ShaiMiz/RideOnESP32/docs/hardware/photos/2026-11-02-stock-controller-gap.jpg

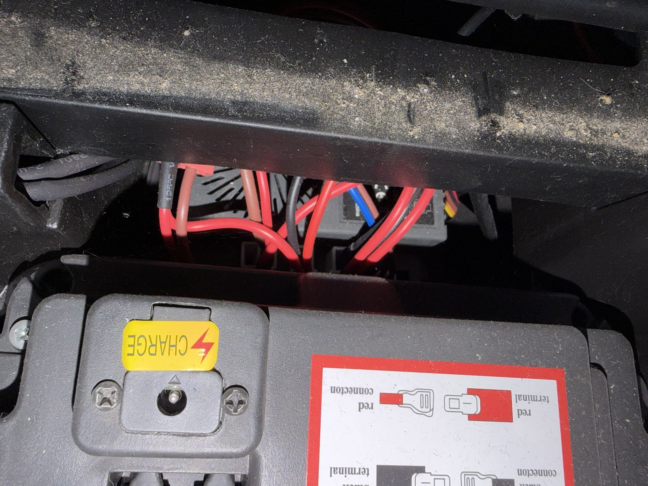
docs/hardware/photos/2026-11-02-stock-controller-gap.jpg
