ShaiMiz/RideOnESP32/docs/hardware/photos/2026-11-02-stock-under-seat.jpg

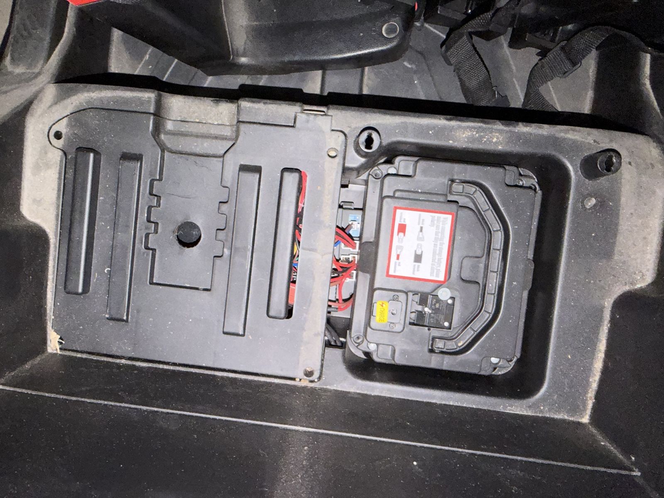
docs/hardware/photos/2026-11-02-stock-under-seat.jpg
