ShaiMiz/RideOnESP32/docs/hardware/photos/README.md

# As-built photos

Photos of the real wiring, named `YYYY-MM-DD-what.jpg` (for example `2026-11-02-power-chain.jpg`). They record what was actually built, which the old project never had.
