ShaiMiz/RideOnESP32/docs/hardware/kicad/NETS.md

<!-- Generated by gen/generate.py from gen/design.py and gen/wiring.py. Edit those, not this file. -->

# Nets (v0.3)

Every net in the schematic with its default wire gauge, colour and protecting fuse, the sheets it appears on and every pin on it. ESP32 signal names are the constants in include/pins.h.

| Net | AWG | Colour | Protected by | Sheets | Pins |
|---|---|---|---|---|---|
| `12V_ACC` | 14 | OG | F6 10 A (24 V side) | accessories rails | F10.1, F9.1, U4.OUT+ |
| `3V3_SENSE` | 22 | VT | U2 current limit | controller drive harness i2c_io rails | D101.1, D102.1, D103.1, D104.1, D105.1, D20.1, J10.5, J11.1, R22.1, R23.1, R24.1, R25.1, R26.1, R27.1, U10.7, U11.7, U12.7, U13.7, U14.7, U2.VOUT, U22.VDD, U23.ADDR, U23.VDD, U24.VCC, U25.VCC, U26.VCC, U27.VCC, U28.VCC, U31.VDD |
| `5V_ACC` | 20 | RD | U3 current limit, F5 | accessories rails | U3.OUT+, U30.1 |
| `5V_LOGIC` | 22 | RD | F4 2 A (24 V side) | controller harness rails | H1.1, H2.1, J10.1, U1.OUT+, U2.VIN, U20.L15, U21.5V, U33.VCC |
| `AMP_12V` | 16 | OG | F10 10 A | accessories | F10.2, U32.VIN+ |
| `BATTERY_SENSE` | 22 | BN | - | controller power | C1.1, R3.2, R4.1, U20.L3 |
| `BATT_DIV` | 22 | OG | F8 1 A | power | F8.2, R3.1 |
| `BATT_FUSED` | 10 | RD | F1 40 A | harness power | F1.2, F2.1, J1.1, K1.A |
| `BATT_RAW` | 10 | RD | none: keep ≤ 15 cm, battery + to F1 | harness | BT1.1, F1.1 |
| `BT_RXD` | 22 | WH | - | controller | R29.2, U33.RXD |
| `BUS_SENSE` | 22 | BN | - | i2c_io power | C2.1, R5.2, R6.1, U23.A2 |
| `COIL_24V` | 20 | OG | F3 1 A | harness power | D1.1, J9.2, K1.C+, S2.22 |
| `COIL_FEED` | 20 | OG | F3 1 A | harness power | F3.2, J9.1, S2.11 |
| `COIL_LOW` | 20 | OG | F3 1 A | power | D1.2, K1.C-, Q1.D |
| `CONTACTOR_HOLD` | 22 | YE | - | controller power | R1.1, R2.1, U20.L12 |
| `CRSF_RX` | 22 | WH | - | controller | U20.R10, U21.TX |
| `CRSF_TX` | 22 | WH | - | controller | U20.R9, U21.RX |
| `DF_RX` | 22 | WH | - | accessories controller | R28.2, U30.2 |
| `DRIVE_EN` | 22 | YE | - | controller drive | R111.1, R112.1, R113.1, R114.1, U10.3, U10.4, U11.3, U11.4, U12.3, U12.4, U13.3, U13.4, U20.R5 |
| `ESTOP_MID` | 20 | OG | F3 1 A | harness | S2.12, S2.21 |
| `ESTOP_SENSE` | 22 | WH | - | harness i2c_io | J9.3, S2.33, U24.P3 |
| `FAN_24V` | 20 | OG | F7 1 A | accessories power | F7.2, FAN1.1, FAN2.1 |
| `FAN_LOW` | 20 | BK/WH | F7 1 A | accessories | FAN1.2, FAN2.2, U29.OUT2 |
| `FAN_PWM` | 22 | BU | - | accessories i2c_io | U28.PWM1, U29.IN2 |
| `FL_DRV_POS` | 12 | RD | F1 40 A + driver current limit | drive | F11.1, U10.M+ |
| `FL_LPWM` | 22 | BU | - | controller drive | U10.2, U20.L9 |
| `FL_M_NEG` | 12 | BK | F1 40 A + driver current limit | drive harness | C201.2, J6.2, M1.2, U10.M- |
| `FL_M_POS` | 12 | RD | F11-F14 15 A (one per motor) | drive harness | C201.1, F11.2, J6.1, M1.1 |
| `FL_RPWM` | 22 | BU | - | controller drive | U10.1, U20.L8 |
| `FR_DRV_POS` | 12 | RD | F1 40 A + driver current limit | drive | F12.1, U11.M+ |
| `FR_LPWM` | 22 | BU | - | controller drive | U11.2, U20.L11 |
| `FR_M_NEG` | 12 | BK | F1 40 A + driver current limit | drive harness | C202.2, J6.4, M2.2, U11.M- |
| `FR_M_POS` | 12 | RD | F11-F14 15 A (one per motor) | drive harness | C202.1, F12.2, J6.3, M2.1 |
| `FR_RPWM` | 22 | BU | - | controller drive | U11.1, U20.L10 |
| `GND` | 22 | BK | - | accessories controller drive harness i2c_io power rails | BT1.2, C1.2, C101.2, C102.2, C103.2, C104.2, C105.2, C111.2, C112.2, C113.2, C114.2, C115.2, C2.2, C20.2, C21.2, C22.2, D2.2, H1.2, H2.2, J1.2, J10.2, J11.2, J3.3, J4.3, J8.4, J9.4, PED1.GND, Q1.S, R111.2, R112.2, R113.2, R114.2, R115.2, R2.2, R21.2, R4.2, R6.2, R7.2, S2.34, SW2.2, SW3.2, SW4.2, SW5.2, TB1.1, TB1.10, TB1.11, TB1.12, TB1.2, TB1.3, TB1.4, TB1.5, TB1.6, TB1.7, TB1.8, TB1.9, U1.IN-, U1.OUT-, U10.8, U10.B-, U11.8, U11.B-, U12.8, U12.B-, U13.8, U13.B-, U14.8, U14.B-, U2.GND, U20.L14, U20.R14, U21.GND, U22.ADDR, U22.GND, U23.GND, U24.GND, U25.DIR, U25.GND, U26.AD0, U26.GND, U27.GND, U28.GND, U28.OE, U29.GND, U29.PGND, U3.IN-, U3.OUT-, U30.7, U31.GND, U32.VIN-, U33.GND, U4.IN-, U4.OUT- |
| `HORN` | 22 | WH | - | harness i2c_io | J8.3, SW4.1, U24.P2 |
| `I2C_SCL` | 22 | GY | - | controller harness i2c_io | J10.6, J11.3, R25.2, U20.R2, U22.SCL, U23.SCL, U24.SCL, U25.SCL, U26.SCL, U27.SCL, U28.SCL |
| `I2C_SDA` | 22 | GN | - | controller harness i2c_io | J10.7, J11.4, R26.2, U20.R1, U22.SDA, U23.SDA, U24.SDA, U25.SDA, U26.SDA, U27.SDA, U28.SDA |
| `IS_FL` | 22 | BN | - | drive i2c_io | C101.1, D101.2, R101.2, U22.A0 |
| `IS_FL_RAW` | 22 | BN | - | drive | R101.1, U10.5, U10.6 |
| `IS_FR` | 22 | BN | - | drive i2c_io | C102.1, D102.2, R102.2, U22.A1 |
| `IS_FR_RAW` | 22 | BN | - | drive | R102.1, U11.5, U11.6 |
| `IS_RL` | 22 | BN | - | drive i2c_io | C103.1, D103.2, R103.2, U22.A2 |
| `IS_RL_RAW` | 22 | BN | - | drive | R103.1, U12.5, U12.6 |
| `IS_RR` | 22 | BN | - | drive i2c_io | C104.1, D104.2, R104.2, U22.A3 |
| `IS_RR_RAW` | 22 | BN | - | drive | R104.1, U13.5, U13.6 |
| `IS_ST` | 22 | BN | - | drive i2c_io | C105.1, D105.2, R105.2, U23.A0 |
| `IS_ST_RAW` | 22 | BN | - | drive | R105.1, U14.5, U14.6 |
| `KEY_24V` | 14 | OG | F2 15 A | harness power | F3.1, F4.1, F5.1, F6.1, F7.1, F8.1, J2.2, SW1.2 |
| `KEY_FEED` | 14 | OG | F2 15 A | harness power | F2.2, J2.1, SW1.1 |
| `LIGHTS_12V` | 20 | OG | F9 3 A | accessories harness | F9.2, J8.1, LP1.1 |
| `LIGHTS_PWM` | 22 | BU | - | accessories i2c_io | U28.PWM0, U29.IN1 |
| `LIGHTS_SW` | 20 | BK/WH | F9 3 A | accessories harness | J8.2, LP1.2, U29.OUT1 |
| `LOG_TX` | 22 | WH | - | controller | R29.1, U20.R3 |
| `MOTOR_24V` | 10 | RD/YE | F1 40 A (after K1) | drive power | C111.1, C112.1, C113.1, C114.1, C115.1, D2.1, K1.B, R5.1, R7.1, TB2.1, TB2.2, TB2.3, TB2.4, TB2.5, TB2.6, TB2.7, TB2.8, U10.B+, U11.B+, U12.B+, U13.B+, U14.B+ |
| `ONEWIRE_TEMP` | 22 | WH | - | controller | R27.2, U20.R13, U31.DQ |
| `PEDAL` | 22 | BN | - | controller | C20.1, D20.2, R20.2, U20.L2 |
| `PEDAL_IN` | 22 | BN | - | controller harness | J3.2, PED1.SIG, R20.1, R21.1 |
| `PEDAL_VCC` | 22 | BN | - | controller harness | J3.1, PED1.V+, R22.2 |
| `Q1_GATE` | 22 | WH | - | power | Q1.G, R1.2 |
| `RL_DRV_POS` | 12 | RD | F1 40 A + driver current limit | drive | F13.1, U12.M+ |
| `RL_LPWM` | 22 | BU | - | controller drive | U12.2, U20.L7 |
| `RL_M_NEG` | 12 | BK | F1 40 A + driver current limit | drive harness | C203.2, J7.2, M3.2, U12.M- |
| `RL_M_POS` | 12 | RD | F11-F14 15 A (one per motor) | drive harness | C203.1, F13.2, J7.1, M3.1 |
| `RL_RPWM` | 22 | BU | - | controller drive | U12.1, U20.L6 |
| `RR_DRV_POS` | 12 | RD | F1 40 A + driver current limit | drive | F14.1, U13.M+ |
| `RR_LPWM` | 22 | BU | - | controller drive | U13.2, U20.R11 |
| `RR_M_NEG` | 12 | BK | F1 40 A + driver current limit | drive harness | C204.2, J7.4, M4.2, U13.M- |
| `RR_M_POS` | 12 | RD | F11-F14 15 A (one per motor) | drive harness | C204.1, F14.2, J7.3, M4.1 |
| `RR_RPWM` | 22 | BU | - | controller drive | U13.1, U20.L13 |
| `SEAT` | 22 | WH | - | harness i2c_io | J10.8, SW5.1, U24.P4 |
| `SHIFT_FORWARD` | 22 | WH | - | harness i2c_io | J4.1, SW2.1, U24.P0 |
| `SHIFT_REVERSE` | 22 | WH | - | harness i2c_io | J4.2, SW3.1, U24.P1 |
| `SOUND_TX` | 22 | WH | - | controller | R28.1, U20.R8 |
| `SPK_ALERT_N` | 18 | BK | amp output | accessories harness | J11.6, LS1.2, U30.8 |
| `SPK_ALERT_P` | 18 | RD | amp output | accessories harness | J11.5, LS1.1, U30.6 |
| `SPK_L_N` | 18 | BK | amp output | accessories harness | J12.2, LS2.2, U32.L- |
| `SPK_L_P` | 18 | RD | amp output | accessories harness | J12.1, LS2.1, U32.L+ |
| `SPK_R_N` | 18 | BK | amp output | accessories harness | J12.4, LS3.2, U32.R- |
| `SPK_R_P` | 18 | RD | amp output | accessories harness | J12.3, LS3.1, U32.R+ |
| `STEER_EN` | 22 | YE | - | controller drive | R115.1, U14.3, U14.4, U20.R12 |
| `STEER_LPWM` | 22 | BU | - | controller drive | U14.2, U20.R6 |
| `STEER_M_NEG` | 12 | BK | F1 40 A + driver current limit | drive harness | C205.2, J5.2, M5.2, U14.M- |
| `STEER_M_POS` | 12 | RD | F1 40 A | drive harness | C205.1, J5.1, M5.1, U14.M+ |
| `STEER_RPWM` | 22 | BU | - | controller drive | U14.1, U20.R7 |
| `U1_IN` | 20 | OG | F4 2 A | power rails | F4.2, U1.IN+ |
| `U3_IN` | 20 | OG | F5 3 A | power rails | F5.2, U3.IN+ |
| `U4_IN` | 16 | OG | F6 10 A | power rails | F6.2, U4.IN+ |
| `WHEEL_SPEED_L` | 22 | WH | - | controller harness | C21.1, H1.3, J10.3, R23.2, U20.L4 |
| `WHEEL_SPEED_R` | 22 | WH | - | controller harness | C22.1, H2.3, J10.4, R24.2, U20.L5 |
