ShaiMiz/RideOnESP32/docs/hardware/kicad/WIRE_LIST.md

<!-- Generated by gen/generate.py from gen/design.py and gen/wiring.py. Edit those, not this file. -->

# Wire list (v0.3)

Every physical wire, generated from the schematic and checked against it: both ends of each run are on the same net, and every pin is reached by a wire, sits on the interface board A1, or is listed at the bottom with the reason. Label each wire at both ends with its W number (heat-shrink labels).

Lengths are not given yet: they wait on the box and under-seat measurements (#18). Gauges are minimums; a heavier wire is always fine. A1:GND, A1:3V3 and A1:5V are the bus strips on the interface board.

## Rules

- **Every fuse protects the wire after it:** the wire is rated above the fuse. 10 AWG after F1 (40 A), 14 AWG after F2 (15 A), 16 AWG after F6/F10 (10 A), 20-22 AWG after the 1-3 A fuses.
- **The only unfused copper** is battery + to F1: keep it under 15 cm and away from metal edges.
- **One ground star (TB1).** Battery −, every driver B−, the buck inputs and the A1 ground bus land there and nowhere else.
- **Run each B+ beside its B−,** and each PWM/EN pair beside a GND wire, to keep loops small.
- **Kill lines (yellow)** never share a connector pin with anything else and never get a pull-up.
- **Motor leads** are protected by F1 and by the BTS7960's own current limit; 12 AWG is rated well above one motor's current.

## Colour code

| Code | Colour | Use |
|---|---|---|
| RD | red | battery + and motor + side (10/12 AWG); 5 V rails (22 AWG) |
| RD/YE | red, yellow band | MOTOR_24V: switched by K1 |
| BK | black | ground, motor − side |
| OG | orange (or red + orange band) | key-switched 24 V branches after F2-F8, 12 V branches |
| VT | violet | 3V3_SENSE |
| YE | yellow | kill lines: DRIVE_EN, STEER_EN, CONTACTOR_HOLD |
| BU | blue | motor PWM (RPWM and LPWM) |
| GY | grey | I2C SCL |
| GN | green | I2C SDA |
| BN | brown | analog: IS sense, pedal, battery sense |
| WH | white | digital inputs, UART, 1-Wire, switch lines |
| BK/WH | black, white band | low-side switched returns (lights, fans) |

## New lead at the battery (2 wires)

| Wire | From | To | Net | AWG | Colour | Protected by | Note |
|---|---|---|---|---|---|---|---|
| W001 | BT1.1 | F1.1 | `BATT_RAW` | 10 | RD | none: keep ≤ 15 cm, battery + to F1 | Ring lug on battery +; ≤ 15 cm, unfused |
| W002 | F1.2 | J1.1 | `BATT_FUSED` | 10 | RD | F1 40 A | Or the stock battery lead if it already has a 40 A fuse this close |

## Inside the box (176 wires)

| Wire | From | To | Net | AWG | Colour | Protected by | Note |
|---|---|---|---|---|---|---|---|
| W004 | J1.1 | K1.A | `BATT_FUSED` | 10 | RD | F1 40 A | M6/M8 ring lugs |
| W005 | J1.2 | TB1.1 | `GND` | 10 | BK | - | Battery − to the ground star |
| W006 | K1.B | TB2.1 | `MOTOR_24V` | 10 | RD/YE | F1 40 A (after K1) |  |
| W007 | TB2.2 | U10.B+ | `MOTOR_24V` | 10 | RD/YE | F1 40 A (after K1) | 470 µF cap on the same terminal |
| W008 | U10.B- | TB1.2 | `GND` | 10 | BK | - | Run beside the B+ wire |
| W009 | TB2.3 | U11.B+ | `MOTOR_24V` | 10 | RD/YE | F1 40 A (after K1) | 470 µF cap on the same terminal |
| W010 | U11.B- | TB1.3 | `GND` | 10 | BK | - | Run beside the B+ wire |
| W011 | TB2.4 | U12.B+ | `MOTOR_24V` | 10 | RD/YE | F1 40 A (after K1) | 470 µF cap on the same terminal |
| W012 | U12.B- | TB1.4 | `GND` | 10 | BK | - | Run beside the B+ wire |
| W013 | TB2.5 | U13.B+ | `MOTOR_24V` | 10 | RD/YE | F1 40 A (after K1) | 470 µF cap on the same terminal |
| W014 | U13.B- | TB1.5 | `GND` | 10 | BK | - | Run beside the B+ wire |
| W015 | TB2.6 | U14.B+ | `MOTOR_24V` | 10 | RD/YE | F1 40 A (after K1) | 470 µF cap on the same terminal |
| W016 | U14.B- | TB1.6 | `GND` | 10 | BK | - | Run beside the B+ wire |
| W017 | K1.A | F2.1 | `BATT_FUSED` | 12 | RD | F1 40 A | The holder's own short 12 AWG lead, ring lug on K1 stud A |
| W018 | F2.2 | J2.1 | `KEY_FEED` | 14 | OG | F2 15 A |  |
| W021 | J2.2 | F3.1 | `KEY_24V` | 14 | OG | F2 15 A | Fuse block bus input; the bus feeds F3-F8 |
| W022 | F3.2 | J9.1 | `COIL_FEED` | 20 | OG | F3 1 A |  |
| W026 | J9.2 | K1.C+ | `COIL_24V` | 20 | OG | F3 1 A | D1 soldered across the coil tabs |
| W027 | K1.C- | Q1.D | `COIL_LOW` | 20 | OG | F3 1 A | To A1 |
| W030 | J9.3 | U24.P3 | `ESTOP_SENSE` | 20 | WH | - |  |
| W031 | J9.4 | A1:GND (interface board bus) | `GND` | 20 | BK | - |  |
| W032 | U20.L12 | R1.1 | `CONTACTOR_HOLD` | 22 | YE | - | Twist with a GND wire |
| W033 | F4.2 | U1.IN+ | `U1_IN` | 20 | OG | F4 2 A |  |
| W034 | F5.2 | U3.IN+ | `U3_IN` | 20 | OG | F5 3 A |  |
| W035 | F6.2 | U4.IN+ | `U4_IN` | 16 | OG | F6 10 A |  |
| W036 | F7.2 | FAN1.1 | `FAN_24V` | 20 | OG | F7 1 A |  |
| W037 | FAN1.1 | FAN2.1 | `FAN_24V` | 20 | OG | F7 1 A |  |
| W038 | FAN1.2 | U29.OUT2 | `FAN_LOW` | 20 | BK/WH | F7 1 A |  |
| W039 | FAN2.2 | U29.OUT2 | `FAN_LOW` | 20 | BK/WH | F7 1 A |  |
| W040 | F8.2 | R3.1 | `BATT_DIV` | 22 | OG | F8 1 A | To A1 |
| W041 | U1.IN- | TB1.7 | `GND` | 20 | BK | - | IN− and OUT− are joined inside the module |
| W042 | U3.IN- | TB1.8 | `GND` | 20 | BK | - |  |
| W043 | U4.IN- | TB1.9 | `GND` | 16 | BK | - |  |
| W044 | A1:GND (interface board bus) | TB1.10 | `GND` | 18 | BK | - | A1 ground bus: the only logic-ground wire to the star |
| W045 | U29.PGND | TB1.11 | `GND` | 20 | BK | - |  |
| W046 | U32.VIN- | TB1.12 | `GND` | 16 | BK | - |  |
| W047 | U1.OUT+ | A1:5V (interface board bus) | `5V_LOGIC` | 20 | RD | F4 2 A (24 V side) |  |
| W048 | A1:5V (interface board bus) | U20.L15 | `5V_LOGIC` | 22 | RD | F4 2 A (24 V side) | ESP32 VIN: 5 V, never 3.3 V |
| W049 | A1:5V (interface board bus) | U21.5V | `5V_LOGIC` | 22 | RD | F4 2 A (24 V side) |  |
| W050 | A1:5V (interface board bus) | U2.VIN | `5V_LOGIC` | 22 | RD | F4 2 A (24 V side) |  |
| W051 | A1:5V (interface board bus) | J10.1 | `5V_LOGIC` | 20 | RD | F4 2 A (24 V side) | Hall sensor supply |
| W052 | U2.VOUT | A1:3V3 (interface board bus) | `3V3_SENSE` | 22 | VT | U2 current limit |  |
| W053 | U2.GND | A1:GND (interface board bus) | `GND` | 22 | BK | - |  |
| W054 | U20.L14 | A1:GND (interface board bus) | `GND` | 22 | BK | - | R14 GND is joined on the board |
| W055 | U21.GND | A1:GND (interface board bus) | `GND` | 22 | BK | - |  |
| W056 | U3.OUT+ | U30.1 | `5V_ACC` | 20 | RD | U3 current limit, F5 | DFPlayer VCC |
| W057 | U30.7 | A1:GND (interface board bus) | `GND` | 22 | BK | - |  |
| W058 | U4.OUT+ | F9.1 | `12V_ACC` | 14 | OG | F6 10 A (24 V side) |  |
| W059 | F9.1 | F10.1 | `12V_ACC` | 14 | OG | F6 10 A (24 V side) | Second inline holder on the same 12 V lead |
| W060 | F10.2 | U32.VIN+ | `AMP_12V` | 16 | OG | F10 10 A |  |
| W061 | F9.2 | J8.1 | `LIGHTS_12V` | 20 | OG | F9 3 A | Lights supply |
| W062 | U29.OUT1 | J8.2 | `LIGHTS_SW` | 20 | BK/WH | F9 3 A | Lights low side |
| W063 | U20.L8 | U10.1 | `FL_RPWM` | 22 | BU | - | Control cable: twist PWM and EN with GND |
| W064 | U20.L9 | U10.2 | `FL_LPWM` | 22 | BU | - |  |
| W065 | U20.R5 | U10.3 | `DRIVE_EN` | 22 | YE | - | DRIVE_EN daisy chain, ESP32 → FL → FR → RL → RR |
| W066 | U20.L10 | U11.1 | `FR_RPWM` | 22 | BU | - | Control cable: twist PWM and EN with GND |
| W067 | U20.L11 | U11.2 | `FR_LPWM` | 22 | BU | - |  |
| W068 | U10.3 | U11.3 | `DRIVE_EN` | 22 | YE | - | DRIVE_EN daisy chain, ESP32 → FL → FR → RL → RR |
| W069 | U20.L6 | U12.1 | `RL_RPWM` | 22 | BU | - | Control cable: twist PWM and EN with GND |
| W070 | U20.L7 | U12.2 | `RL_LPWM` | 22 | BU | - |  |
| W071 | U11.3 | U12.3 | `DRIVE_EN` | 22 | YE | - | DRIVE_EN daisy chain, ESP32 → FL → FR → RL → RR |
| W072 | U20.L13 | U13.1 | `RR_RPWM` | 22 | BU | - | Control cable: twist PWM and EN with GND |
| W073 | U20.R11 | U13.2 | `RR_LPWM` | 22 | BU | - |  |
| W074 | U12.3 | U13.3 | `DRIVE_EN` | 22 | YE | - | DRIVE_EN daisy chain, ESP32 → FL → FR → RL → RR |
| W075 | U10.3 | U10.4 | `DRIVE_EN` | 22 | YE | - | Jumper in the plug: R_EN = L_EN; the 10k pull-down sits in the plug too |
| W076 | U10.5 | U10.6 | `IS_FL_RAW` | 22 | BN | - | Jumper in the plug: R_IS = L_IS |
| W077 | U10.5 | R101.1 | `IS_FL_RAW` | 22 | BN | - | IS to A1 |
| W078 | A1:3V3 (interface board bus) | U10.7 | `3V3_SENSE` | 22 | VT | U2 current limit | Logic VCC |
| W079 | A1:GND (interface board bus) | U10.8 | `GND` | 22 | BK | - | Signal reference; B− is the power ground |
| W080 | U10.M+ | J6.1 | `FL_M_POS` | 12 | RD | F1 40 A + driver current limit |  |
| W081 | U10.M- | J6.2 | `FL_M_NEG` | 12 | BK | F1 40 A + driver current limit |  |
| W082 | U11.3 | U11.4 | `DRIVE_EN` | 22 | YE | - | Jumper in the plug: R_EN = L_EN; the 10k pull-down sits in the plug too |
| W083 | U11.5 | U11.6 | `IS_FR_RAW` | 22 | BN | - | Jumper in the plug: R_IS = L_IS |
| W084 | U11.5 | R102.1 | `IS_FR_RAW` | 22 | BN | - | IS to A1 |
| W085 | A1:3V3 (interface board bus) | U11.7 | `3V3_SENSE` | 22 | VT | U2 current limit | Logic VCC |
| W086 | A1:GND (interface board bus) | U11.8 | `GND` | 22 | BK | - | Signal reference; B− is the power ground |
| W087 | U11.M+ | J6.3 | `FR_M_POS` | 12 | RD | F1 40 A + driver current limit |  |
| W088 | U11.M- | J6.4 | `FR_M_NEG` | 12 | BK | F1 40 A + driver current limit |  |
| W089 | U12.3 | U12.4 | `DRIVE_EN` | 22 | YE | - | Jumper in the plug: R_EN = L_EN; the 10k pull-down sits in the plug too |
| W090 | U12.5 | U12.6 | `IS_RL_RAW` | 22 | BN | - | Jumper in the plug: R_IS = L_IS |
| W091 | U12.5 | R103.1 | `IS_RL_RAW` | 22 | BN | - | IS to A1 |
| W092 | A1:3V3 (interface board bus) | U12.7 | `3V3_SENSE` | 22 | VT | U2 current limit | Logic VCC |
| W093 | A1:GND (interface board bus) | U12.8 | `GND` | 22 | BK | - | Signal reference; B− is the power ground |
| W094 | U12.M+ | J7.1 | `RL_M_POS` | 12 | RD | F1 40 A + driver current limit |  |
| W095 | U12.M- | J7.2 | `RL_M_NEG` | 12 | BK | F1 40 A + driver current limit |  |
| W096 | U13.3 | U13.4 | `DRIVE_EN` | 22 | YE | - | Jumper in the plug: R_EN = L_EN; the 10k pull-down sits in the plug too |
| W097 | U13.5 | U13.6 | `IS_RR_RAW` | 22 | BN | - | Jumper in the plug: R_IS = L_IS |
| W098 | U13.5 | R104.1 | `IS_RR_RAW` | 22 | BN | - | IS to A1 |
| W099 | A1:3V3 (interface board bus) | U13.7 | `3V3_SENSE` | 22 | VT | U2 current limit | Logic VCC |
| W100 | A1:GND (interface board bus) | U13.8 | `GND` | 22 | BK | - | Signal reference; B− is the power ground |
| W101 | U13.M+ | J7.3 | `RR_M_POS` | 12 | RD | F1 40 A + driver current limit |  |
| W102 | U13.M- | J7.4 | `RR_M_NEG` | 12 | BK | F1 40 A + driver current limit |  |
| W103 | U20.R7 | U14.1 | `STEER_RPWM` | 22 | BU | - | Control cable: twist PWM and EN with GND |
| W104 | U20.R6 | U14.2 | `STEER_LPWM` | 22 | BU | - |  |
| W105 | U20.R12 | U14.3 | `STEER_EN` | 22 | YE | - | STEER_EN |
| W106 | U14.3 | U14.4 | `STEER_EN` | 22 | YE | - | Jumper in the plug: R_EN = L_EN; the 10k pull-down sits in the plug too |
| W107 | U14.5 | U14.6 | `IS_ST_RAW` | 22 | BN | - | Jumper in the plug: R_IS = L_IS |
| W108 | U14.5 | R105.1 | `IS_ST_RAW` | 22 | BN | - | IS to A1 |
| W109 | A1:3V3 (interface board bus) | U14.7 | `3V3_SENSE` | 22 | VT | U2 current limit | Logic VCC |
| W110 | A1:GND (interface board bus) | U14.8 | `GND` | 22 | BK | - | Signal reference; B− is the power ground |
| W111 | U14.M+ | J5.1 | `STEER_M_POS` | 12 | RD | F1 40 A + driver current limit |  |
| W112 | U14.M- | J5.2 | `STEER_M_NEG` | 12 | BK | F1 40 A + driver current limit |  |
| W123 | U20.L2 | R20.2 | `PEDAL` | 22 | BN | - | PEDAL to A1 |
| W124 | U20.L3 | R3.2 | `BATTERY_SENSE` | 22 | BN | - | BATTERY_SENSE to A1 |
| W125 | U20.L4 | R23.2 | `WHEEL_SPEED_L` | 22 | WH | - | WHEEL_SPEED_L to A1 |
| W126 | U20.L5 | R24.2 | `WHEEL_SPEED_R` | 22 | WH | - | WHEEL_SPEED_R to A1 |
| W127 | U20.R13 | R27.2 | `ONEWIRE_TEMP` | 22 | WH | - | ONEWIRE_TEMP to A1 |
| W128 | U20.R8 | R28.1 | `SOUND_TX` | 22 | WH | - | SOUND_TX to A1 |
| W129 | R28.2 | U30.2 | `DF_RX` | 22 | WH | - | DF_RX |
| W130 | U20.R10 | U21.TX | `CRSF_RX` | 22 | WH | - | CRSF: receiver TX → ESP32 RX |
| W131 | U20.R9 | U21.RX | `CRSF_TX` | 22 | WH | - | CRSF: ESP32 TX → receiver RX |
| W132 | R1.2 | Q1.G | `Q1_GATE` | 22 | WH | - | On A1 (listed because Q1 is a TO-220 on flying leads if not on the board) |
| W133 | R101.2 | U22.A0 | `IS_FL` | 22 | BN | - |  |
| W134 | R102.2 | U22.A1 | `IS_FR` | 22 | BN | - |  |
| W135 | R103.2 | U22.A2 | `IS_RL` | 22 | BN | - |  |
| W136 | R104.2 | U22.A3 | `IS_RR` | 22 | BN | - |  |
| W137 | R105.2 | U23.A0 | `IS_ST` | 22 | BN | - |  |
| W138 | R5.2 | R6.1 | `BUS_SENSE` | 22 | BN | - | BUS_SENSE from the R5 lead at TB2 to A1 |
| W139 | R6.1 | U23.A2 | `BUS_SENSE` | 22 | BN | - |  |
| W140 | R7.2 | A1:GND (interface board bus) | `GND` | 20 | BK | - | Bleed return |
| W141 | A1:3V3 (interface board bus) | R22.1 | `3V3_SENSE` | 22 | VT | U2 current limit | On A1 |
| W142 | R22.2 | J3.1 | `PEDAL_VCC` | 22 | BN | - | Pedal supply |
| W143 | J3.2 | R20.1 | `PEDAL_IN` | 22 | BN | - | Pedal signal |
| W144 | J3.3 | A1:GND (interface board bus) | `GND` | 22 | BK | - |  |
| W148 | U31.DQ | R27.2 | `ONEWIRE_TEMP` | 22 | WH | - | DS18B20 yellow |
| W149 | U31.VDD | A1:3V3 (interface board bus) | `3V3_SENSE` | 22 | VT | U2 current limit | DS18B20 red |
| W150 | U31.GND | A1:GND (interface board bus) | `GND` | 22 | BK | - | DS18B20 black |
| W151 | U20.R2 | U22.SCL | `I2C_SCL` | 22 | GY | - | I2C bus start; keep SCL and SDA beside GND |
| W152 | U20.R1 | U22.SDA | `I2C_SDA` | 22 | GN | - |  |
| W153 | A1:3V3 (interface board bus) | U22.VDD | `3V3_SENSE` | 22 | VT | U2 current limit |  |
| W154 | A1:GND (interface board bus) | U22.GND | `GND` | 22 | BK | - |  |
| W155 | U22.SCL | U23.SCL | `I2C_SCL` | 22 | GY | - | I2C chain |
| W156 | U22.SDA | U23.SDA | `I2C_SDA` | 22 | GN | - | I2C chain |
| W157 | U22.VDD | U23.VDD | `3V3_SENSE` | 22 | VT | U2 current limit | I2C chain |
| W158 | U22.GND | U23.GND | `GND` | 22 | BK | - | I2C chain |
| W159 | U23.SCL | U24.SCL | `I2C_SCL` | 22 | GY | - | I2C chain |
| W160 | U23.SDA | U24.SDA | `I2C_SDA` | 22 | GN | - | I2C chain |
| W161 | U23.VDD | U24.VCC | `3V3_SENSE` | 22 | VT | U2 current limit | I2C chain |
| W162 | U23.GND | U24.GND | `GND` | 22 | BK | - | I2C chain |
| W163 | U24.SCL | U26.SCL | `I2C_SCL` | 22 | GY | - | I2C chain |
| W164 | U24.SDA | U26.SDA | `I2C_SDA` | 22 | GN | - | I2C chain |
| W165 | U24.VCC | U26.VCC | `3V3_SENSE` | 22 | VT | U2 current limit | I2C chain |
| W166 | U24.GND | U26.GND | `GND` | 22 | BK | - | I2C chain |
| W167 | U26.SCL | U28.SCL | `I2C_SCL` | 22 | GY | - | I2C chain |
| W168 | U26.SDA | U28.SDA | `I2C_SDA` | 22 | GN | - | I2C chain |
| W169 | U26.VCC | U28.VCC | `3V3_SENSE` | 22 | VT | U2 current limit | I2C chain |
| W170 | U26.GND | U28.GND | `GND` | 22 | BK | - | I2C chain |
| W171 | U22.ADDR | U22.GND | `GND` | 22 | BK | - | Address 0x48 |
| W172 | U23.ADDR | U23.VDD | `3V3_SENSE` | 22 | VT | U2 current limit | Address 0x49 |
| W173 | U26.AD0 | U26.GND | `GND` | 22 | BK | - | Address 0x68 |
| W174 | U28.OE | U28.GND | `GND` | 22 | BK | - | Outputs always enabled |
| W175 | U28.SCL | J10.6 | `I2C_SCL` | 20 | GY | - | Off-box I2C branch: steering column |
| W176 | U28.SDA | J10.7 | `I2C_SDA` | 20 | GN | - |  |
| W177 | A1:3V3 (interface board bus) | J10.5 | `3V3_SENSE` | 20 | VT | U2 current limit |  |
| W178 | A1:GND (interface board bus) | J10.2 | `GND` | 20 | BK | - |  |
| W179 | U28.SCL | J11.3 | `I2C_SCL` | 20 | GY | - | Off-box I2C branch: dash |
| W180 | U28.SDA | J11.4 | `I2C_SDA` | 20 | GN | - |  |
| W181 | A1:3V3 (interface board bus) | J11.1 | `3V3_SENSE` | 20 | VT | U2 current limit |  |
| W182 | A1:GND (interface board bus) | J11.2 | `GND` | 20 | BK | - |  |
| W183 | U28.PWM0 | U29.IN1 | `LIGHTS_PWM` | 22 | BU | - | Lights PWM |
| W184 | U28.PWM1 | U29.IN2 | `FAN_PWM` | 22 | BU | - | Fan PWM |
| W185 | U29.GND | A1:GND (interface board bus) | `GND` | 22 | BK | - |  |
| W186 | J4.1 | U24.P0 | `SHIFT_FORWARD` | 22 | WH | - |  |
| W187 | J4.2 | U24.P1 | `SHIFT_REVERSE` | 22 | WH | - |  |
| W188 | J4.3 | A1:GND (interface board bus) | `GND` | 22 | BK | - |  |
| W193 | J8.3 | U24.P2 | `HORN` | 22 | WH | - | Horn button |
| W194 | J8.4 | A1:GND (interface board bus) | `GND` | 22 | BK | - |  |
| W199 | J10.8 | U24.P4 | `SEAT` | 20 | WH | - | Seat switch |
| W200 | J10.3 | R23.2 | `WHEEL_SPEED_L` | 20 | WH | - | WHEEL_SPEED_L to A1 |
| W201 | J10.4 | R24.2 | `WHEEL_SPEED_R` | 20 | WH | - | WHEEL_SPEED_R to A1 |
| W219 | U30.6 | J11.5 | `SPK_ALERT_P` | 18 | RD | amp output |  |
| W220 | U30.8 | J11.6 | `SPK_ALERT_N` | 18 | BK | amp output |  |
| W223 | U32.L+ | J12.1 | `SPK_L_P` | 18 | RD | amp output |  |
| W224 | U32.L- | J12.2 | `SPK_L_N` | 18 | BK | amp output |  |
| W225 | U32.R+ | J12.3 | `SPK_R_P` | 18 | RD | amp output |  |
| W226 | U32.R- | J12.4 | `SPK_R_N` | 18 | BK | amp output |  |

## Our new off-box harnesses (J9-J12) (28 wires)

| Wire | From | To | Net | AWG | Colour | Protected by | Note |
|---|---|---|---|---|---|---|---|
| W023 | J9.1 | S2.11 | `COIL_FEED` | 20 | OG | F3 1 A | E-stop cable, 4-core |
| W024 | S2.12 | S2.21 | `ESTOP_MID` | 20 | OG | F3 1 A | Jumper inside the E-stop: NC1 and NC2 in series |
| W025 | S2.22 | J9.2 | `COIL_24V` | 20 | OG | F3 1 A |  |
| W028 | S2.33 | J9.3 | `ESTOP_SENSE` | 20 | WH | - |  |
| W029 | S2.34 | J9.4 | `GND` | 20 | BK | - |  |
| W202 | J10.1 | H1.1 | `5V_LOGIC` | 20 | RD | F4 2 A (24 V side) | Split to both wheels |
| W203 | J10.1 | H2.1 | `5V_LOGIC` | 20 | RD | F4 2 A (24 V side) |  |
| W204 | J10.2 | H1.2 | `GND` | 20 | BK | - |  |
| W205 | J10.2 | H2.2 | `GND` | 20 | BK | - |  |
| W206 | J10.3 | H1.3 | `WHEEL_SPEED_L` | 20 | WH | - |  |
| W207 | J10.4 | H2.3 | `WHEEL_SPEED_R` | 20 | WH | - |  |
| W208 | J10.5 | U25.VCC | `3V3_SENSE` | 20 | VT | U2 current limit | AS5600: ≤ 30 cm of I2C, twisted with GND |
| W209 | J10.2 | U25.GND | `GND` | 20 | BK | - |  |
| W210 | J10.6 | U25.SCL | `I2C_SCL` | 20 | GY | - |  |
| W211 | J10.7 | U25.SDA | `I2C_SDA` | 20 | GN | - |  |
| W212 | U25.DIR | U25.GND | `GND` | 20 | BK | - | Jumper on the sensor board |
| W213 | J10.8 | SW5.1 | `SEAT` | 20 | WH | - |  |
| W214 | SW5.2 | J10.2 | `GND` | 20 | BK | - |  |
| W215 | J11.1 | U27.VCC | `3V3_SENSE` | 20 | VT | U2 current limit |  |
| W216 | J11.2 | U27.GND | `GND` | 20 | BK | - |  |
| W217 | J11.3 | U27.SCL | `I2C_SCL` | 20 | GY | - |  |
| W218 | J11.4 | U27.SDA | `I2C_SDA` | 20 | GN | - |  |
| W221 | J11.5 | LS1.1 | `SPK_ALERT_P` | 18 | RD | amp output |  |
| W222 | J11.6 | LS1.2 | `SPK_ALERT_N` | 18 | BK | amp output |  |
| W227 | J12.1 | LS2.1 | `SPK_L_P` | 18 | RD | amp output |  |
| W228 | J12.2 | LS2.2 | `SPK_L_N` | 18 | BK | amp output |  |
| W229 | J12.3 | LS3.1 | `SPK_R_P` | 18 | RD | amp output |  |
| W230 | J12.4 | LS3.2 | `SPK_R_N` | 18 | BK | amp output |  |

## The car's own harness: listed so the circuit is complete, not touched (24 wires)

| Wire | From | To | Net | AWG | Colour | Protected by | Note |
|---|---|---|---|---|---|---|---|
| W003 | BT1.2 | J1.2 | `GND` | stock | stock | - | Battery − |
| W019 | J2.1 | SW1.1 | `KEY_FEED` | stock | stock | F2 15 A | Key switch |
| W020 | SW1.2 | J2.2 | `KEY_24V` | stock | stock | F2 15 A |  |
| W113 | J6.1 | M1.1 | `FL_M_POS` | stock | stock | F1 40 A + driver current limit | Stock motor wiring (or the splitter, #33) |
| W114 | J6.2 | M1.2 | `FL_M_NEG` | stock | stock | F1 40 A + driver current limit | Stock motor wiring (or the splitter, #33) |
| W115 | J6.3 | M2.1 | `FR_M_POS` | stock | stock | F1 40 A + driver current limit | Stock motor wiring (or the splitter, #33) |
| W116 | J6.4 | M2.2 | `FR_M_NEG` | stock | stock | F1 40 A + driver current limit | Stock motor wiring (or the splitter, #33) |
| W117 | J7.1 | M3.1 | `RL_M_POS` | stock | stock | F1 40 A + driver current limit | Stock motor wiring (or the splitter, #33) |
| W118 | J7.2 | M3.2 | `RL_M_NEG` | stock | stock | F1 40 A + driver current limit | Stock motor wiring (or the splitter, #33) |
| W119 | J7.3 | M4.1 | `RR_M_POS` | stock | stock | F1 40 A + driver current limit | Stock motor wiring (or the splitter, #33) |
| W120 | J7.4 | M4.2 | `RR_M_NEG` | stock | stock | F1 40 A + driver current limit | Stock motor wiring (or the splitter, #33) |
| W121 | J5.1 | M5.1 | `STEER_M_POS` | stock | stock | F1 40 A + driver current limit | Stock motor wiring (or the splitter, #33) |
| W122 | J5.2 | M5.2 | `STEER_M_NEG` | stock | stock | F1 40 A + driver current limit | Stock motor wiring (or the splitter, #33) |
| W145 | J3.1 | PED1.V+ | `PEDAL_VCC` | stock | stock | - |  |
| W146 | J3.2 | PED1.SIG | `PEDAL_IN` | stock | stock | - |  |
| W147 | J3.3 | PED1.GND | `GND` | stock | stock | - |  |
| W189 | J4.1 | SW2.1 | `SHIFT_FORWARD` | stock | stock | - |  |
| W190 | SW2.2 | J4.3 | `GND` | stock | stock | - |  |
| W191 | J4.2 | SW3.1 | `SHIFT_REVERSE` | stock | stock | - |  |
| W192 | SW3.2 | J4.3 | `GND` | stock | stock | - |  |
| W195 | J8.3 | SW4.1 | `HORN` | stock | stock | - |  |
| W196 | SW4.2 | J8.4 | `GND` | stock | stock | - |  |
| W197 | J8.1 | LP1.1 | `LIGHTS_12V` | stock | stock | F9 3 A | Lights (voltage TBD) |
| W198 | LP1.2 | J8.2 | `LIGHTS_SW` | stock | stock | F9 3 A |  |

## Pins with no wire of their own

| Pin | Why |
|---|---|
| C111.1 | 470 µF leads under the driver's B+/B− screw terminals |
| C111.2 | 470 µF leads under the driver's B+/B− screw terminals |
| C112.1 | 470 µF leads under the driver's B+/B− screw terminals |
| C112.2 | 470 µF leads under the driver's B+/B− screw terminals |
| C113.1 | 470 µF leads under the driver's B+/B− screw terminals |
| C113.2 | 470 µF leads under the driver's B+/B− screw terminals |
| C114.1 | 470 µF leads under the driver's B+/B− screw terminals |
| C114.2 | 470 µF leads under the driver's B+/B− screw terminals |
| C115.1 | 470 µF leads under the driver's B+/B− screw terminals |
| C115.2 | 470 µF leads under the driver's B+/B− screw terminals |
| C201.1 | Soldered across the motor tabs |
| C201.2 | Soldered across the motor tabs |
| C202.1 | Soldered across the motor tabs |
| C202.2 | Soldered across the motor tabs |
| C203.1 | Soldered across the motor tabs |
| C203.2 | Soldered across the motor tabs |
| C204.1 | Soldered across the motor tabs |
| C204.2 | Soldered across the motor tabs |
| C205.1 | Soldered across the motor tabs |
| C205.2 | Soldered across the motor tabs |
| D1.1 | Soldered across the K1 coil tabs |
| D1.2 | Soldered across the K1 coil tabs |
| D2.1 | TVS on TB2 / TB1 (not fitted yet) |
| D2.2 | TVS on TB2 / TB1 (not fitted yet) |
| F4.1 | Fuse block common bus (fed by F3.1) |
| F5.1 | Fuse block common bus (fed by F3.1) |
| F6.1 | Fuse block common bus (fed by F3.1) |
| F7.1 | Fuse block common bus (fed by F3.1) |
| F8.1 | Fuse block common bus (fed by F3.1) |
| R111.1 | 10k soldered inside the driver's control plug, EN to GND |
| R111.2 | 10k soldered inside the driver's control plug, EN to GND |
| R112.1 | 10k soldered inside the driver's control plug, EN to GND |
| R112.2 | 10k soldered inside the driver's control plug, EN to GND |
| R113.1 | 10k soldered inside the driver's control plug, EN to GND |
| R113.2 | 10k soldered inside the driver's control plug, EN to GND |
| R114.1 | 10k soldered inside the driver's control plug, EN to GND |
| R114.2 | 10k soldered inside the driver's control plug, EN to GND |
| R115.1 | 10k soldered inside the driver's control plug, EN to GND |
| R115.2 | 10k soldered inside the driver's control plug, EN to GND |
| R5.1 | Lead in a ring lug on TB2.8 |
| R7.1 | Lead in a ring lug on TB2.8 |
| TB2.7 | Spare stud position (D2) |
| TB2.8 | Ring lug holding the R5 and R7 leads |
| U1.OUT- | Joined to IN− inside the module |
| U20.R14 | Joined to L14 on the board |
| U3.OUT- | Joined to IN− inside the module |
| U4.OUT- | Joined to IN− inside the module |
