ShaiMiz/RideOnESP32/docs/hardware/kicad/CONNECTORS.md

<!-- Generated by gen/generate.py from gen/design.py and gen/wiring.py. Edit those, not this file. -->

# Connectors and pinouts (v0.3)

Every plug on the box edge. **J1-J8 face the stock harness:** each must be the mate of the stock plug so the box swaps with the stock HY2005RX controller (plug and play). Their families, pin counts and pin order are **TBD** until the photos of the stock plugs (#17); the pin numbers below are our own until then. **J9-J12 are our own** sealed plugs for parts the stock car doesn't have.

J8 and J9 each carry a supply line (12 V lights, 24 V coil chain) next to a 3.3 V input of U24. A pin-to-pin short there could reach the PCF8574, so keep those pins apart: in J9 the coil pair (1, 2) sits away from the sense pair (3, 4); J8's order waits on the stock plug.

| Ref | Name | Pins | Faces | Part | Status |
|---|---|---|---|---|---|
| J1 | BATTERY | 2 | stock harness (TBD #17) | Mate of the stock battery plug (fallback: Anderson SB50) | TBD |
| J2 | KEY | 2 | stock harness (TBD #17) | Mate of the stock key-switch plug | TBD |
| J3 | PEDAL | 3 | stock harness (TBD #17) | Mate of the stock pedal plug | TBD |
| J4 | SHIFTER | 3 | stock harness (TBD #17) | Mate of the stock shifter plug | TBD |
| J5 | STEER MOTOR | 2 | stock harness (TBD #17) | Mate of the stock steering-motor plug (fallback: XT60, owned) | TBD |
| J6 | FRONT MOTORS | 4 | stock harness (TBD #17) | Mate of the stock front-motor plug(s); if the harness pairs the motors, a reversible splitter at the motor plugs (fallback: 2 x XT60) | TBD |
| J7 | REAR MOTORS | 4 | stock harness (TBD #17) | Mate of the stock rear-motor plug(s); splitter as J6 (fallback: 2 x XT60) | TBD |
| J8 | ACCESSORIES | 4 | stock harness (TBD #17) | Mate of the stock lights/horn plug (pin use TBD from photos) | TBD |
| J9 | E-STOP | 4 | our harness | Sealed 4-way, Deutsch DT04-4P / DT06-4S (or DT-style clone) | To buy |
| J10 | SENSORS | 8 | our harness | Sealed 8-way, Deutsch DT04-08PA / DT06-08SA (or clone) | To buy |
| J11 | DASH | 6 | our harness | Sealed 6-way, Deutsch DT04-6P / DT06-6S (or clone) | To buy |
| J12 | MUSIC | 4 | our harness | 4-way, Deutsch DT04-4P / DT06-4S (or clone) | To buy |

## J1 BATTERY

Mate of the stock battery plug (fallback: Anderson SB50). Status: TBD (#17).

| Pin | Net | AWG | Colour | Protected by | Box side | Car side |
|---|---|---|---|---|---|---|
| 1 | `BATT_FUSED` | 10 | RD | F1 40 A | K1.A (W004) | F1.2 (W002) |
| 2 | `GND` | 10 | BK | - | TB1.1 (W005) | BT1.2 (W003) |

## J2 KEY

Mate of the stock key-switch plug. Status: TBD (#17).

| Pin | Net | AWG | Colour | Protected by | Box side | Car side |
|---|---|---|---|---|---|---|
| 1 | `KEY_FEED` | 14 | OG | F2 15 A | F2.2 (W018) | SW1.1 (W019) |
| 2 | `KEY_24V` | 14 | OG | F2 15 A | F3.1 (W021) | SW1.2 (W020) |

## J3 PEDAL

Mate of the stock pedal plug. Status: TBD (#17).

| Pin | Net | AWG | Colour | Protected by | Box side | Car side |
|---|---|---|---|---|---|---|
| 1 | `PEDAL_VCC` | 22 | BN | - | R22.2 (W139) | PED1.V+ (W142) |
| 2 | `PEDAL_IN` | 22 | BN | - | R20.1 (W140) | PED1.SIG (W143) |
| 3 | `GND` | 22 | BK | - | A1:GND (W141) | PED1.GND (W144) |

## J4 SHIFTER

Mate of the stock shifter plug. Status: TBD (#17).

| Pin | Net | AWG | Colour | Protected by | Box side | Car side |
|---|---|---|---|---|---|---|
| 1 | `SHIFT_FORWARD` | 22 | WH | - | U24.P0 (W183) | SW2.1 (W186) |
| 2 | `SHIFT_REVERSE` | 22 | WH | - | U24.P1 (W184) | SW3.1 (W188) |
| 3 | `GND` | 22 | BK | - | A1:GND (W185) | SW2.2 (W187), SW3.2 (W189) |

## J5 STEER MOTOR

Mate of the stock steering-motor plug (fallback: XT60, owned). Status: TBD (#17).

| Pin | Net | AWG | Colour | Protected by | Box side | Car side |
|---|---|---|---|---|---|---|
| 1 | `STEER_M_POS` | 12 | RD | F1 40 A + driver current limit | U14.M+ (W111) | M5.1 (W121) |
| 2 | `STEER_M_NEG` | 12 | BK | F1 40 A + driver current limit | U14.M- (W112) | M5.2 (W122) |

## J6 FRONT MOTORS

Mate of the stock front-motor plug(s); if the harness pairs the motors, a reversible splitter at the motor plugs (fallback: 2 x XT60). Status: TBD (#17, #33).

| Pin | Net | AWG | Colour | Protected by | Box side | Car side |
|---|---|---|---|---|---|---|
| 1 | `FL_M_POS` | 12 | RD | F1 40 A + driver current limit | U10.M+ (W080) | M1.1 (W113) |
| 2 | `FL_M_NEG` | 12 | BK | F1 40 A + driver current limit | U10.M- (W081) | M1.2 (W114) |
| 3 | `FR_M_POS` | 12 | RD | F1 40 A + driver current limit | U11.M+ (W087) | M2.1 (W115) |
| 4 | `FR_M_NEG` | 12 | BK | F1 40 A + driver current limit | U11.M- (W088) | M2.2 (W116) |

## J7 REAR MOTORS

Mate of the stock rear-motor plug(s); splitter as J6 (fallback: 2 x XT60). Status: TBD (#17, #33).

| Pin | Net | AWG | Colour | Protected by | Box side | Car side |
|---|---|---|---|---|---|---|
| 1 | `RL_M_POS` | 12 | RD | F1 40 A + driver current limit | U12.M+ (W094) | M3.1 (W117) |
| 2 | `RL_M_NEG` | 12 | BK | F1 40 A + driver current limit | U12.M- (W095) | M3.2 (W118) |
| 3 | `RR_M_POS` | 12 | RD | F1 40 A + driver current limit | U13.M+ (W101) | M4.1 (W119) |
| 4 | `RR_M_NEG` | 12 | BK | F1 40 A + driver current limit | U13.M- (W102) | M4.2 (W120) |

## J8 ACCESSORIES

Mate of the stock lights/horn plug (pin use TBD from photos). Status: TBD (#17).

| Pin | Net | AWG | Colour | Protected by | Box side | Car side |
|---|---|---|---|---|---|---|
| 1 | `LIGHTS_12V` | 20 | OG | F9 3 A | F9.2 (W061) | LP1.1 (W194) |
| 2 | `LIGHTS_SW` | 20 | BK/WH | F9 3 A | U29.OUT1 (W062) | LP1.2 (W195) |
| 3 | `HORN` | 22 | WH | - | U24.P2 (W190) | SW4.1 (W192) |
| 4 | `GND` | 22 | BK | - | A1:GND (W191) | SW4.2 (W193) |

## J9 E-STOP

Sealed 4-way, Deutsch DT04-4P / DT06-4S (or DT-style clone). Status: To buy. Our own plug: E-stop on the dash.

| Pin | Net | AWG | Colour | Protected by | Box side | Car side |
|---|---|---|---|---|---|---|
| 1 | `COIL_FEED` | 20 | OG | F3 1 A | F3.2 (W022) | S2.11 (W023) |
| 2 | `COIL_24V` | 20 | OG | F3 1 A | K1.C+ (W026) | S2.22 (W025) |
| 3 | `ESTOP_SENSE` | 20 | WH | - | U24.P3 (W030) | S2.33 (W028) |
| 4 | `GND` | 20 | BK | - | A1:GND (W031) | S2.34 (W029) |

## J10 SENSORS

Sealed 8-way, Deutsch DT04-08PA / DT06-08SA (or clone). Status: To buy. Our own plug: halls, steering angle, seat.

| Pin | Net | AWG | Colour | Protected by | Box side | Car side |
|---|---|---|---|---|---|---|
| 1 | `5V_LOGIC` | 20 | RD | F4 2 A (24 V side) | A1:5V (W051) | H1.1 (W199), H2.1 (W200) |
| 2 | `GND` | 20 | BK | - | A1:GND (W175) | H1.2 (W201), H2.2 (W202), U25.GND (W206), SW5.2 (W211) |
| 3 | `WHEEL_SPEED_L` | 20 | WH | - | R23.2 (W197) | H1.3 (W203) |
| 4 | `WHEEL_SPEED_R` | 20 | WH | - | R24.2 (W198) | H2.3 (W204) |
| 5 | `3V3_SENSE` | 20 | VT | U2 current limit | A1:3V3 (W174) | U25.VCC (W205) |
| 6 | `I2C_SCL` | 20 | GY | - | U28.SCL (W172) | U25.SCL (W207) |
| 7 | `I2C_SDA` | 20 | GN | - | U28.SDA (W173) | U25.SDA (W208) |
| 8 | `SEAT` | 20 | WH | - | U24.P4 (W196) | SW5.1 (W210) |

## J11 DASH

Sealed 6-way, Deutsch DT04-6P / DT06-6S (or clone). Status: To buy. Our own plug: OLED and alert speaker.

| Pin | Net | AWG | Colour | Protected by | Box side | Car side |
|---|---|---|---|---|---|---|
| 1 | `3V3_SENSE` | 20 | VT | U2 current limit | A1:3V3 (W178) | U27.VCC (W212) |
| 2 | `GND` | 20 | BK | - | A1:GND (W179) | U27.GND (W213) |
| 3 | `I2C_SCL` | 20 | GY | - | U28.SCL (W176) | U27.SCL (W214) |
| 4 | `I2C_SDA` | 20 | GN | - | U28.SDA (W177) | U27.SDA (W215) |
| 5 | `SPK_ALERT_P` | 18 | RD | amp output | U30.6 (W216) | LS1.1 (W218) |
| 6 | `SPK_ALERT_N` | 18 | BK | amp output | U30.8 (W217) | LS1.2 (W219) |

## J12 MUSIC

4-way, Deutsch DT04-4P / DT06-4S (or clone). Status: To buy. Our own plug; music path only, never shared with the ESP32.

| Pin | Net | AWG | Colour | Protected by | Box side | Car side |
|---|---|---|---|---|---|---|
| 1 | `SPK_L_P` | 18 | RD | amp output | U32.L+ (W220) | LS2.1 (W224) |
| 2 | `SPK_L_N` | 18 | BK | amp output | U32.L- (W221) | LS2.2 (W225) |
| 3 | `SPK_R_P` | 18 | RD | amp output | U32.R+ (W222) | LS3.1 (W226) |
| 4 | `SPK_R_N` | 18 | BK | amp output | U32.R- (W223) | LS3.2 (W227) |
