ShaiMiz/RideOnESP32/docs/hardware/schematic/SCHEMATIC.md

# Draft schematic (v0.2, 17 Oct 2026)

v0.2: input pins follow the pin audit (PR #4). Wheel-speed halls on GPIO34/35, pedal on GPIO36, battery sense on GPIO39, because GPIO36/39 glitch LOW for about 80 ns on every ADC power-up (ESP32 errata) and can't count pulses. GPIO15 is ONEWIRE_TEMP.

A detailed **draft**, drawn before the stock plugs, motor and battery labels and box size are known. Everything marked TBD waits on the photos and measurements. Do not build from it until those are closed.

Sources: [WIRING.md](../WIRING.md), [POWER_CHAIN.md](../POWER_CHAIN.md), [BOM.md](../BOM.md), [include/pins.h](../../../include/pins.h), [include/config.h](../../../include/config.h), and the plug-and-play and per-wheel decisions of 17 Oct.

| Sheet | What it shows |
| --- | --- |
| [1 Overview](01-overview.svg) | Car side, the new box and its plugs J1–J11, off-box parts, how to go back to stock |
| [2 Power and safety](02-power-safety.svg) | Battery, F1, K1 contactor, key, E-stop, Q1 hold MOSFET, fuse block, U1–U4 rails, battery sense |
| [3 Drive, variant A](03-drive-ibt2.svg) | 4 × IBT-2 drive + 1 × IBT-2 steering, enable lines, current-sense networks, motor plugs |
| [4 Logic and sensors](04-logic-sensors.svg) | ESP32 pin by pin, receiver, pedal, hall sensors, I2C bus with all seven devices, PCF8574 switches, accessories |
| [5 Drive, variant B](05-drive-mdd20a.svg) | 2 × Cytron MDD20A (compact, for the stock box), PWM gate, external current sensors |

PNG copies sit next to each SVG. The sheets are generated by [generate.py](generate.py) (`python3 generate.py .`, then `./render.sh .` for PNGs), so edit the script, not the SVGs.

## Reference designators

| Ref | Part | Sheet |
| --- | --- | --- |
| BT1 | 24 V battery (chemistry TBD) | 2 |
| F1 | 40 A ANL or maxi fuse, ≤15 cm from battery + | 2 |
| F2 | 15 A, key feed | 2 |
| F3 | 1 A, K1 coil | 2 |
| F4 / F5 / F6 | 2 A / 3 A / 10 A, rail inputs (U1 / U3 / U4) | 2 |
| F7 | 1 A, box fans | 2 |
| F8 | 0.5 A, battery divider | 2 |
| SW1 | Key switch | 2 |
| S2 | Latching mushroom E-stop, two contact blocks: S2a NC, S2b NO | 2, 4 |
| K1 | Main contactor, 24 V coil, ≥80 A DC | 2 |
| D1 | 1N4007 flyback across K1 coil | 2 |
| Q1 | Logic-level N-MOSFET module (IRLZ44N), low side of K1 coil | 2 |
| R1, R2 | 100 Ω gate resistor, 10 k gate pull-down | 2 |
| R3, R4, C1 | 150 k / 12 k battery divider, 100 nF | 2 |
| U1 | LM2596 24 → 5.0 V (5V_LOGIC) | 2 |
| U2 | 3.3 V 1 A regulator from 5V_LOGIC (3V3_SENSE) | 2 |
| U3 | 24 → 5 V 5 A buck (5V_ACC) | 2 |
| U4 | 24 → 12 V 10–20 A sealed buck (12V_ACC) | 2 |
| U10–U13 | IBT-2 drive boards FL, FR, RL, RR | 3 |
| U14 | IBT-2 steering board | 3 |
| R1xA, C1xA, D1x | 4.7 k, 10 nF, clamp diode (BAT54 or 1N4148) per IS line, x = 0–4 | 3 |
| C1xB | 470 µF 35 V low-ESR at each board | 3 |
| R10B, R14B | 10 k pull-downs on DRIVE_EN and STEER_EN | 3 |
| U20 | ESP32-WROOM-32D 30-pin on MRD068A | 4 |
| U21 | Jumper AION RX Mini | 4 |
| U22, U23 | ADS1115 at 0x48, 0x49 | 4 |
| U24 | PCF8574 at 0x20 | 4 |
| U25 | AS5600 at 0x36 | 4 |
| U26 | MPU-6050 at 0x68 | 4 |
| U27 | SSD1306 OLED at 0x3C | 4 |
| U28 | PCA9685 at 0x40 | 4 |
| U29 | 4–8 channel low-side MOSFET board | 4 |
| U30 | DFPlayer Mini + LS1 3" 4 Ω speaker | 4 |
| U31 | DS18B20 probe | 4 |
| H1, H2 | A3144 hall sensors, left and right wheel | 4 |
| R20, R21, C20, D20 | Pedal input: 10 k series, 100 k pull-down, 100 nF, 3.3 V clamp | 4 |
| R22/C22, R23/C23 | Hall pull-ups 10 k to 3.3 V, 100 nF | 4 |
| R24, R25 | I2C pull-ups 4.7 k | 4 |
| U40 | 74LVC08 quad AND (variant B only) | 5 |
| U41, U42 | Cytron MDD20A front and rear (variant B only) | 5 |
| R40 | 10 k DRIVE_EN pull-down (variant B, replaces R10B) | 5 |
| J1–J8 | Mates for the stock plugs (types TBD) | 1 |
| J9–J11 | E-stop, sensors, dash: locking JST-XH or Molex | 1 |

## Netlist

| Net | Connects |
| --- | --- |
| BUS_F | F1 out, K1 pin 30, F2 |
| MOTOR_24V | K1 pin 87, B+ of U10–U14 (or VB+ of U41/U42), C1xB + |
| MOTOR_GND | Battery −, B− of U10–U14, C1xB −; star point |
| KEY_24V | SW1 out, F3, FB1 bus (F4–F8) |
| K1 coil | F3 → S2a (NC) → K1 86; K1 85 → Q1 drain; D1 across 86/85 |
| CONTACTOR_HOLD | GPIO12 → R1 → Q1 gate; R2 to GND |
| 5V_LOGIC | U1 out → ESP32 VIN, U21 5V, U2 in, H1/H2 VCC |
| 3V3_SENSE | U2 out → IBT-2 VCC ×5, U22–U28 VCC, U31, clamp diodes, pull-ups R22–R25, pedal V+ (if switch or pot) |
| 5V_ACC | U3 out → U30 DFPlayer, USB, LED strips |
| 12V_ACC | U4 out → U29 loads (lights, audio) |
| FAN_24V | F7 → fans → U29 channels (low side) |
| BATT_SENSE | R3/R4 junction, C1 → GPIO39 |
| FL/FR/RL/RR_RPWM, _LPWM | GPIO 25/26, 27/14, 32/33, 13/4 → RPWM/LPWM of U10–U13 |
| STEER_RPWM, _LPWM | GPIO18/19 → U14 |
| DRIVE_EN | GPIO21 → R_EN + L_EN of U10–U13; R10B to GND |
| STEER_EN | GPIO2 → R_EN + L_EN of U14; R14B to GND |
| IS_FL / FR / RL / RR | R_IS + L_IS of U10–U13 → R1xA → U22 A0–A3, with C1xA and D1x |
| IS_ST | U14 R_IS + L_IS → R14A → U23 A0 |
| CRSF | GPIO16 ← U21 TX, GPIO17 → U21 RX |
| SCL / SDA | GPIO22 / GPIO23, U22–U28, R24/R25 to 3V3_SENSE |
| PEDAL | J3 SIG → R20 → GPIO36, with R21, C20, D20 |
| WHEEL_L / WHEEL_R | H1 / H2 OUT → GPIO34 / GPIO35, with R22/C22, R23/C23 |
| ESTOP_SENSE | S2b (NO) to GND → U24 P3 |
| SHIFT_FWD, SHIFT_REV, HORN, SEAT | Switches to GND → U24 P0, P1, P2, P4 |
| SOUND_TX | GPIO5 → 1 k → U30 RX |
| ONEWIRE_TEMP | GPIO15 → U31 DQ, 4.7 k to 3V3_SENSE |
| ESP32 3V3 pin | Not connected |

## Open items (TBD)

1. **Stock plugs J1–J8:** connector family, pin count and which wire is which. Sets every box-edge connector.
2. **Motor pairing in the harness:** if the stock harness joins motors in pairs, J6/J7 become a new 4-lead cable to the motor plugs.
3. **Battery:** voltage, Ah and chemistry. The BTS7960 locks out above 27.5 V; the MDD20A tops out at 30 V.
4. **Motor labels:** current per motor, which settles variant A vs B (20 A vs 43 A per channel).
5. **Box size:** decides variant A (5 boards, bigger box) or B (2 boards, stock-size box).
6. **Key switch rating:** SW1 carries the coil and every rail (about 8 A worst case). If it is rated lower, it drives a 30 A relay instead.
7. **Pedal type:** switch, pot or hall throttle. A switch goes between V+ (3V3_SENSE) and SIG. A 5 V hall throttle needs a divider. Never connect a pedal line that carries 24 V.
8. **Shifter:** whether the stock F/R switch carries motor current or only signals. Only a signal switch can go to the PCF8574.
9. **IBT-2 IS resistor value** (config `IS_RESISTOR_OHMS`).
10. **K1 precharge:** decide after the bench test whether closing on 5 × 470 µF needs a precharge resistor.
11. **AS5600 cable length** to the steering column: over about 30 cm, use its analog OUT on ADS#2 A1 or a bus buffer.
12. **Variant B current sensors:** part and divider.

## Where this draft differs from the current docs

These are deliberate. If they're accepted, WIRING.md and POWER_CHAIN.md should be updated to match (the README asks for the docs and the diagram to agree).

1. **Main current path skips the blade fuse block.** POWER_CHAIN.md draws fuse block → contactor; blade blocks are rated around 30 A per way, so here F1 feeds a stud that goes straight to K1, and the fuse block only carries low-current ways.
2. **Rails are switched by the key.** POWER_CHAIN.md says the rails come from the "key side", but its diagram puts the key only in the coil path. Here the key feeds both, so key off turns everything off and E-stop keeps the ESP32 alive.
3. **Rail fuses sized on the 24 V input side:** 2 A / 3 A / 10 A instead of 2 A / 7.5 A / 15 A.
4. **OLED on 3.3 V, not 5 V.** Its on-board pull-ups would pull the 3.3 V I2C bus up to 5 V.
5. **A3144 hall sensors on 5 V.** They need at least 4.5 V; their open-collector output is still pulled up to 3.3 V, so the ESP32 is safe.
6. **E-stop needs a second NO contact block (S2b)** for ESTOP_SENSE, so firmware reads 0 = pressed as it expects.
7. **Pedal input protection** (series 10 k, 100 k pull-down, clamp, 100 nF) and a **10 nF filter** on each IS line are new.
8. **DS18B20 on GPIO15** (listed as spare), with the 4.7 k pull-up that also keeps the strapping pin HIGH at boot.
9. **DFPlayer on 5V_ACC** rather than the logic rail, so speaker current stays off the ESP32 supply.
10. **Variant B adds a 74LVC08 gate:** the MDD20A has no enable pin, so DRIVE_EN gates the PWM lines instead. It also has no current-sense output, so it needs four external sensors.
