ShaiMiz/RideOnESP32/docs/hardware/kicad/WIRE_LIST.csv

Wire | From | To | Net | AWG | Colour | Protected by | Route | Note
W001 | BT1.1 | F1.1 | BATT_RAW | 10 | RD | none: keep ≤ 15 cm, battery + to F1 | adapter | Ring lug on battery +; ≤ 15 cm, unfused
W002 | F1.2 | J1.1 | BATT_FUSED | 10 | RD | F1 40 A | adapter | Or the stock battery lead if it already has a 40 A fuse this close
W003 | BT1.2 | J1.2 | GND | stock | stock | - | stock | Battery −
W004 | J1.1 | K1.A | BATT_FUSED | 10 | RD | F1 40 A | box | M6/M8 ring lugs
W005 | J1.2 | TB1.1 | GND | 10 | BK | - | box | Battery − to the ground star
W006 | K1.B | TB2.1 | MOTOR_24V | 10 | RD/YE | F1 40 A (after K1) | box
W007 | TB2.2 | U10.B+ | MOTOR_24V | 10 | RD/YE | F1 40 A (after K1) | box | 470 µF cap on the same terminal
W008 | U10.B- | TB1.2 | GND | 10 | BK | - | box | Run beside the B+ wire
W009 | TB2.3 | U11.B+ | MOTOR_24V | 10 | RD/YE | F1 40 A (after K1) | box | 470 µF cap on the same terminal
W010 | U11.B- | TB1.3 | GND | 10 | BK | - | box | Run beside the B+ wire
W011 | TB2.4 | U12.B+ | MOTOR_24V | 10 | RD/YE | F1 40 A (after K1) | box | 470 µF cap on the same terminal
W012 | U12.B- | TB1.4 | GND | 10 | BK | - | box | Run beside the B+ wire
W013 | TB2.5 | U13.B+ | MOTOR_24V | 10 | RD/YE | F1 40 A (after K1) | box | 470 µF cap on the same terminal
W014 | U13.B- | TB1.5 | GND | 10 | BK | - | box | Run beside the B+ wire
W015 | TB2.6 | U14.B+ | MOTOR_24V | 10 | RD/YE | F1 40 A (after K1) | box | 470 µF cap on the same terminal
W016 | U14.B- | TB1.6 | GND | 10 | BK | - | box | Run beside the B+ wire
W017 | K1.A | F2.1 | BATT_FUSED | 12 | RD | F1 40 A | box | The holder's own short 12 AWG lead, ring lug on K1 stud A
W018 | F2.2 | J2.1 | KEY_FEED | 14 | OG | F2 15 A | box
W019 | J2.1 | SW1.1 | KEY_FEED | stock | stock | F2 15 A | stock | Key switch
W020 | SW1.2 | J2.2 | KEY_24V | stock | stock | F2 15 A | stock
W021 | J2.2 | F3.1 | KEY_24V | 14 | OG | F2 15 A | box | Fuse block bus input; the bus feeds F3-F8
W022 | F3.2 | J9.1 | COIL_FEED | 20 | OG | F3 1 A | box
W023 | J9.1 | S2.11 | COIL_FEED | 20 | OG | F3 1 A | harness | E-stop cable, 4-core
W024 | S2.12 | S2.21 | ESTOP_MID | 20 | OG | F3 1 A | harness | Jumper inside the E-stop: NC1 and NC2 in series
W025 | S2.22 | J9.2 | COIL_24V | 20 | OG | F3 1 A | harness
W026 | J9.2 | K1.C+ | COIL_24V | 20 | OG | F3 1 A | box | D1 soldered across the coil tabs
W027 | K1.C- | Q1.D | COIL_LOW | 20 | OG | F3 1 A | box | To A1
W028 | S2.33 | J9.3 | ESTOP_SENSE | 20 | WH | - | harness
W029 | S2.34 | J9.4 | GND | 20 | BK | - | harness
W030 | J9.3 | U24.P3 | ESTOP_SENSE | 20 | WH | - | box
W031 | J9.4 | A1:GND | GND | 20 | BK | - | box
W032 | U20.L12 | R1.1 | CONTACTOR_HOLD | 22 | YE | - | box | Twist with a GND wire
W033 | F4.2 | U1.IN+ | U1_IN | 20 | OG | F4 2 A | box
W034 | F5.2 | U3.IN+ | U3_IN | 20 | OG | F5 3 A | box
W035 | F6.2 | U4.IN+ | U4_IN | 16 | OG | F6 10 A | box
W036 | F7.2 | FAN1.1 | FAN_24V | 20 | OG | F7 1 A | box
W037 | FAN1.1 | FAN2.1 | FAN_24V | 20 | OG | F7 1 A | box
W038 | FAN1.2 | U29.OUT2 | FAN_LOW | 20 | BK/WH | F7 1 A | box
W039 | FAN2.2 | U29.OUT2 | FAN_LOW | 20 | BK/WH | F7 1 A | box
W040 | F8.2 | R3.1 | BATT_DIV | 22 | OG | F8 1 A | box | To A1
W041 | U1.IN- | TB1.7 | GND | 20 | BK | - | box | IN− and OUT− are joined inside the module
W042 | U3.IN- | TB1.8 | GND | 20 | BK | - | box
W043 | U4.IN- | TB1.9 | GND | 16 | BK | - | box
W044 | A1:GND | TB1.10 | GND | 18 | BK | - | box | A1 ground bus: the only logic-ground wire to the star
W045 | U29.PGND | TB1.11 | GND | 20 | BK | - | box
W046 | U32.VIN- | TB1.12 | GND | 16 | BK | - | box
W047 | U1.OUT+ | A1:5V | 5V_LOGIC | 20 | RD | F4 2 A (24 V side) | box
W048 | A1:5V | U20.L15 | 5V_LOGIC | 22 | RD | F4 2 A (24 V side) | box | ESP32 VIN: 5 V, never 3.3 V
W049 | A1:5V | U21.5V | 5V_LOGIC | 22 | RD | F4 2 A (24 V side) | box
W050 | A1:5V | U2.VIN | 5V_LOGIC | 22 | RD | F4 2 A (24 V side) | box
W051 | A1:5V | J10.1 | 5V_LOGIC | 20 | RD | F4 2 A (24 V side) | box | Hall sensor supply
W052 | U2.VOUT | A1:3V3 | 3V3_SENSE | 22 | VT | U2 current limit | box
W053 | U2.GND | A1:GND | GND | 22 | BK | - | box
W054 | U20.L14 | A1:GND | GND | 22 | BK | - | box | R14 GND is joined on the board
W055 | U21.GND | A1:GND | GND | 22 | BK | - | box
W056 | U3.OUT+ | U30.1 | 5V_ACC | 20 | RD | U3 current limit, F5 | box | DFPlayer VCC
W057 | U30.7 | A1:GND | GND | 22 | BK | - | box
W058 | U4.OUT+ | F9.1 | 12V_ACC | 14 | OG | F6 10 A (24 V side) | box
W059 | F9.1 | F10.1 | 12V_ACC | 14 | OG | F6 10 A (24 V side) | box | Second inline holder on the same 12 V lead
W060 | F10.2 | U32.VIN+ | AMP_12V | 16 | OG | F10 10 A | box
W061 | F9.2 | J8.1 | LIGHTS_12V | 20 | OG | F9 3 A | box | Lights supply
W062 | U29.OUT1 | J8.2 | LIGHTS_SW | 20 | BK/WH | F9 3 A | box | Lights low side
W063 | U20.L8 | U10.1 | FL_RPWM | 22 | BU | - | box | Control cable: twist PWM and EN with GND
W064 | U20.L9 | U10.2 | FL_LPWM | 22 | BU | - | box
W065 | U20.R5 | U10.3 | DRIVE_EN | 22 | YE | - | box | DRIVE_EN daisy chain, ESP32 → FL → FR → RL → RR
W066 | U20.L10 | U11.1 | FR_RPWM | 22 | BU | - | box | Control cable: twist PWM and EN with GND
W067 | U20.L11 | U11.2 | FR_LPWM | 22 | BU | - | box
W068 | U10.3 | U11.3 | DRIVE_EN | 22 | YE | - | box | DRIVE_EN daisy chain, ESP32 → FL → FR → RL → RR
W069 | U20.L6 | U12.1 | RL_RPWM | 22 | BU | - | box | Control cable: twist PWM and EN with GND
W070 | U20.L7 | U12.2 | RL_LPWM | 22 | BU | - | box
W071 | U11.3 | U12.3 | DRIVE_EN | 22 | YE | - | box | DRIVE_EN daisy chain, ESP32 → FL → FR → RL → RR
W072 | U20.L13 | U13.1 | RR_RPWM | 22 | BU | - | box | Control cable: twist PWM and EN with GND
W073 | U20.R11 | U13.2 | RR_LPWM | 22 | BU | - | box
W074 | U12.3 | U13.3 | DRIVE_EN | 22 | YE | - | box | DRIVE_EN daisy chain, ESP32 → FL → FR → RL → RR
W075 | U10.3 | U10.4 | DRIVE_EN | 22 | YE | - | box | Jumper in the plug: R_EN = L_EN; the 10k pull-down sits in the plug too
W076 | U10.5 | U10.6 | IS_FL_RAW | 22 | BN | - | box | Jumper in the plug: R_IS = L_IS
W077 | U10.5 | R101.1 | IS_FL_RAW | 22 | BN | - | box | IS to A1
W078 | A1:3V3 | U10.7 | 3V3_SENSE | 22 | VT | U2 current limit | box | Logic VCC
W079 | A1:GND | U10.8 | GND | 22 | BK | - | box | Signal reference; B− is the power ground
W080 | U10.M+ | F11.1 | FL_DRV_POS | 12 | RD | F1 40 A + driver current limit | box | Motor + to its inline fuse
W081 | F11.2 | J6.1 | FL_M_POS | 12 | RD | F11-F14 15 A (one per motor) | box
W082 | U10.M- | J6.2 | FL_M_NEG | 12 | BK | F1 40 A + driver current limit | box
W083 | U11.3 | U11.4 | DRIVE_EN | 22 | YE | - | box | Jumper in the plug: R_EN = L_EN; the 10k pull-down sits in the plug too
W084 | U11.5 | U11.6 | IS_FR_RAW | 22 | BN | - | box | Jumper in the plug: R_IS = L_IS
W085 | U11.5 | R102.1 | IS_FR_RAW | 22 | BN | - | box | IS to A1
W086 | A1:3V3 | U11.7 | 3V3_SENSE | 22 | VT | U2 current limit | box | Logic VCC
W087 | A1:GND | U11.8 | GND | 22 | BK | - | box | Signal reference; B− is the power ground
W088 | U11.M+ | F12.1 | FR_DRV_POS | 12 | RD | F1 40 A + driver current limit | box | Motor + to its inline fuse
W089 | F12.2 | J6.3 | FR_M_POS | 12 | RD | F11-F14 15 A (one per motor) | box
W090 | U11.M- | J6.4 | FR_M_NEG | 12 | BK | F1 40 A + driver current limit | box
W091 | U12.3 | U12.4 | DRIVE_EN | 22 | YE | - | box | Jumper in the plug: R_EN = L_EN; the 10k pull-down sits in the plug too
W092 | U12.5 | U12.6 | IS_RL_RAW | 22 | BN | - | box | Jumper in the plug: R_IS = L_IS
W093 | U12.5 | R103.1 | IS_RL_RAW | 22 | BN | - | box | IS to A1
W094 | A1:3V3 | U12.7 | 3V3_SENSE | 22 | VT | U2 current limit | box | Logic VCC
W095 | A1:GND | U12.8 | GND | 22 | BK | - | box | Signal reference; B− is the power ground
W096 | U12.M+ | F13.1 | RL_DRV_POS | 12 | RD | F1 40 A + driver current limit | box | Motor + to its inline fuse
W097 | F13.2 | J7.1 | RL_M_POS | 12 | RD | F11-F14 15 A (one per motor) | box
W098 | U12.M- | J7.2 | RL_M_NEG | 12 | BK | F1 40 A + driver current limit | box
W099 | U13.3 | U13.4 | DRIVE_EN | 22 | YE | - | box | Jumper in the plug: R_EN = L_EN; the 10k pull-down sits in the plug too
W100 | U13.5 | U13.6 | IS_RR_RAW | 22 | BN | - | box | Jumper in the plug: R_IS = L_IS
W101 | U13.5 | R104.1 | IS_RR_RAW | 22 | BN | - | box | IS to A1
W102 | A1:3V3 | U13.7 | 3V3_SENSE | 22 | VT | U2 current limit | box | Logic VCC
W103 | A1:GND | U13.8 | GND | 22 | BK | - | box | Signal reference; B− is the power ground
W104 | U13.M+ | F14.1 | RR_DRV_POS | 12 | RD | F1 40 A + driver current limit | box | Motor + to its inline fuse
W105 | F14.2 | J7.3 | RR_M_POS | 12 | RD | F11-F14 15 A (one per motor) | box
W106 | U13.M- | J7.4 | RR_M_NEG | 12 | BK | F1 40 A + driver current limit | box
W107 | U20.R7 | U14.1 | STEER_RPWM | 22 | BU | - | box | Control cable: twist PWM and EN with GND
W108 | U20.R6 | U14.2 | STEER_LPWM | 22 | BU | - | box
W109 | U20.R12 | U14.3 | STEER_EN | 22 | YE | - | box | STEER_EN
W110 | U14.3 | U14.4 | STEER_EN | 22 | YE | - | box | Jumper in the plug: R_EN = L_EN; the 10k pull-down sits in the plug too
W111 | U14.5 | U14.6 | IS_ST_RAW | 22 | BN | - | box | Jumper in the plug: R_IS = L_IS
W112 | U14.5 | R105.1 | IS_ST_RAW | 22 | BN | - | box | IS to A1
W113 | A1:3V3 | U14.7 | 3V3_SENSE | 22 | VT | U2 current limit | box | Logic VCC
W114 | A1:GND | U14.8 | GND | 22 | BK | - | box | Signal reference; B− is the power ground
W115 | U14.M+ | J5.1 | STEER_M_POS | 12 | RD | F1 40 A | box
W116 | U14.M- | J5.2 | STEER_M_NEG | 12 | BK | F1 40 A + driver current limit | box
W117 | J6.1 | M1.1 | FL_M_POS | stock | stock | F11-F14 15 A (one per motor) | stock | Stock motor wiring (or the splitter, #33)
W118 | J6.2 | M1.2 | FL_M_NEG | stock | stock | F1 40 A + driver current limit | stock | Stock motor wiring (or the splitter, #33)
W119 | J6.3 | M2.1 | FR_M_POS | stock | stock | F11-F14 15 A (one per motor) | stock | Stock motor wiring (or the splitter, #33)
W120 | J6.4 | M2.2 | FR_M_NEG | stock | stock | F1 40 A + driver current limit | stock | Stock motor wiring (or the splitter, #33)
W121 | J7.1 | M3.1 | RL_M_POS | stock | stock | F11-F14 15 A (one per motor) | stock | Stock motor wiring (or the splitter, #33)
W122 | J7.2 | M3.2 | RL_M_NEG | stock | stock | F1 40 A + driver current limit | stock | Stock motor wiring (or the splitter, #33)
W123 | J7.3 | M4.1 | RR_M_POS | stock | stock | F11-F14 15 A (one per motor) | stock | Stock motor wiring (or the splitter, #33)
W124 | J7.4 | M4.2 | RR_M_NEG | stock | stock | F1 40 A + driver current limit | stock | Stock motor wiring (or the splitter, #33)
W125 | J5.1 | M5.1 | STEER_M_POS | stock | stock | F1 40 A | stock | Stock motor wiring (or the splitter, #33)
W126 | J5.2 | M5.2 | STEER_M_NEG | stock | stock | F1 40 A + driver current limit | stock | Stock motor wiring (or the splitter, #33)
W127 | U20.L2 | R20.2 | PEDAL | 22 | BN | - | box | PEDAL to A1
W128 | U20.L3 | R3.2 | BATTERY_SENSE | 22 | BN | - | box | BATTERY_SENSE to A1
W129 | U20.L4 | R23.2 | WHEEL_SPEED_L | 22 | WH | - | box | WHEEL_SPEED_L to A1
W130 | U20.L5 | R24.2 | WHEEL_SPEED_R | 22 | WH | - | box | WHEEL_SPEED_R to A1
W131 | U20.R13 | R27.2 | ONEWIRE_TEMP | 22 | WH | - | box | ONEWIRE_TEMP to A1
W132 | U20.R8 | R28.1 | SOUND_TX | 22 | WH | - | box | SOUND_TX to A1
W133 | R28.2 | U30.2 | DF_RX | 22 | WH | - | box | DF_RX
W134 | U20.R3 | R29.1 | LOG_TX | 22 | WH | - | box | LOG_TX (TX0) to A1
W135 | R29.2 | U33.RXD | BT_RXD | 22 | WH | - | box | BT_RXD. U33 TXD stays unconnected: listen-only
W136 | A1:5V | U33.VCC | 5V_LOGIC | 22 | RD | F4 2 A (24 V side) | box | Bluetooth module VCC
W137 | U33.GND | A1:GND | GND | 22 | BK | - | box
W138 | U20.R10 | U21.TX | CRSF_RX | 22 | WH | - | box | CRSF: receiver TX → ESP32 RX
W139 | U20.R9 | U21.RX | CRSF_TX | 22 | WH | - | box | CRSF: ESP32 TX → receiver RX
W140 | R1.2 | Q1.G | Q1_GATE | 22 | WH | - | box | On A1 (listed because Q1 is a TO-220 on flying leads if not on the board)
W141 | R101.2 | U22.A0 | IS_FL | 22 | BN | - | box
W142 | R102.2 | U22.A1 | IS_FR | 22 | BN | - | box
W143 | R103.2 | U22.A2 | IS_RL | 22 | BN | - | box
W144 | R104.2 | U22.A3 | IS_RR | 22 | BN | - | box
W145 | R105.2 | U23.A0 | IS_ST | 22 | BN | - | box
W146 | R5.2 | R6.1 | BUS_SENSE | 22 | BN | - | box | BUS_SENSE from the R5 lead at TB2 to A1
W147 | R6.1 | U23.A2 | BUS_SENSE | 22 | BN | - | box
W148 | R7.2 | A1:GND | GND | 20 | BK | - | box | Bleed return
W149 | A1:3V3 | R22.1 | 3V3_SENSE | 22 | VT | U2 current limit | box | On A1
W150 | R22.2 | J3.1 | PEDAL_VCC | 22 | BN | - | box | Pedal supply
W151 | J3.2 | R20.1 | PEDAL_IN | 22 | BN | - | box | Pedal signal
W152 | J3.3 | A1:GND | GND | 22 | BK | - | box
W153 | J3.1 | PED1.V+ | PEDAL_VCC | stock | stock | - | stock
W154 | J3.2 | PED1.SIG | PEDAL_IN | stock | stock | - | stock
W155 | J3.3 | PED1.GND | GND | stock | stock | - | stock
W156 | U31.DQ | R27.2 | ONEWIRE_TEMP | 22 | WH | - | box | DS18B20 yellow
W157 | U31.VDD | A1:3V3 | 3V3_SENSE | 22 | VT | U2 current limit | box | DS18B20 red
W158 | U31.GND | A1:GND | GND | 22 | BK | - | box | DS18B20 black
W159 | U20.R2 | U22.SCL | I2C_SCL | 22 | GY | - | box | I2C bus start; keep SCL and SDA beside GND
W160 | U20.R1 | U22.SDA | I2C_SDA | 22 | GN | - | box
W161 | A1:3V3 | U22.VDD | 3V3_SENSE | 22 | VT | U2 current limit | box
W162 | A1:GND | U22.GND | GND | 22 | BK | - | box
W163 | U22.SCL | U23.SCL | I2C_SCL | 22 | GY | - | box | I2C chain
W164 | U22.SDA | U23.SDA | I2C_SDA | 22 | GN | - | box | I2C chain
W165 | U22.VDD | U23.VDD | 3V3_SENSE | 22 | VT | U2 current limit | box | I2C chain
W166 | U22.GND | U23.GND | GND | 22 | BK | - | box | I2C chain
W167 | U23.SCL | U24.SCL | I2C_SCL | 22 | GY | - | box | I2C chain
W168 | U23.SDA | U24.SDA | I2C_SDA | 22 | GN | - | box | I2C chain
W169 | U23.VDD | U24.VCC | 3V3_SENSE | 22 | VT | U2 current limit | box | I2C chain
W170 | U23.GND | U24.GND | GND | 22 | BK | - | box | I2C chain
W171 | U24.SCL | U26.SCL | I2C_SCL | 22 | GY | - | box | I2C chain
W172 | U24.SDA | U26.SDA | I2C_SDA | 22 | GN | - | box | I2C chain
W173 | U24.VCC | U26.VCC | 3V3_SENSE | 22 | VT | U2 current limit | box | I2C chain
W174 | U24.GND | U26.GND | GND | 22 | BK | - | box | I2C chain
W175 | U26.SCL | U28.SCL | I2C_SCL | 22 | GY | - | box | I2C chain
W176 | U26.SDA | U28.SDA | I2C_SDA | 22 | GN | - | box | I2C chain
W177 | U26.VCC | U28.VCC | 3V3_SENSE | 22 | VT | U2 current limit | box | I2C chain
W178 | U26.GND | U28.GND | GND | 22 | BK | - | box | I2C chain
W179 | U22.ADDR | U22.GND | GND | 22 | BK | - | box | Address 0x48
W180 | U23.ADDR | U23.VDD | 3V3_SENSE | 22 | VT | U2 current limit | box | Address 0x49
W181 | U26.AD0 | U26.GND | GND | 22 | BK | - | box | Address 0x68
W182 | U28.OE | U28.GND | GND | 22 | BK | - | box | Outputs always enabled
W183 | U28.SCL | J10.6 | I2C_SCL | 20 | GY | - | box | Off-box I2C branch: steering column
W184 | U28.SDA | J10.7 | I2C_SDA | 20 | GN | - | box
W185 | A1:3V3 | J10.5 | 3V3_SENSE | 20 | VT | U2 current limit | box
W186 | A1:GND | J10.2 | GND | 20 | BK | - | box
W187 | U28.SCL | J11.3 | I2C_SCL | 20 | GY | - | box | Off-box I2C branch: dash
W188 | U28.SDA | J11.4 | I2C_SDA | 20 | GN | - | box
W189 | A1:3V3 | J11.1 | 3V3_SENSE | 20 | VT | U2 current limit | box
W190 | A1:GND | J11.2 | GND | 20 | BK | - | box
W191 | U28.PWM0 | U29.IN1 | LIGHTS_PWM | 22 | BU | - | box | Lights PWM
W192 | U28.PWM1 | U29.IN2 | FAN_PWM | 22 | BU | - | box | Fan PWM
W193 | U29.GND | A1:GND | GND | 22 | BK | - | box
W194 | J4.1 | U24.P0 | SHIFT_FORWARD | 22 | WH | - | box
W195 | J4.2 | U24.P1 | SHIFT_REVERSE | 22 | WH | - | box
W196 | J4.3 | A1:GND | GND | 22 | BK | - | box
W197 | J4.1 | SW2.1 | SHIFT_FORWARD | stock | stock | - | stock
W198 | SW2.2 | J4.3 | GND | stock | stock | - | stock
W199 | J4.2 | SW3.1 | SHIFT_REVERSE | stock | stock | - | stock
W200 | SW3.2 | J4.3 | GND | stock | stock | - | stock
W201 | J8.3 | U24.P2 | HORN | 22 | WH | - | box | Horn button
W202 | J8.4 | A1:GND | GND | 22 | BK | - | box
W203 | J8.3 | SW4.1 | HORN | stock | stock | - | stock
W204 | SW4.2 | J8.4 | GND | stock | stock | - | stock
W205 | J8.1 | LP1.1 | LIGHTS_12V | stock | stock | F9 3 A | stock | Lights (voltage TBD)
W206 | LP1.2 | J8.2 | LIGHTS_SW | stock | stock | F9 3 A | stock
W207 | J10.8 | U24.P4 | SEAT | 20 | WH | - | box | Seat switch
W208 | J10.3 | R23.2 | WHEEL_SPEED_L | 20 | WH | - | box | WHEEL_SPEED_L to A1
W209 | J10.4 | R24.2 | WHEEL_SPEED_R | 20 | WH | - | box | WHEEL_SPEED_R to A1
W210 | J10.1 | H1.1 | 5V_LOGIC | 20 | RD | F4 2 A (24 V side) | harness | Split to both wheels
W211 | J10.1 | H2.1 | 5V_LOGIC | 20 | RD | F4 2 A (24 V side) | harness
W212 | J10.2 | H1.2 | GND | 20 | BK | - | harness
W213 | J10.2 | H2.2 | GND | 20 | BK | - | harness
W214 | J10.3 | H1.3 | WHEEL_SPEED_L | 20 | WH | - | harness
W215 | J10.4 | H2.3 | WHEEL_SPEED_R | 20 | WH | - | harness
W216 | J10.5 | U25.VCC | 3V3_SENSE | 20 | VT | U2 current limit | harness | AS5600: ≤ 30 cm of I2C, twisted with GND
W217 | J10.2 | U25.GND | GND | 20 | BK | - | harness
W218 | J10.6 | U25.SCL | I2C_SCL | 20 | GY | - | harness
W219 | J10.7 | U25.SDA | I2C_SDA | 20 | GN | - | harness
W220 | U25.DIR | U25.GND | GND | 20 | BK | - | harness | Jumper on the sensor board
W221 | J10.8 | SW5.1 | SEAT | 20 | WH | - | harness
W222 | SW5.2 | J10.2 | GND | 20 | BK | - | harness
W223 | J11.1 | U27.VCC | 3V3_SENSE | 20 | VT | U2 current limit | harness
W224 | J11.2 | U27.GND | GND | 20 | BK | - | harness
W225 | J11.3 | U27.SCL | I2C_SCL | 20 | GY | - | harness
W226 | J11.4 | U27.SDA | I2C_SDA | 20 | GN | - | harness
W227 | U30.6 | J11.5 | SPK_ALERT_P | 18 | RD | amp output | box
W228 | U30.8 | J11.6 | SPK_ALERT_N | 18 | BK | amp output | box
W229 | J11.5 | LS1.1 | SPK_ALERT_P | 18 | RD | amp output | harness
W230 | J11.6 | LS1.2 | SPK_ALERT_N | 18 | BK | amp output | harness
W231 | U32.L+ | J12.1 | SPK_L_P | 18 | RD | amp output | box
W232 | U32.L- | J12.2 | SPK_L_N | 18 | BK | amp output | box
W233 | U32.R+ | J12.3 | SPK_R_P | 18 | RD | amp output | box
W234 | U32.R- | J12.4 | SPK_R_N | 18 | BK | amp output | box
W235 | J12.1 | LS2.1 | SPK_L_P | 18 | RD | amp output | harness
W236 | J12.2 | LS2.2 | SPK_L_N | 18 | BK | amp output | harness
W237 | J12.3 | LS3.1 | SPK_R_P | 18 | RD | amp output | harness
W238 | J12.4 | LS3.2 | SPK_R_N | 18 | BK | amp output | harness
