ShaiMiz/RideOnESP32/docs/hardware/schematic/01-overview.png

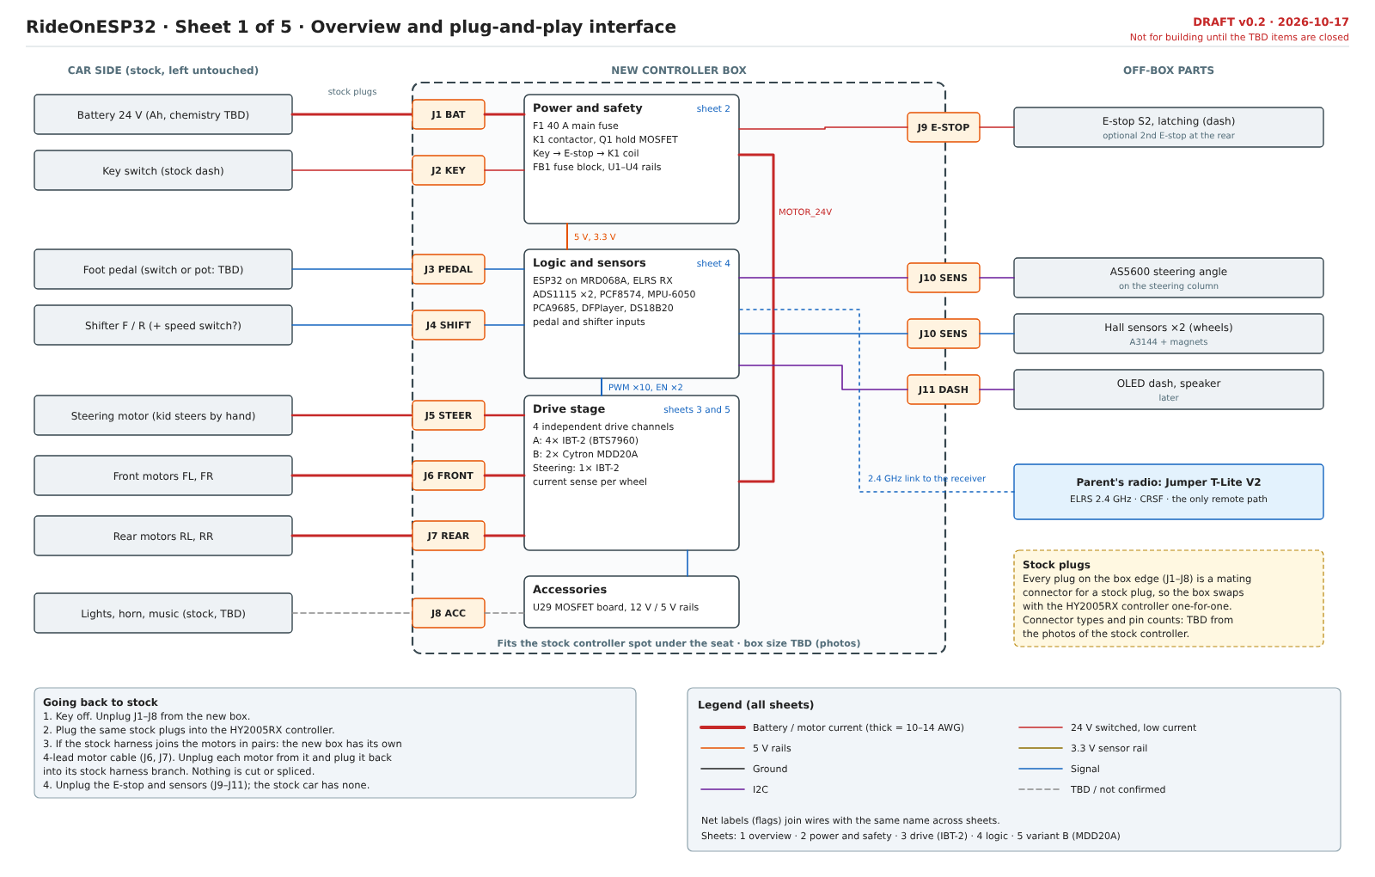
docs/hardware/schematic/01-overview.png
