ShaiMiz/RideOnESP32/docs/hardware/schematic/02-power-safety.png

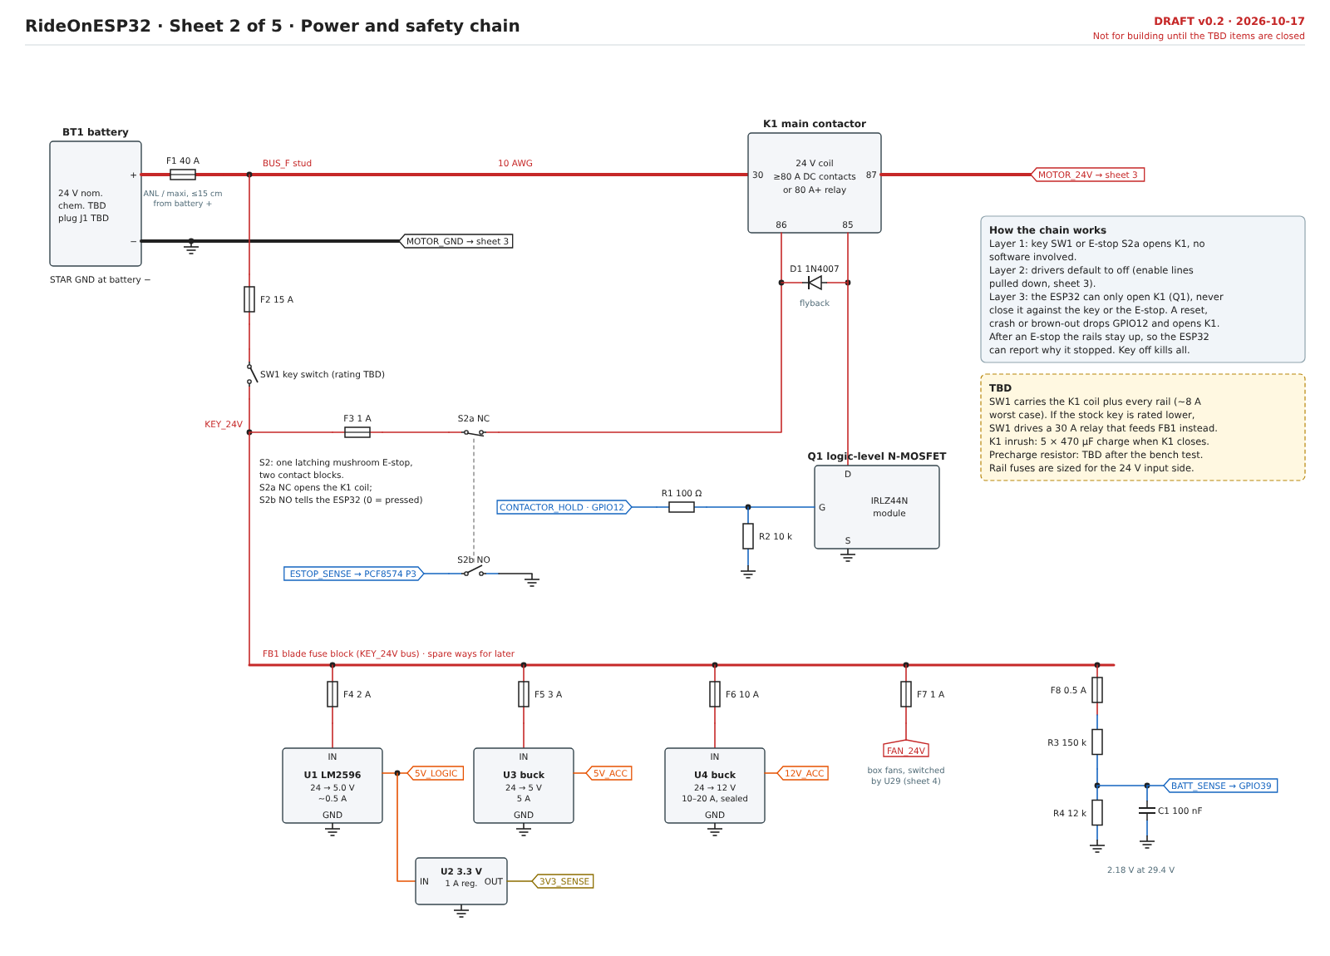
docs/hardware/schematic/02-power-safety.png
