ShaiMiz/RideOnESP32/docs/hardware/schematic/04-logic-sensors.png

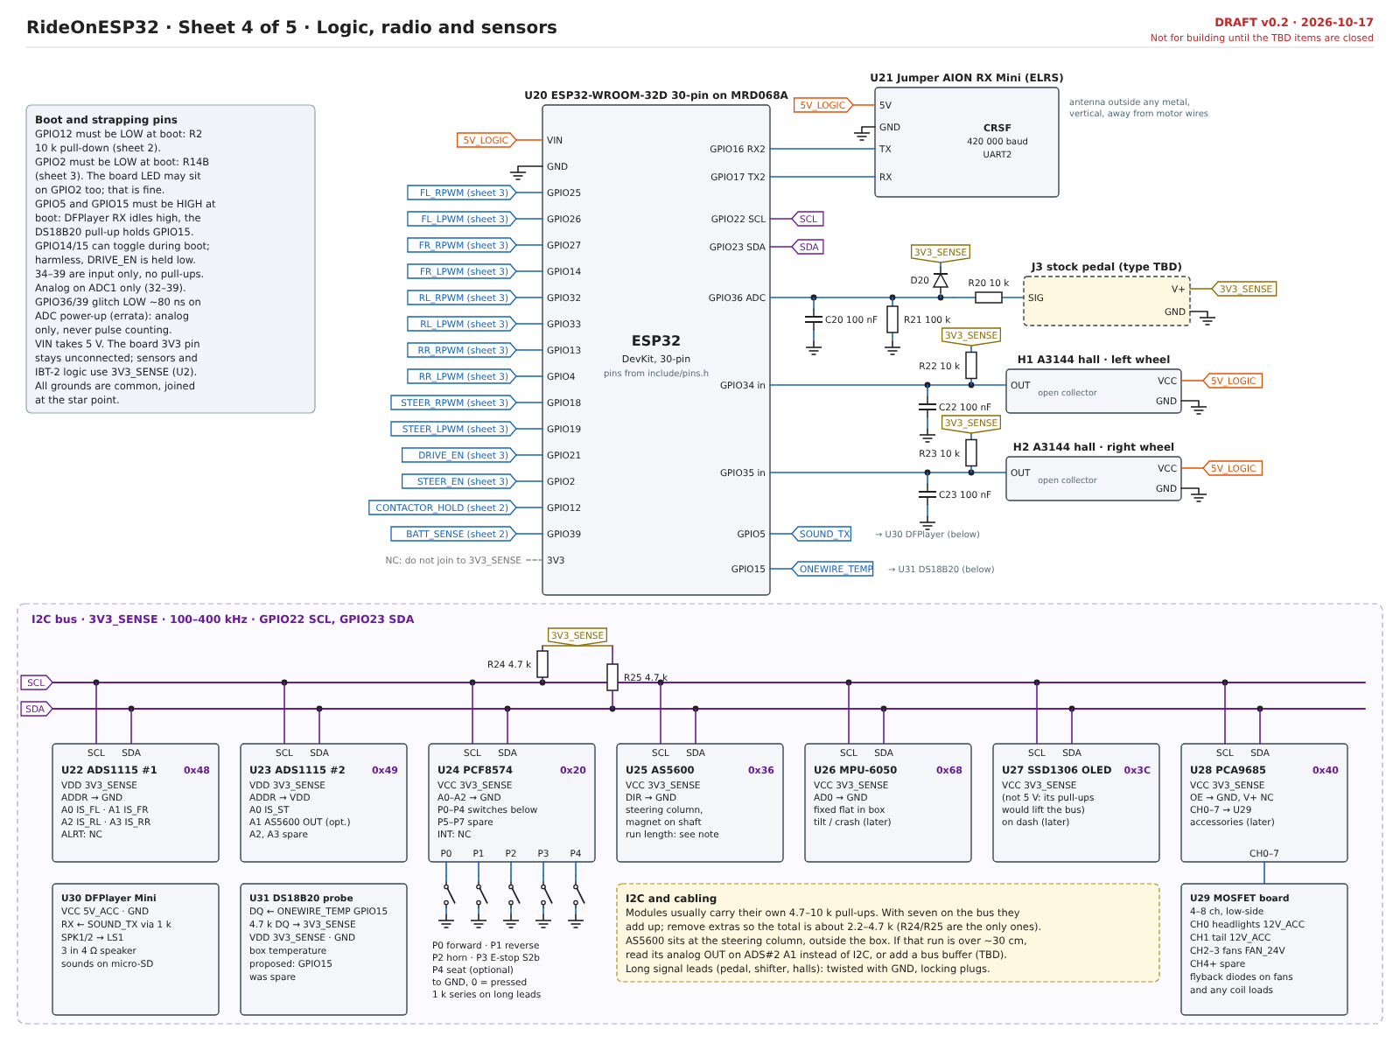
docs/hardware/schematic/04-logic-sensors.png
