ShaiMiz/RideOnESP32/docs/hardware/schematic/05-drive-mdd20a.png

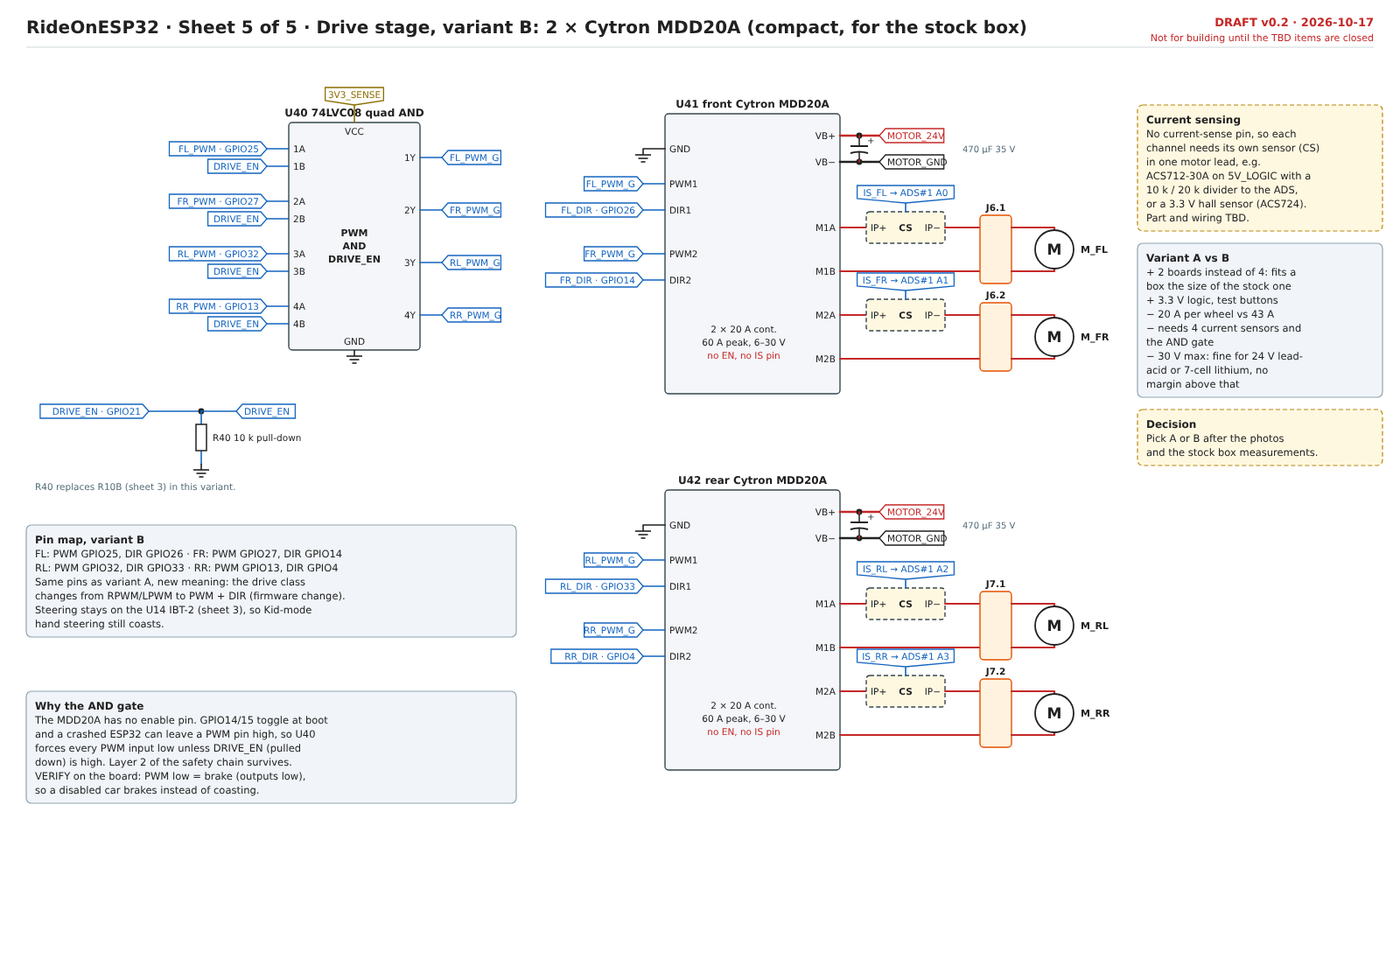
docs/hardware/schematic/05-drive-mdd20a.png
