ShaiMiz/RideOnESP32/docs/hardware/kicad/BOM.md

<!-- Generated by gen/generate.py from gen/design.py and gen/wiring.py. Edit those, not this file. -->

# Bill of materials

| | |
|---|---|
| Project | RideOnESP32 v3, Can-Am Maverick X3 24 V 4WD ride-on |
| Revision | Schematic v0.3, drive variant A (4 + 1 IBT-2); BOM of 25 Oct 2026 |
| Source | Generated from the schematic (gen/design.py) plus the extras and tools in gen/tables.py |
| Lines | 120: Owned 18, Received 4 Nov 37, To buy 47, TBD 10, Stock car 8 |
| Spent | 1,081.76 ILS (24 Oct AliExpress order). Still to buy: not priced yet |

This is the one list for the project: every part of the car, and every tool and material to build it. Parts that are the same share one line, with all their refs. To add something, add it in gen/tables.py (EXTRAS, TOOLS, BUY_LINKS) or as a schematic part, then regenerate. BOM.csv has the same lines with every column, for sorting and filtering in a spreadsheet.

**Status:** *Owned* = in hand. *Received 4 Nov* = from the AliExpress order of 24 Oct, in hand since 4 Nov (order lines O1-O26 below). *To buy* = not ordered yet. *TBD* = waits on a decision or the car photos. *Stock car* = the car's own part, kept. A line with mixed status gives the count of each.

**Manufacturer / part number:** for generic modules this names the chip and its maker; the board is a clone. For tools it is the value pick; the premium pick is in Notes.

**Links:** *value* / *premium* (and similar labels) are direct AliExpress listings Shai picked on 10 Nov 2026 (11.11 sale prices; check the variant and price before buying). *search* links are AliExpress searches sorted by most orders; pick a top result that matches the spec.

## Check the 24 Oct order (arrived 4 Nov)

- **470 µF capacitors (C111-C115): checked 9 Nov.** The bag reads 50 V 470 µF low-ESR, 10 pcs, so they fit the 24 V bus (the receipt's "10-25 V" was the listing name).
- **ADS1115:** two modules (U22, U23), confirmed by Shai 10 Nov.
- **Inline fuse holders (O19):** 3 holders for 12 AWG arrived (the label says "for 12V"; ATO/ATC blades are rated 32 V DC, so they are fine on the 24 V system). They go to F2, F9 and F10.
- **Small parts, counted 9 Nov:** 1 A blades 10, 100 nF and 10 nF 50 V ceramics 100 each, 1N4007 100, 1N4148 50, IRLZ44N 10, AMS1117-3.3 modules 5, 4.7k and 10k 1 % resistors 100 each. Plenty of spares for every line below.
- **Blade fuse values: checked 9 Nov.** The design uses 1, 2, 3, 10 and 15 A (F2-F10). All five bags are in hand, 10 of each (10 A seen 6 Nov).
- **ANL (F1): checked 9 Nov.** One bolt-on ANL holder with a 40 A fuse, plus 2 spare 40 A ANL fuses. That is the whole F1 line.
- **Also seen 9 Nov:** 10 AWG silicone wire (200 °C), 5 m red + 5 m black; the 60-value 1/4 W 1 % resistor kit (5 each, 300 pcs); the clamp meter parcel.
- **K1 coil current:** measure it on the bench supply; over 0.6 A, F3 becomes 2 A.

## Parts, tools and materials

| # | Category | Refs | Qty | Description | Manufacturer / part number | Where | Status | Order line | Link | Notes |
|---|---|---|---|---|---|---|---|---|---|---|
| 1 | Module | U1 | 1 | LM2596 buck module set to 5.0 V (set it before connecting the ESP32) | TI LM2596 (generic module) | box | Owned | - | - | ESP32 VIN, receiver, halls, U2. About 0.5 A |
| 2 | Module | U10 U11 U12 U13 U14 | 5 | IBT-2 (BTS7960) board | Infineon BTS7960B (IBT-2 module) | box | Owned 4, To buy 1 | - | [value](https://www.aliexpress.com/item/1999464638.html), [premium](https://www.aliexpress.com/item/1005010395322275.html) | VCC on 3.3 V so 3.3 V PWM reads as a clean HIGH. Never tie R_EN/L_EN to VCC. Spec: IBT-2 board, 43 A (Shai owns 4, 10 Nov: buy 1). The value listing has one option |
| 3 | Module | U20 | 1 | ESP32-WROOM-32D 30-pin DevKit, USB-C, on MRD068A | Espressif ESP32-WROOM-32D (DevKit V1 clone) | box | Owned | - | - | Pins from include/pins.h. 3V3 pin unused: sensors run from U2 |
| 4 | Module | U21 | 1 | Jumper AION RX Mini ELRS receiver | Jumper AION RX Mini | box (antenna out of the box, away from motor wires) | Owned | - | - | CRSF 420000 baud |
| 5 | Module | U26 | 1 | GY-521 MPU-6050 | TDK InvenSense MPU-6050 (GY-521) | box | Owned | - | - | Tilt and crash (later) |
| 6 | Module | U27 | 1 | 0.91 in SSD1306 OLED | Solomon Systech SSD1306 (generic module) | dash | Owned | - | - | On 3.3 V so its pull-ups can't lift the bus to 5 V |
| 7 | Module | U2 | 1 | AMS1117-3.3 module | AMS AMS1117-3.3 (generic module) | box | Received 4 Nov | O22 | - | 3V3_SENSE: IBT-2 logic, I2C devices, clamps, pedal. About 0.1 A |
| 8 | Module | U22 U23 | 2 | ADS1115 module | TI ADS1115 (generic module) | box | Received 4 Nov | O15 | - | U22: Drive current sense; U23: Steering current sense (A0), motor bus (A2); A1 reserved for AS5600 OUT, A3 spare |
| 9 | Module | U24 | 1 | PCF8574 module, A2-A0 jumpers all to GND | TI PCF8574 (generic module) | box | Received 4 Nov | O17 | - | Switches pull to GND: 0 = pressed |
| 10 | Module | U25 | 1 | AS5600 module + diametric magnet | ams OSRAM AS5600 (generic module) | car | Received 4 Nov | O11 | - | Over ~30 cm of cable: use OUT on ADS#2 A1, or a bus buffer (TBD #11 in v0.2) |
| 11 | Module | U3 | 1 | 24 to 5 V 5 A buck module | Generic | box | To buy | - | - | Accessories only: DFPlayer, USB, LED strips |
| 12 | Module | U4 | 1 | 24 to 12 V 10-20 A sealed buck | Generic | box | To buy | - | - | Lights and music amp |
| 13 | Module | U28 | 1 | PCA9685 16-channel PWM board | NXP PCA9685 (generic module) | box | To buy | - | [search](https://www.aliexpress.com/w/wholesale-pca9685-16-channel.html?SortType=total_tranpro_desc) | Accessory PWM; PWM2-15 spare. Spec: Blue Adafruit-layout board, address 0x40 |
| 14 | Module | U29 | 1 | 4-channel low-side MOSFET board, logic-level | Generic, LR7843 or AOD4184 MOSFETs | box | To buy | - | [search](https://www.aliexpress.com/w/wholesale-4-channel-mosfet-module-lr7843.html?SortType=total_tranpro_desc) | Spec: Logic-level (switches from 3.3 V): LR7843 or AOD4184 boards, not IRF520 |
| 15 | Module | U30 | 1 | DFPlayer Mini + micro-SD card | DFRobot DFPlayer Mini DFR0299 (or clone) | box | To buy | - | - |  |
| 16 | Module | U31 | 1 | DS18B20 waterproof probe | Analog Devices (Maxim) DS18B20 | box | To buy | - | [value](https://www.aliexpress.com/item/1005006090368473.html), [premium](https://www.aliexpress.com/item/1005005488542048.html) | Spec: Stainless probe, 1 m cable, 3 wires |
| 17 | Module | U32 | 1 | ZK-502T Bluetooth amp | ZK-502T (generic) | box or dash | To buy | - | - | Cap the volume (EN 71-1 loudness, see the safety review) |
| 18 | Module | U33 | 1 | HM-10 BLE serial module (iPhone and Android) | DSD TECH HM-10 (TI CC2541), or a CC2541 clone | box | To buy | - | [pick](https://www.aliexpress.com/item/1005005104904918.html) | Listen-only log to a phone: hears TX0 (the USB serial log). TXD stays unconnected, so nothing can reach the ESP32. Set to 115200 with the bt_setup bench firmware first. Spec: HM-10 BLE 4.0 (CC2541) on a 6-pin breakout with a 3.3 V regulator, 3.6-6 V in. BLE works with iPhone and Android. DSD TECH is the genuine one; clones (MLT-BT05, CC41-A) also work with bt_setup. The 10 Nov pick ships clone firmware |
| 19 | Sensor | H1 H2 | 2 | A3144 hall switch + magnet | Allegro A3144 (or clone) | car | To buy | - | [A3144 x10](https://www.aliexpress.com/item/1005009945016406.html), [magnets x10](https://www.aliexpress.com/item/1005010377772528.html) | Spec: Buy 10 A3144 + 10 neodymium magnets 10 x 5 mm |
| 20 | Sensor | SW5 | 1 | Seat switch, closes with a child seated (optional) | Generic | car | To buy | - | - |  |
| 21 | Power | F1 | 1 | ANL fuse holder + 40 A ANL fuse | Generic ANL | car | Received 4 Nov | O16 | - | Unfused wire before F1 must stay under 15 cm. If the stock harness already has a 40 A fuse this close, that fuse is F1 |
| 22 | Power | F2 | 1 | Inline blade fuse holder (12 AWG) + 15 A blade | Generic ATO/ATC blade | box | Received 4 Nov | O19, O25 | - | Feeds the key; protects the key wiring |
| 23 | Power | F3 F7 F8 | 3 | Blade fuse 1 A in the fuse block | Generic ATO/ATC blade | box | Received 4 Nov | O25 | - | F3: K1 coil chain; F7: Box fans; F8: Battery divider wire (0.5 A in v0.2; 1 A is in the order) |
| 24 | Power | F4 | 1 | Blade fuse 2 A in the fuse block | Generic ATO/ATC blade | box | Received 4 Nov | O25 | - | 5V_LOGIC buck input |
| 25 | Power | F5 | 1 | Blade fuse 3 A in the fuse block | Generic ATO/ATC blade | box | Received 4 Nov | O25 | - | 5V_ACC buck input |
| 26 | Power | F6 | 1 | Blade fuse 10 A in the fuse block | Generic ATO/ATC blade | box | Received 4 Nov | O25 | - | 12V_ACC buck input |
| 27 | Power | F9 | 1 | Inline blade fuse holder (ordered, 3 pcs) + 3 A | Generic ATO/ATC blade | box | Received 4 Nov | O19, O25 | - | Lights branch of the 10-20 A buck |
| 28 | Power | F10 | 1 | Inline blade fuse holder (ordered, 3 pcs) + 10 A | Generic ATO/ATC blade | box | Received 4 Nov | O19, O25 | - | Music amp branch |
| 29 | Power | FB1 | 1 | 6/12-way blade fuse block with common bus (holds F3-F8) | Generic | box | Received 4 Nov | O8 | - |  |
| 30 | Power | K1 | 1 | Taiye TSW-80/24V DC contactor (SW80 type), 125 A, 24 V DC coil | Taiye TSW-80/24V (label checked 6 Nov) | box (may mount beside it: ~10 cm tall) | Received 4 Nov | O5 | - | Measure its coil current on the bench; if over 0.6 A make F3 2 A |
| 31 | Power | S2 | 1 | 22 mm latching E-stop 2NO + 2NC | Generic 22 mm | dash | Received 4 Nov | O12 | - | Both NC blocks in series with the K1 coil (a welded NC block still leaves one that opens). NO3 reads the state |
| 32 | Power | TB1 | 1 | M6 brass stud or bus bar: the one ground star point | Generic | box | To buy | - | [value](https://www.aliexpress.com/item/1005004665757378.html), [premium](https://www.aliexpress.com/item/1005007540174230.html) | Battery −, every driver B−, rails and logic ground meet here and nowhere else. Spec: M6 (or 1/4 in) stud bus bar, 60 A or more. TB1 takes about 12 ring terminals: pick a bar with enough studs or stack rings on two bars. Value link: select the M6 option (the default is M8) |
| 33 | Power | TB2 | 1 | M6 stud or bus bar after K1 stud B | Generic | box | To buy | - | [value](https://www.aliexpress.com/item/1005004665757378.html), [premium](https://www.aliexpress.com/item/1005007540174230.html) | Spec: M6 (or 1/4 in) stud bus bar, 60 A or more. Value link: select the M6 option (the default is M8) |
| 34 | Discrete | D1 | 1 | 1N4007, flyback across the K1 coil | Generic 1N4007 | box | Received 4 Nov | O23 | - | A plain diode slows K1 opening a little; a 1N4007 + 24 V zener in series opens faster (optional) |
| 35 | Discrete | D20 D101 D102 D103 D104 D105 | 6 | 1N4148 small-signal diode | Generic 1N4148 | A1 | Received 4 Nov | O21 | - | D20: pedal clamp to 3.3 V; D101-D105: IS clamp to 3.3 V. Clamps the 4-7 mA fault current so the ADS1115 input stays ≤ 3.6 V |
| 36 | Discrete | Q1 | 1 | IRLZ44N logic-level N-MOSFET, TO-220 | Infineon IRLZ44NPBF | A1 | Received 4 Nov | O20 | - | The ESP32 can open K1 but never close it against the key or E-stop |
| 37 | Discrete | D2 | 1 | Unidirectional TVS across MOTOR_24V, voltage set by the battery (TBD) | TBD (SMBJ/P6KE family) | box | TBD | - | - | not fitted yet. Clamps the regen spike when K1 opens on a rolling car. Fit once the battery voltage is known. Issue #13 |
| 38 | Passive | C1 C2 C20 C21 C22 C201 C202 C203 C204 C205 | 10 | Ceramic capacitor 100n, 50 V | Generic MLCC | A1, car | Received 4 Nov | O24 | - | C201-C204: across the motor terminals. Noise suppression; solder right on the motor tabs; C205: across the motor terminals |
| 39 | Passive | C101 C102 C103 C104 C105 | 5 | Ceramic capacitor 10n, 50 V | Generic MLCC | A1 | Received 4 Nov | O24 | - | IS filter |
| 40 | Passive | C111 C112 C113 C114 C115 | 5 | Electrolytic 470 µF 50 V low-ESR | Generic low-ESR electrolytic | box | Received 4 Nov | O14 | - | 50 V low-ESR, 10 pcs (bag label checked 9 Nov); anything ≥35 V works on the 24 V bus |
| 41 | Passive | R1 R22 | 2 | Resistor 100, metal film 1 %, 0.25 W | Generic metal film | A1 | Received 4 Nov | O13, O26 | - | R1: Gate resistor; R22: Pedal supply; a shorted pedal cable can't pull down 3V3_SENSE |
| 42 | Passive | R2 R20 R23 R24 R111 R112 R113 R114 R115 | 9 | Resistor 10k, metal film 1 %, 0.25 W | Generic metal film | A1, box | Received 4 Nov | O13, O26 | - | R2: Holds K1 open and strapping pin GPIO12 LOW at boot. Never a pull-up; R20: Series protection; R23: GPIO34 has no internal pull-up; R24: GPIO35 has no internal pull-up; R111-R115: Pull-down at each board, so a broken enable wire still leaves that board off |
| 43 | Passive | R3 R5 | 2 | Resistor 150k, metal film 1 %, 0.25 W | Generic metal film | A1, box | Received 4 Nov | O13, O26 | - | R3: 2.2 V at 29.4 V; R5: Motor-bus sense for the K1 checks; at the stud, so only the divided signal runs to A1 |
| 44 | Passive | R4 R6 | 2 | Resistor 12k, metal film 1 %, 0.25 W | Generic metal film | A1 | Received 4 Nov | O13, O26 | - | R6: 2.2 V at 29.4 V, as the battery divider |
| 45 | Passive | R21 | 1 | Resistor 100k, metal film 1 %, 0.25 W | Generic metal film | A1 | Received 4 Nov | O13, O26 | - | Unplugged pedal reads 0 (released) |
| 46 | Passive | R25 R26 R27 R101 R102 R103 R104 R105 | 8 | Resistor 4.7k, metal film 1 %, 0.25 W | Generic metal film | A1 | Received 4 Nov | O13, O26 | - | R25: not fitted yet. Fit only if the module pull-ups in parallel measure above 4.7k. Seven modules with their own 10k/4.7k already give ~1-2k; R26: not fitted yet. As R25; R27: 1-Wire pull-up; also keeps strapping pin GPIO15 HIGH; R101-R105: IS series resistor |
| 47 | Passive | R28 R29 | 2 | Resistor 1k, metal film 1 %, 0.25 W | Generic metal film | A1 | Received 4 Nov | O13, O26 | - | R28: DFPlayer RX series resistor; R29: Bluetooth RXD series resistor: a dead module can't hold down the USB serial line |
| 48 | Passive | R7 | 1 | Resistor 2.2k, 3 W wirewound or metal oxide | Generic wirewound or metal oxide | box | To buy | - | [value](https://www.aliexpress.com/item/1005005674103930.html), [premium](https://www.aliexpress.com/item/1005001659207517.html) | Bleed: drains the driver caps with K1 open (5 s time constant), so the boot weld check can see a welded K1. 0.4 W with K1 closed. Spec: 2.2k, 3 W or more (5 W fine); a local shop has it too. Value: 5 % metal oxide x20, about 6.6 ILS |
| 49 | Connector | J9 J12 | 2 | 4-way Deutsch DT04-4P / DT06-4S (or clone), sealed | TE Deutsch DT04-4P / DT06-4S (or clone) | box edge | To buy | - | [value](https://www.aliexpress.com/item/1005001675198701.html) | J9: Our own plug: E-stop on the dash; J12: Our own plug; music path only, never shared with the ESP32. Spec: Deutsch DT set with pins and seals; confirm the wedge locks come in the set, and the pin type (see the crimping note on the mates line) |
| 50 | Connector | J10 | 1 | Sealed 8-way, Deutsch DT04-08PA / DT06-08SA (or clone) | TE Deutsch DT04-08PA / DT06-08SA (or clone) | box edge | To buy | - | [value](https://www.aliexpress.com/item/1005001675198701.html) | Our own plug: halls, steering angle, seat. Spec: Deutsch DT 8-pin set with pins and seals |
| 51 | Connector | J11 | 1 | Sealed 6-way, Deutsch DT04-6P / DT06-6S (or clone) | TE Deutsch DT04-6P / DT06-6S (or clone) | box edge | To buy | - | [value](https://www.aliexpress.com/item/1005001675198701.html) | Our own plug: OLED and alert speaker. Spec: Deutsch DT 6-pin set with pins and seals |
| 52 | Connector | J1 | 1 | Mate of the stock battery plug (fallback: Anderson SB50) | TBD (#17) | box edge | TBD | - | - | Issue #17 |
| 53 | Connector | J2 | 1 | Mate of the stock key-switch plug | TBD (#17) | box edge | TBD | - | - | Issue #17 |
| 54 | Connector | J3 | 1 | Mate of the stock pedal plug | TBD (#17) | box edge | TBD | - | - | Issue #17 |
| 55 | Connector | J4 | 1 | Mate of the stock shifter plug | TBD (#17) | box edge | TBD | - | - | Issue #17 |
| 56 | Connector | J5 | 1 | Mate of the stock steering-motor plug (fallback: XT60, owned) | TBD (#17) | box edge | TBD | - | - | Issue #17 |
| 57 | Connector | J6 | 1 | Mate of the stock front-motor plug(s); if the harness pairs the motors, a reversible splitter at the motor plugs (fallback: 2 x XT60) | TBD (#17) | box edge | TBD | - | - | Issue #17, #33 |
| 58 | Connector | J7 | 1 | Mate of the stock rear-motor plug(s); splitter as J6 (fallback: 2 x XT60) | TBD (#17) | box edge | TBD | - | - | Issue #17, #33 |
| 59 | Connector | J8 | 1 | Mate of the stock lights/horn plug (pin use TBD from photos) | TBD (#17) | box edge | TBD | - | - | Issue #17 |
| 60 | Cooling | FAN1 FAN2 | 2 | 24 V 80 mm fan + finger guard | Generic 8025 24 V | box wall | To buy | - | [fan](https://www.aliexpress.com/item/1005002971846100.html), [guard](https://www.aliexpress.com/item/1005005467470242.html), [steel guards](https://www.aliexpress.com/item/4000118191927.html), [filter](https://www.aliexpress.com/item/4000991107131.html) | FAN1: intake, with a dust filter; FAN2: exhaust. Spec: 8025, 24 V DC, 2-wire, ball bearing; + 2 finger guards and a dust filter. Pick the 24 V dual-ball variant (about 16.4 ILS each), 80 mm guards and 80 mm filters |
| 61 | Audio | LS1 | 1 | 3 in 4 Ω full-range speaker, car sounds | Generic | dash | To buy | - | - |  |
| 62 | Audio | LS2 LS3 | 2 | 3 in full-range speaker (+ DDT-S30 tweeter via 10 µF film cap, AUDIO.md) | Generic | car | To buy | - | - |  |
| 63 | Wiring | - | 1 | MRD068A screw-terminal adapter for the ESP32 | Generic MRD068A | box | Owned | - | - |  |
| 64 | Wiring | - | 1 | 10 AWG silicone wire (200 °C), 5 m red + 5 m black | Generic | box | Received 4 Nov | O3 | - | Battery, contactor, driver B+/B− |
| 65 | Wiring | - | 1 | 12 AWG wire, red + black, 10 m | Generic | box | Received 4 Nov | O4 | - | Driver to motor plugs |
| 66 | Wiring | - | 1 | Insulated ring terminal kit, red/blue/yellow (yellow 4-6 mm² takes 10 AWG; check the stud sizes) | Generic | box | Received 4 Nov | O10 | - |  |
| 67 | Wiring | - | 1 | Wire ferrule kit, 2000 pcs, 0.5-10 mm² | Generic | box | Received 4 Nov | O9 | - | For the screw terminals (IBT-2, MRD068A, A1) |
| 68 | Wiring | A1 | 1 | Interface board: screw-terminal proto board ~70 x 90 mm + 3.5 mm terminals | Generic | box | To buy | - | [board](https://www.aliexpress.com/item/1005006863899256.html), [board x5](https://www.aliexpress.com/item/1005007977006793.html), [terminals](https://www.aliexpress.com/item/1005003179482974.html) | Holds Q1, the sense networks, pull-ups and the battery divider |
| 69 | Wiring | - | 1 | 14-16 AWG wire, orange or red (key, F6 and 12 V branches) | Generic | box | To buy | - | [value](https://www.aliexpress.com/item/1005008146134465.html), [premium](https://www.aliexpress.com/item/1005010370889360.html) | 12 AWG from the order also works |
| 70 | Wiring | - | 1 | 20 AWG 4-6 core cable for off-box harnesses (E-stop, sensors, dash) | Generic | harness | To buy | - | [value](https://www.aliexpress.com/item/33037204577.html), [premium](https://www.aliexpress.com/item/1005004178571358.html) | Sold per metre: about 6 m covers the E-stop, dash and sensor runs (estimate) |
| 71 | Wiring | - | 1 | 22 AWG silicone wire set, 10 colours (colour code in WIRE_LIST.md) | Generic | box | To buy | - | [value](https://www.aliexpress.com/item/1005001798119195.html), [premium](https://www.aliexpress.com/item/32429405173.html) | Was in the cart review, not in the order |
| 72 | Wiring | - | 5 | 8-way 2.54 mm housing + crimp pins for each IBT-2 control header (or JST-XH adapter) | Generic Dupont | box | To buy | - | [kit + SN-28B](https://www.aliexpress.com/item/1005001863745903.html) | Holds the EN and IS jumpers and the EN pull-down; a dab of hot glue against vibration. The pins need an SN-28B crimper: select "SN-28B AND 310PCS" (about 68.5 ILS); check the kit has 1x8 housings |
| 73 | Wiring | - | 10 | Cable glands PG9 / PG13.5 | Generic nylon | box | To buy | - | [value](https://www.aliexpress.com/item/4001144039060.html), [premium](https://www.aliexpress.com/item/1005006645820587.html) | Select the PG9 and PG13.5 variants (the default is PG7) |
| 74 | Wiring | - | 4 | Deutsch DT mating pairs with seals: 4-way x2 (J9, J12), 6-way (J11), 8-way (J10) | TE Deutsch DT (or clone) | box edge | To buy | - | [value](https://www.aliexpress.com/item/1005001675198701.html), [premium](https://www.aliexpress.com/item/10000319645984.html) | Mates for J9-J12. Stamped pins crimp with an open-barrel jaw; solid pins need a Deutsch indent crimper (HDT-48-00 type), which the HS-30J is not. Check which pins the set has |
| 75 | Wiring | - | 1 | Heat shrink assortment (also the colour bands) | Generic | box | To buy | - | [value](https://www.aliexpress.com/item/1005008146302901.html) | Not in the 24 Oct order: the line thought to be heat shrink was the ferrule kit |
| 76 | Wiring | - | 1 | Nylon M3 standoffs and a mounting plate | Generic | box | To buy | - | [value](https://www.aliexpress.com/item/32862529967.html), [premium](https://www.aliexpress.com/item/1005009130730366.html) | Value link: select "200PCS-M3 Mix" (the default is M2) |
| 77 | Wiring | - | 1 | Pigtail for the AS5600 board's 4-pin plug (match its pitch: JST-GH 1.25 or PH 2.0) | Generic JST | car | To buy | - | [search](https://www.aliexpress.com/w/wholesale-jst-gh-1.25-4-pin-cable.html?SortType=total_tranpro_desc) | Optional: lets the sensor unplug. Or solder the cable to the board's pads, with strain relief |
| 78 | Wiring | - | 1 | Box: flame-retardant (UL94 V-0) ABS or metal, ~250 x 200 x 100 mm, IP54 | TBD | box | TBD | - | - | Size waits on #18; V-0 or metal is item M7 of the safety review (EN 62115 fire test) |
| 79 | Stock car | BT1 | 1 | Stock 24 V battery; voltage, Ah, chemistry TBD | Stock car (Kolbo 8419715) | car | Stock car | - | - | BTS7960 locks out above 27.5 V; check the charger voltage. Issue #13 |
| 80 | Stock car | M1 M2 M3 M4 | 4 | Stock drive motor (label TBD) | Stock car (Kolbo 8419715) | car | Stock car | - | - | Issue #14 |
| 81 | Stock car | M5 | 1 | Stock steering motor (label TBD) | Stock car (Kolbo 8419715) | car | Stock car | - | - | Issue #14 |
| 82 | Stock car | PED1 | 1 | Stock pedal: switch, pot or hall throttle (TBD). Never a line that carries 24 V | Stock car (Kolbo 8419715) | car | Stock car | - | - | Issue #16 |
| 83 | Stock car | SW1 | 1 | Stock dash key switch (rating TBD; if < 10 A, drive a 30 A relay from it) | Stock car (Kolbo 8419715) | dash | Stock car | - | - | Issue #17 |
| 84 | Stock car | SW2 | 1 | Stock shifter, forward contact (must be signal-only) | Stock car (Kolbo 8419715) | car | Stock car | - | - | Issue #17 |
| 85 | Stock car | SW3 | 1 | Stock shifter, reverse contact (must be signal-only) | Stock car (Kolbo 8419715) | car | Stock car | - | - | Issue #17 |
| 86 | Stock car | SW4 | 1 | Stock horn button | Stock car (Kolbo 8419715) | dash | Stock car | - | - | Issue #17 |
| 87 | Spare | - | 1 | 10 AWG red wire, 5 m | Generic | - | Owned | - | - | Adds to the 24 Oct wire |
| 88 | Spare | - | 4 | 555 24 V motors (loose) | Generic | - | Owned | - | - | Spares, if they match the car's motors (#14) |
| 89 | Spare | - | 1 | BMP280 pressure sensor module | Bosch BMP280 (generic module) | - | Owned | - | - | Not used |
| 90 | Spare | - | 2 | DDT-S30 tweeters | Generic | - | Owned | - | - | Music path, each via a 10 µF film cap (AUDIO.md) |
| 91 | Spare | - | 1 | ESP32-WROOM-32D 30-pin DevKit, USB-C (second board) | Espressif ESP32-WROOM-32D (DevKit V1 clone) | - | Owned | - | - | Bench firmwares and a spare |
| 92 | Spare | - | 1 | HC-12 433 MHz radio module | Generic HC-12 | - | Owned | - | - | Not used: the radio link is ELRS only |
| 93 | Spare | - | 1 | HY2005RX-24V/40A stock controller (spare) | HY2005RX | - | Owned | - | - | Plan B: puts the car back to stock |
| 94 | Spare | - | 1 | LM2596 buck module (extra) | TI LM2596 (generic module) | - | Owned | - | - | Spare for U1 |
| 95 | Spare | - | 1 | Ride-on key switch | Generic | - | Owned | - | - | Spare; could replace SW1 if the stock switch is too weak (#17) |
| 96 | Spare | - | 5 | XT60 pairs | Amass XT60 (or clone) | - | Owned | - | - | Fallback plugs for J5-J7 |
| 97 | Tool | - | 1 | ELRS radio transmitter | Jumper T-Lite V2 | bench | Owned | - | - | Parent transmitter |
| 98 | Tool | - | 2 | 18650 protected cell | Vapcell N40 | bench | Received 4 Nov | O7 | - | For the T-Lite radio |
| 99 | Tool | - | 1 | Crimping pliers, ratchet, 4 swap jaws (insulated terminals, ferrules, ...) | Lion Rage HS-30J | bench | Received 4 Nov | O6 | - | Use the jaw marked with mm² ferrule sizes for ferrules, the red/blue/yellow one for insulated terminals |
| 100 | Tool | - | 1 | DC clamp meter | UNI-T UT210E | bench | Received 4 Nov | O2 | - | Motor and coil current without cutting wires |
| 101 | Tool | - | 1 | Programmable bench supply, 30 V 10 A | Wanptek WPS3010H | bench | Received 4 Nov | O1 | - | Phases 3-4 run on its current limit instead of the battery |
| 102 | Tool | - | 3 | USB-TTL adapter set: one each PL2303HX, CP2102, CH340G | Prolific PL2303HX, Silicon Labs CP2102, WCH CH340G (generic modules) | bench | Received 4 Nov | O18 | - | Not needed (the ESP32 has USB); harmless spare |
| 103 | Tool | - | 1 | Automatic wire stripper, 10-24 AWG | Generic self-adjusting stripper | bench | To buy | - | [search](https://www.aliexpress.com/w/wholesale-automatic-wire-stripper.html?SortType=total_tranpro_desc) | Premium: Knipex 12 62 180 (local) |
| 104 | Tool | - | 1 | Brass-wool tip cleaner with holder | Generic brass wool in a metal cup | bench | To buy | - | [search](https://www.aliexpress.com/w/wholesale-brass-wire-tip-cleaner-holder.html?SortType=total_tranpro_desc) | No water needed. Premium: Hakko 599B (genuine sold locally) |
| 105 | Tool | - | 1 | Desoldering pump | Generic aluminium pump | bench | To buy | - | [search](https://www.aliexpress.com/w/wholesale-desoldering-pump-aluminum.html?SortType=total_tranpro_desc) | Premium: Engineer SS-02 |
| 106 | Tool | - | 1 | Heat gun, dual temperature | Generic 2000 W | bench | To buy | - | [search](https://www.aliexpress.com/w/wholesale-heat-gun-2000w.html?SortType=total_tranpro_desc) | For the heat shrink; local hardware stores have them. Premium: Any brand with an adjustable dial |
| 107 | Tool | - | 1 | Helping hands, weighted base, 4 flexible arms | Generic 4-arm with clips | bench | To buy | - | [search](https://www.aliexpress.com/w/wholesale-helping-hands-soldering-4-arms.html?SortType=total_tranpro_desc) | Premium: Same with magnifier and LED |
| 108 | Tool | - | 0 | Hex crimper for 6-50 mm² lugs | Generic hexagon lug crimper | bench | To buy | - | [search](https://www.aliexpress.com/w/wholesale-hex-crimping-tool-6-50mm2.html?SortType=total_tranpro_desc) | Optional: yellow insulated rings (4-6 mm²) from O10 take 10 AWG and crimp with the HS-30J. Needed only for bare tube lugs, or if no yellow ring fits the M6/M8 studs. Premium: Hydraulic crimper (overkill here) |
| 109 | Tool | - | 0 | Self-adjusting ferrule crimper, 0.25-10 mm² (square jaw) | Generic HSC8 6-4A | bench | To buy | - | [search](https://www.aliexpress.com/w/wholesale-hsc8-6-4a-ferrule-crimper.html?SortType=total_tranpro_desc) | Optional: only if none of the HS-30J jaws is a ferrule jaw. Premium: Knipex 97 53 14 |
| 110 | Tool | - | 1 | Silicone soldering mat, about 45 x 30 cm | Generic heat-resistant mat with screw trays | bench | To buy | - | [search](https://www.aliexpress.com/w/wholesale-silicone-soldering-mat.html?SortType=total_tranpro_desc) | Premium: Kaisi silicone mat |
| 111 | Tool | - | 1 | Solder fume extractor | Small desk fan with carbon filter | bench | To buy | - | [search](https://www.aliexpress.com/w/wholesale-solder-fume-extractor.html?SortType=total_tranpro_desc) | Premium: Larger extractor on an arm |
| 112 | Tool | - | 1 | Soldering iron, 60 W or more, 3-5 mm chisel + conical tip | SEQURE S60 or FNIRSI HS-02 (USB-C PD pen iron, ~100 W; needs a 65-100 W PD charger) | bench | To buy | - | [FNIRSI HS-02](https://www.aliexpress.com/item/1005006655028971.html) | Skip if you already have one this strong: 10 AWG and XT60 need the power. The 10 Nov pick's HS-02B-K variant is the iron only: it needs a 65-100 W USB-C PD charger, or take a kit variant with a supply. Premium: AIXUN T3A or SUGON T26D station (JBC C245-compatible tips) |
| 113 | Consumable | - | 2 | Desoldering braid 2.0 and 2.5 mm, 1.5 m | MECHANIC wick | bench | To buy | - | [search](https://www.aliexpress.com/w/wholesale-goot-wick-desoldering-braid.html?SortType=total_tranpro_desc) | Premium: Goot Wick CP-2015 / CP-3015 |
| 114 | Consumable | - | 1 | Flux paste, 10 cc syringe with plunger and needle | MECHANIC UV-223 or RMA-223 | bench | To buy | - | [search](https://www.aliexpress.com/w/wholesale-mechanic-uv-223-flux.html?SortType=total_tranpro_desc) | Flux paste, not solder paste: solder paste is for surface-mount boards and hot air. Premium: Amtech NC-559-V2-TF (often faked on AliExpress) |
| 115 | Consumable | - | 1 | Isopropyl alcohol 99 % + ESD-safe brush | Generic ESD brush; alcohol from a pharmacy | bench | To buy | - | [search](https://www.aliexpress.com/w/wholesale-esd-anti-static-brush.html?SortType=total_tranpro_desc) | Buy the alcohol locally: flammable, ships badly. Premium: Flux-remover spray (local) |
| 116 | Consumable | - | 0 | Lead-free solder wire (instead of 63/37, if kids are near the bench) | Sn99.3/Cu0.7 rosin core | bench | To buy | - | [search](https://www.aliexpress.com/w/wholesale-sac305-solder-wire.html?SortType=total_tranpro_desc) | Optional; harder to use than 63/37. Premium: SAC305 (Sn96.5/Ag3/Cu0.5) |
| 117 | Consumable | - | 1 | No-clean flux pen | Generic rosin flux pen | bench | To buy | - | [search](https://www.aliexpress.com/w/wholesale-no-clean-flux-pen.html?SortType=total_tranpro_desc) | Tinning wire ends. Premium: Kester 951 flux pen |
| 118 | Consumable | - | 1 | Solder wire Sn63/Pb37 0.8 mm, rosin core 2 % flux, 100 g | Generic 63/37 rosin core | bench | To buy | - | [value](https://www.aliexpress.com/item/32889029087.html), [Mechanic](https://www.aliexpress.com/item/4000843584127.html) | Signals and the proto board. 63/37 melts at one point (183 °C), the easiest to use. Premium: Kester 44 or Alpha Fry 63/37 (buy locally: fakes are common on AliExpress) |
| 119 | Consumable | - | 1 | Solder wire Sn63/Pb37 1.0-1.2 mm, rosin core, 100 g | Generic 63/37 rosin core | bench | To buy | - | [value](https://www.aliexpress.com/item/32889029087.html), [Mechanic](https://www.aliexpress.com/item/4000843584127.html) | 10/12 AWG lugs, XT60s, motor tabs. Premium: Kester 44 or Alpha Fry (local) |
| 120 | Consumable | - | 1 | Soldering tip tinner / refresher | MECHANIC tip refresher | bench | To buy | - | [search](https://www.aliexpress.com/w/wholesale-soldering-tip-refresher.html?SortType=total_tranpro_desc) | Revives a blackened tip. Premium: Hakko FS-100 or Goot BS-2 |

## Cost: the 24 Oct order

Prices as the PayPal receipt gives them. Some receipt lines are split (two ANL lines, five blade fuse lines); they are added up here.

| Order line | Item (as the receipt truncates it) | ILS | BOM lines |
|---|---|---|---|
| O1 | Wanptek programmable bench supply | 258.19 | 101 |
| O2 | UNI-T UT210E clamp meter | 165.67 | 100 |
| O3 | 10 m/lot wire (lot 1), 10 AWG | 88.34 | 64 |
| O4 | 10 m/lot wire (lot 2), 12 AWG | 64.02 | 65 |
| O5 | ZJW100 (SW80) 125 A contactor | 72.88 | 30 |
| O6 | Crimping pliers kit, Lion Rage HS-30J, 4 jaws ("Pre insulated terminal...") | 70.40 | 99 |
| O7 | Vapcell 18650 | 69.16 | 98 |
| O8 | 6/12 way blade fuse block | 31.01 | 29 |
| O9 | Wire ferrule kit, 2000 pcs (the receipt's "300-2000 pcs" line) | 27.17 | 67 |
| O10 | Ring terminals 220/110 pcs | 24.51 | 66 |
| O11 | AS5600 | 20.22 | 10 |
| O12 | 22 mm E-stop 2NO+2NC | 19.42 | 31 |
| O13 | Resistor kit, 60 values x 5 pcs (300 pcs) | 17.19 | 41, 42, 43, 44, 45, 46, 47 |
| O14 | Electrolytic caps 10-25 V... (bag: 470 µF 50 V low-ESR x10) | 15.28 | 40 |
| O15 | ADS1115 | 14.22 | 8 |
| O16 | ANL fuse holder + 40 A fuse, and 2 spare 40 A fuses (2 lines) | 19.74 | 21 |
| O17 | PCF8574 | 12.14 | 9 |
| O18 | PL2303 USB-TTL 3 pcs (a set: PL2303HX, CP2102, CH340G) | 11.09 | 102 |
| O19 | 12 AWG inline fuse holder x3 | 9.22 | 22, 27, 28 |
| O20 | IRLZ44N x10 | 7.88 | 36 |
| O21 | High-speed switching diodes x50 | 6.74 | 35 |
| O22 | AMS1117 3.3 V | 6.26 | 7 |
| O23 | 1N4007 x100 | 6.16 | 34 |
| O24 | 50 V monolithic caps x100 (2 lines) | 11.19 | 38, 39 |
| O25 | Blade fuses, 5 values (5 lines) | 25.32 | 22, 23, 24, 25, 26, 27, 28 |
| O26 | Metal film resistors x100 (2 lines) | 8.34 | 41, 42, 43, 44, 45, 46, 47 |
|  | **Total** | **1,081.76** |  |

## Variant B instead of the four drive IBT-2s

If #32 picks variant B, these replace U10-U13 and C111-C114 (the steering IBT-2, U14, stays):

| Refs | Qty | Part | Status |
|---|---|---|---|
| U40 | 1 | 74LVC08 quad AND | To buy |
| C40 | 1 | Ceramic capacitor 100n, 50 V | Received 4 Nov |
| R40 | 1 | Resistor 10k, metal film 1 %, 0.25 W | Received 4 Nov |
| U41 U42 | 2 | Cytron MDD20A | To buy |
| C41 C42 | 2 | Electrolytic 470 µF 50 V low-ESR | Received 4 Nov |
| U43 U44 U45 U46 | 4 | Hall current sensor, 3.3 V output (e.g. ACS724 or ACS758 with divider; TBD) | TBD |
