ShaiMiz/RideOnESP32/archive/docs-v2/USER_MANUAL.md

                                                                                                                                                                                                                                                                                                                                                                                                                                                            # ESP32 Power Wheels Controller
                                                                                                                                                                                                                                                                                                                                                                                                                                                            ## Professional User Manual
                                                                                                                                                                                                                                                                                                                                                                                                                                                            ### Can-Am Maverick X3 Conversion Project

                                                                                                                                                                                                                                                                                                                                                                                                                                                            **Firmware Version:** 2.1  
                                                                                                                                                                                                                                                                                                                                                                                                                                                            **Last Updated:** December 2025  
                                                                                                                                                                                                                                                                                                                                                                                                                                                            **Document Version:** 1.0

                                                                                                                                                                                                                                                                                                                                                                                                                                                            ---

                                                                                                                                                                                                                                                                                                                                                                                                                                                            ## ⚠️ SAFETY WARNING

                                                                                                                                                                                                                                                                                                                                                                                                                                                            **READ THIS ENTIRE MANUAL BEFORE OPERATING THE VEHICLE**

                                                                                                                                                                                                                                                                                                                                                                                                                                                            This is a modified children's ride-on vehicle with significantly increased power and capabilities compared to the original. Improper use, assembly, or maintenance can result in:

                                                                                                                                                                                                                                                                                                                                                                                                                                                            - **Electrical shock** (24V system)
                                                                                                                                                                                                                                                                                                                                                                                                                                                            - **Fire hazard** (high current draw)
                                                                                                                                                                                                                                                                                                                                                                                                                                                            - **Injury** from increased speed and power
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

                                                                                                                                                                                                                                                                                                                                                                                                                                                            This manual covers the ESP32-based replacement control system for the Power Wheels Can-Am Maverick X3 ride-on vehicle. The original control board has been replaced with a modern, feature-rich system offering:

                                                                                                                                                                                                                                                                                                                                                                                                                                                            - **Dual Control Modes:** Manual (pedal/shifter) and Remote (radio control)
                                                                                                                                                                                                                                                                                                                                                                                                                                                            - **Advanced Motor Control:** Independent 4-wheel drive with BTS7960 H-bridge drivers
                                                                                                                                                                                                                                                                                                                                                                                                                                                            - **Safety Features:** Voltage monitoring, overcurrent protection, thermal management
                                                                                                                                                                                                                                                                                                                                                                                                                                                            - **Radio Control:** ExpressLRS 2.4GHz long-range system
                                                                                                                                                                                                                                                                                                                                                                                                                                                            - **Real-time Telemetry:** Battery, current, and motor monitoring

                                                                                                                                                                                                                                                                                                                                                                                                                                                            ### 1.2 Key Features

                                                                                                                                                                                                                                                                                                                                                                                                                                                            ✅ **4x Independent Motor Control** - Each wheel controlled separately  
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

                                                                                                                                                                                                                                                                                                                                                                                                                                                            1. **Hardware Protection** (Circuit breaker, XH-M609) - Cannot be overridden
                                                                                                                                                                                                                                                                                                                                                                                                                                                            2. **Thermal Shutdown** (BTS7960 chip-level) - Automatic hardware protection
                                                                                                                                                                                                                                                                                                                                                                                                                                                            3. **Software Emergency Stop** (Overcurrent, over-temperature) - Immediate
                                                                                                                                                                                                                                                                                                                                                                                                                                                            4. **Radio Failsafe** (Remote mode only) - 1-second timeout
                                                                                                                                                                                                                                                                                                                                                                                                                                                            5. **Low Voltage Warning** (Pre-cutoff alert) - Graceful shutdown warning
                                                                                                                                                                                                                                                                                                                                                                                                                                                            6. **Motor Ramping** (Mechanical protection) - Always active

                                                                                                                                                                                                                                                                                                                                                                                                                                                            ---

                                                                                                                                                                                                                                                                                                                                                                                                                                                            ## 6. Assembly Instructions

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
