ShaiMiz/RideOnESP32/docs/COMMISSIONING.md

# Commissioning

Each phase ends with a gate that must pass before the next phase starts. **No child rides until phase 6 passes.** Lines marked *(recommended)* go beyond what any shop-bought ride-on is tested for: run them, but a failure turns that feature off rather than holding the phase ([SAFETY.md](../SAFETY.md), [safety review](reviews/2026-10-safety-standards.md)). Write the date and your initials when a gate passes.

Build the new electronics as a removable box and leave the stock wiring intact. The car can then go back to stock with the spare HY2005RX controller at any time.

## Phase 1: inventory and stock check

- [ ] Count the BTS7960 boards and confirm the four drive motors.
- [ ] Read the battery label: voltage, Ah, chemistry. Write it in [hardware/CAR.md](hardware/CAR.md).
- [ ] Read one drive motor label and the steering motor label. The drive motor current sets the F11-F14 fuse size.
- [ ] Read the key switch rating (#19).
- [ ] Drive the car once on its stock controller, to know its normal speed and feel.

**Gate:** motor count, battery chemistry and Ah written down. Passed: ____

## Phase 2: radio on the desk

- [ ] Charge the T-Lite (18650 cell).
- [ ] Wire only the receiver to the ESP32. Flash `pio run -e radio_check -t upload` and open the monitor.
- [ ] Radio setup steps 1 to 8 in [radio/README.md](../radio/README.md): install the `RideOn` model and scripts, update to EdgeTX 2.12.5 and ExpressLRS 4.1.0 on both radio module and receiver with the binding phrase and receiver Wi-Fi off, run "RideOn ELRS setup" with the car off and then on (Model Match), and record the versions from `RideOn-radio.txt`.

**Gate:**
- [ ] Turning the radio off prints `link OK -> LOST` with the last packet under 200 ms old.
- [ ] Every stick and switch moves the channel [CHANNEL_MAP.md](firmware/CHANNEL_MAP.md) says it does, in the right direction. Moved on its own through its whole travel, each one moves no other channel (SR-32). The left stick moves no channel the car reads, anywhere in its travel; the horn (CH8 above 1900) sounds only while a T1 trim button is held, and stops when it is let go.
- [ ] Letting go of the right stick reads `thr=+0.00 str=+0.00`.
- [ ] The radio bench checks in [radio/README.md](../radio/README.md#bench-phase-2-receiver-on-the-esp32-radio_check-firmware): Model Match, receiver Wi-Fi off, telemetry screen and fault alarm.
- [ ] *(recommended)* Range walk to 150 m with no link drops and link quality never under 70 %, from the radio's log summary ([radio/README.md](../radio/README.md#range-and-reliability-in-the-field)).

Passed: ____

## Phase 3: power chain on the bench

- [ ] Fuse, key, E-stop, contactor, MOSFET and the 5 V buck on a board, with a lamp or one motor as the load ([hardware/POWER_CHAIN.md](hardware/POWER_CHAIN.md)).

**Gate:**
- [ ] With the ESP32 unplugged, the key and the E-stop each cut the load.
- [ ] With the ESP32 running and the contactor held, pressing the ESP32's reset button opens the contactor.
- [ ] *(recommended)* With R5-R7 fitted (motor-bus sense and bleed), the log shows `bus=` near the battery voltage with the contactor closed and under 30 % within 10 s of it opening.
- [ ] *(recommended)* A 100 Ω 5 W resistor across the contactor studs (standing in for a weld) before key-on gives `K1_WELD`, and the contactor never closes.
- [ ] *(recommended)* Pulling the F3 coil fuse with the car armed gives `NO_BUS`.
- [ ] Event log on flash ([LOG_EVENTS.md](firmware/LOG_EVENTS.md)): cut the ESP32's power 10 times, some while it is printing. Every boot prints `BOOT` with the boot number one higher, and `LOG_MOUNT` with `records=` never going down and `torn=` at most 1.
- [ ] Watchdog: with the contactor held and the car Locked, type `test watchdog` in the serial monitor. The contactor opens, the ESP32 restarts, and the next boot prints `BOOT reset=WATCHDOG`. `log 20` shows the records from before the restart.
- [ ] Bluetooth log ([hardware/BLUETOOTH.md](hardware/BLUETOOTH.md)), if fitted: `bt_setup` ended with `done`; U33 TXD is not connected (check with a meter: no continuity from TXD to any ESP32 pin). An iPhone and an Android phone each connect to `RideOn` and show the live log. With the car Locked, holding the horn 3 s prints the whole report on the phone, ending with the last log record; holding it while Parent mode is armed and the wheels turn prints nothing.

Passed: ____

## Phase 4: one motor, one driver

- [ ] One IBT-2 on the front-left pins, one motor, one ADS1115 at 0x48. Fill in `IS_PIN_RESISTOR_OHMS` (the resistor on one IS pin; the firmware halves it) and the battery thresholds in `config.h`.
- [ ] Flash `pio run -e one_motor -t upload`.

**Gate:**
- [ ] Pulling the receiver plug while the motor runs stops it.
- [ ] Turning the radio off while the motor runs at full output brings the output to zero within 0.75 s.
- [ ] After any fault, holding the throttle never restarts the motor. It restarts only after the mode switch goes through Locked with the stick centred.
- [ ] The kill switch stops the motor and opens the contactor.
- [ ] *(recommended once F11-F14 are fitted)* The logged current agrees with a clamp meter at three loads (free spin, light brake, heavy brake). If it reads about half or double, `IS_PIN_RESISTOR_OHMS` is wrong (the firmware halves it for the joined IS pins).
- [ ] A driver or over-current fault opens the contactor as well as cutting the drive enable.
- [ ] Driver temperature after 10 minutes at 16 kHz PWM is acceptable to the touch.

Passed: ____

## Phase 5: whole car, wheels off the ground

- [ ] Car on blocks. All five drivers, both ADS1115s, the PCF8574, the PCA9685, the DS18B20 and the pedal connected. F11-F14 fitted, sized from the motor label. Steering calibrated (once `SteeringController` is written).
- [ ] Wheel direction: give a small forward command and check each wheel on its own. Set `WHEEL_REVERSED` in `config.h` for any wheel that turns backwards, reflash, and check again.
- [ ] Both box fans run from key-on (log `fan=1`), and the log shows a sensible `box=` temperature. Then set `BOX_TEMP_REQUIRED = true`.
- [ ] Flash `pio run -e car -t upload`.

**Gate:** every fault you can cause stops all wheels:
- [ ] Link loss (radio off, receiver unplugged)
- [ ] Low voltage (bench supply turned down), and the battery sense wire unplugged
- [ ] Kill switch, E-stop, key
- [ ] Box temperature: warming the DS18B20 past 65 °C (hair dryer) gives `HOT`, and unplugging it gives `HOT` once required
- [ ] Pedal held while re-arming does not start the wheels
- [ ] Steering never fights a hand in Kid mode
- [ ] The parent stick-back brake overrides the pedal in Kid mode
- [ ] Crash recorder: with the wheels turning in Parent mode, press the E-stop. The log shows `CRASH_SAVED cause=FAULT ESTOP`, and `crash` lists 50 samples with the output ramping up and the E-stop moment last. Power-cycle: `crash` still shows it

**Gate:** heat and touch, as a toy lab tests a stock car:
- [ ] Locked wheel: hold one wheel, full throttle for 30 s, then until its fuse blows or `OVERCUR`/`DRIVER` trips. Repeat for each wheel. Nothing smokes, and no wire, motor, driver heatsink or box surface is too hot to keep a hand on (about 50 °C; an IR thermometer helps)
- [ ] Walk round the car: no sharp edges, screw tips, cut metal or zip-tie ends where the child sits or reaches; fan guards on; our box can't come loose

Passed: ____

## Phase 6: ground tests, adult only

- [ ] An empty car, then a sandbag of the child's weight, at the lowest speed cap, in an open flat area.

**Gate:**
- [ ] Top speed at each cap (phone GPS, or 10 m and a stopwatch): ____ / ____ / ____ km/h. The top cap is within the limit for the rider's age: 16 km/h from age 6, 6 km/h under 6
- [ ] Slope hold: on a 10° slope with the sandbag, key off, the car moves no more than 5 cm. If it rolls, fix it before a child rides (low-side brake while parked, or motor-shorting relays; safety review item M2)
- [ ] Link-loss stop measured at the top cap: ____
- [ ] Full-throttle starts uphill with the sandbag: no `OVERCUR`, no blown fuse
- [ ] Surface temperatures after 20 minutes of hard driving: box and heatsinks comfortable to touch
- [ ] *(recommended)* Stopping distance measured at each speed cap: ____ / ____ / ____
- [ ] All acceptable.

Passed: ____

## Phase 7: kid rides, low cap

- [ ] Parent mode first, then Kid mode with the parent holding the radio.
- [ ] Add features from the list one at a time, each with its own bench test.
