ShaiMiz/RideOnESP32/CHANGELOG.md

# Changelog

## 3.0.0 (in progress)

A fresh start as a PlatformIO project, built on the v2.2 motor class and the [code review](docs/reviews/2026-10-firmware-code-tour.md).

- New layout: a single `src/main.cpp` entry point, `include/pins.h` and `include/config.h`, and the hardware-free safety core in `lib/rideon_core` with PC unit tests.
- Radio channels are 1-based, matching AlfredoCRSF. v2 read channel 0, which is past the array.
- The link is judged by packet age (200 ms), the receiver link flag and the link quality, never by channel values.
- Faults latch and clear only by re-arming from Locked with the sticks centred and the pedal released.
- GPIO21 is a real kill line: LOW at boot until PWM is zeroed, and dropped on every hard fault and the kill switch.
- Contactor hold on GPIO12 and steering enable on GPIO2.
- Pin audit against the ESP32-WROOM-32D datasheet and errata: wheel-speed inputs move to GPIO34/35 (GPIO36/39 glitch when the ADC runs), pedal to GPIO36, battery sense to GPIO39, DS18B20 on GPIO15. New [PINOUT.md](docs/hardware/PINOUT.md) describes every pin. Pin rules run as static_asserts in every build, with a unit test and a docs consistency check in CI.
- New pin map: the shared pins are gone, and RR_RPWM is off strapping pin 12.
- Current sensing goes through an ADS1115 at the real 8500:1 ratio, is active in every mode, and treats IS saturation as a driver fault.
- Out-of-range battery readings are a fault, not "OK". Low-voltage cutoff now has hysteresis.
- Separate acceleration and braking ramps, no reverse until stopped, and reverse capped at 50 %.
- Fixed 100 Hz loop, task watchdog, reset reason logged, and a serial log that never blocks.
- Docs: draft schematic v0.2, safety-standards review, audio plan, and a CLAUDE.md for Claude Code.
- Bench firmwares `radio_check` (phase 2) and `one_motor` (phase 4).
- First photos of the stock car ([CAR.md](docs/hardware/CAR.md)): the battery pack has an 18 A thermal breaker that stays in circuit, so the whole car shares 18 A sustained, and the stock power switch is a START/STOP button, not a key.
- Safety gates follow the toy standards: SAFETY.md and COMMISSIONING.md split into required (what a lab tests on a shop-bought ride-on) and recommended. New required checks: per-motor fuses F11-F14, locked-wheel heat test, slope hold, top speed for the rider's age, key switch rating, edges.
- Event log: every boot, fault trip, fault end, re-arm, mode, link and battery change is a 32-byte record with boot number, uptime, severity, category, part and values, printed as one line on serial. A fault table counts each fault per part with first/last seen, worst value and freeze frames. Events are listed in [LOG_EVENTS.md](docs/firmware/LOG_EVENTS.md).
- The log and the fault table survive power-off: records go to a 256 KB flash ring (`evlog` partition, new `partitions.csv`), the fault table to NVS, and a panic or watchdog reset leaves a crash dump that the next boot logs. Flash is erased only at boot or with the car stopped.
- Schematic v0.3 in KiCad 9 (docs/hardware/kicad): a one-page system wiring overview, net names, connector pinouts, a checked wire list with gauge, colour and fuse per wire, and a BOM matched to the 24 Oct order. Safety changes from v0.2: both E-stop NC blocks in the contactor coil, an enable pull-down at every driver, a protected pedal supply, fuses on the 12 V outputs. Plus a v2-vs-v3 hardware comparison.
- One BOM for the project (docs/hardware/kicad/BOM.md and .csv): one numbered line per distinct part, with category, manufacturer / part number, status, order line and the cost of the 24 Oct order; also the tools, materials and spares. docs/hardware/BOM.md now points there.
- BOM, 9 Nov parts check: the 470 µF bus capacitors (C111-C115) are 50 V low-ESR, so they are safe on the 24 V bus; two ADS1115 bags arrived; all five blade fuse values (1, 2, 3, 10, 15 A) and the 40 A ANL fuse for F1 are in hand; the three inline fuse holders cover F2, F9 and F10, and F11-F14 still need four more.
- No fuse per drive motor (F11-F14 removed; Shai, 10 Nov: no room in the box). The firmware over-current fault is the stall protection, so current-sensor calibration against a clamp meter is a required gate again, and the phase 5 locked-wheel test must measure a stall current above `MOTOR_CURRENT_LIMIT_A`.
- Verification scope ([VERIFICATION.md](docs/VERIFICATION.md)): 29 safety requirements (SR-01 to SR-29), each mapped to its tests and commissioning gates, checked in CI. The whole per-tick decision path moved from `main.cpp` into `rideon::Controller` and `rideon::SafetyRules`, so it runs in the PC tests with the real `config.h` values: link loss, kill switch, E-stop, every fault, re-arming, Kid caps, and 200 000 ticks of random input with the safety invariants checked every tick. The `one_motor` bench uses the same rules. New CI job `verify`: every suite under AddressSanitizer and UndefinedBehaviorSanitizer, coverage floors, cppcheck, and a mutation check (32 deliberate safety bugs, each caught). Our own code now builds with `-Werror`.
- Crash recorder: the last 5 s of driving (50 freeze frames: mode, link quality, command, output, pedal, voltages, motor currents, box temperature) live in RTC memory, and a hard fault or a panic, watchdog or brownout reset while driving saves them to NVS (`CRASH_SAVED`). Serial console at 115200 baud: `help`, `status`, `log [n]`, `dtc`, `crash`, and with the car stopped `clear dtc yes` and `test watchdog`. It cannot arm, drive or change a limit (SR-30, SR-31).
- Radio telemetry (#38): battery voltage, drive current, charge used and a status text with the mode and the first latched fault (`LOCKED ESTOP`) show on the T-Lite as `RxBt`, `Curr`, `Capa` and `FM`. At most 5 frames a second, written only when the UART has room, so it never delays the loop. EdgeTX setup and alarms in [radio/MODEL_SETUP.md](radio/MODEL_SETUP.md).
- Radio setup from files: the `RideOn` EdgeTX model ships as `radio/edgetx/sdcard/MODELS/model42.yml` (switches SC kill, SA mode, SB Kid speed, left stick sideways horn; trims off; start-up switch check; telemetry sensors, screen and logging), with a telemetry screen that vibrates and beeps on faults, mode changes, low battery and weak or lost link, and a "RideOn ELRS setup" radio tool that sets packet rate, switch mode, telemetry ratio, power and Model Match, refuses unless the radio is on KILL and Locked, and records the exact radio, module and receiver versions. `radio/install_radio.py` backs up the SD card, installs the files, checks versions and stick mode, makes the binding phrase and summarises the range-test logs. Targets EdgeTX 2.12.5 and ExpressLRS 4.1.0. CI checks the model against the channel map and `config.h`, and runs the Lua scripts against a simulated EdgeTX and ELRS module ([radio/README.md](radio/README.md)).
- Listen-only Bluetooth log: an HM-10 BLE module (U33) on TX0 through 1k lets an iPhone or Android phone read the serial log; its TXD is not connected, and the ESP32's own radios stay off. Holding the horn 3 s with the car parked (or typing `report`) prints status, fault table, crash copy and the last 50 records. New `bt_setup` bench firmware sets the module to 115200. Schematic, wire list, BOM and 3D view updated ([BLUETOOTH.md](docs/hardware/BLUETOOTH.md)).
- New 3D radio view (tools/radio-view, React Three Fiber): the Jumper T-Lite V2 with every stick, switch, trim and key, reading `model42.yml`, `ChannelMap.h` and `config.h` straight from the repo. Moving a control shows the radio screen (a port of `rideon.lua`), the 16 CRSF channels in µs, and what the firmware's channel and mode rules make of them. A mapping editor changes which control drives each channel, the logical switches and the start-up check; it runs the safety checks (one 2-position switch kills, the start-up positions mean KILL and Locked, sticks let go means stop) over every switch combination and blocks the export until they pass, then saves a `model42.yml` for `install_radio.py`.
- Radio controls don't cross (SR-32): a firmware test moves each control on its own in every mode and checks that only its own output changes, the radio view checks that every control reaches one channel only over all switch and stick positions, and its mapping editor blocks an edit that makes one control drive two functions. The horn moves off the left stick (sideways past half way, easy to set off by accident) to the T1 trim buttons under the left stick: a real push-button, on only while held. The trims are already off, so EdgeTX lets the buttons act as switches. The left stick now does nothing. Re-run the phase 2 channel-monitor check for CH8.
- Link-loss stop requirement is now 0.75 s to zero output (was 0.5 s, which the firmware's 200 ms detect plus 0.5 s brake never met). The full-speed link-loss test checks it (SR-26).
- The pioarduino platform for Arduino core 3.x. AlfredoCRSF is pinned to a commit. The MCP23017 libraries are dropped.
- The v2 docs, sketches and PDFs moved to `archive/`.
- New `ESTOP` fault: the E-stop sense input locks the car and holds the contactor open, so releasing the E-stop with the pedal held no longer restarts it.
- New `CUR_SENS` fault: every ADS1115 transfer is checked, and a current channel with no good reading for 250 ms stops the car instead of keeping its last value. The Adafruit ADS1X15 and BusIO libraries are dropped.
- `DRIVER` waits 300 ms like `OVERCUR`, so start-up inrush no longer trips it, and the steering board's IS line is checked too.
- The `one_motor` bench firmware has the task watchdog.
- RC frames are found with the same resync as AlfredoCRSF, so a stray byte no longer hides a real frame and trips `LINK`.
- Firmware matched to schematic v0.3:
  - Current sense now uses half the per-pin IS resistor (`IS_PIN_RESISTOR_OHMS`), since R_IS and L_IS are joined. Before this, current read about half the real value, so the 20 A limit really sat near 40 A. The `DRIVER` level comes from the resistor (1.8 V with 1k boards) instead of a fixed 3.2 V.
  - `DRIVER` and `OVERCUR` open the contactor, because a shorted driver MOSFET ignores its enable. The drive enable now drops before the contactor opens.
  - The motor bus is read on ADS1115 #2 A2 (new R5-R7 in the schematic, with a bleed resistor). At boot the contactor stays open until the bus has drained; a bus still live after 10 s is the new permanent `K1_WELD` fault. A contactor held closed with no bus is the new `NO_BUS` fault.
  - I2C runs at 100 kHz, the PCF8574's rating, instead of 400 kHz.
  - The box fans run whenever the ESP32 runs (PCA9685 channel 1). The DS18B20 is read, and a box above 65 °C is the new `HOT` fault.
  - `WHEEL_REVERSED` in `config.h` flips any wheel whose motor turns backwards.
- New 3D exploded view of the car and the electronics box (tools/exploded-view, React Three Fiber), generated from the BOM, the wire list and the schematic nets: realistic and blueprint styles, show/hide by part, info cards with upstream and downstream wiring, variant A/B swap, revision history, and GLB/glTF/PNG/PDF/JSON export.

## 2.2 (2026)

An OOP refactor of 2.1: a `BTS7960Motor` class with signed speed and ramping through zero. It compiled, but kept every safety bug from 2.1. It also dropped about 60 to 80 lines of warnings and checks, and read current only in REMOTE mode. Archived in `archive/v2.2/`.

## 2.1 (2025)

Pin reallocation for 24 V, plus CRSF at 420000 baud, a "thermal FAULT" input and current sensing on the IS pins. It never compiled: four IS pin `#define`s were commented out but still used. Archived in `archive/v2.1/`.

## 2.0 and earlier

See [archive/docs-v2/CHANGELOG.md](archive/docs-v2/CHANGELOG.md).
