ShaiMiz/RideOnESP32/docs/hardware/kicad/accessories.kicad_sch

## KiCad design docs/hardware/kicad/accessories.kicad_sch (2026-11-04)

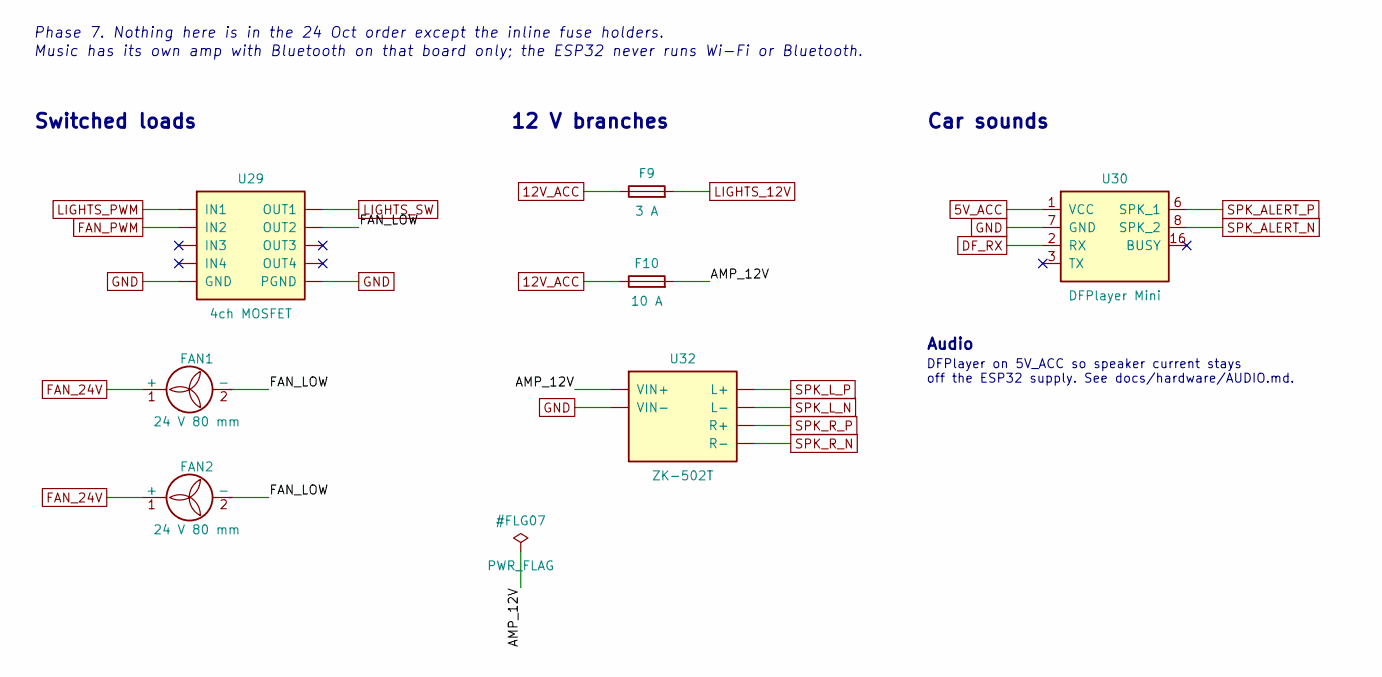
[picture p7: schematic accessories.kicad_sch]

Parts:
F9: 3 A; Part Inline blade fuse holder (ordered, 3 pc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
F10: 10 A; Part Inline blade fuse holder (ordered, 3 pc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
FAN1: 24 V 80 mm; Part 24 V 80 mm fan, finger guard, filter (i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
FAN2: 24 V 80 mm; Part 24 V 80 mm fan, finger guard (exhaust)
U29: 4ch MOSFET; Part 4-channel low-side MOSFET board, logic-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
U30: DFPlayer Mini; Part DFPlayer Mini + micro-SD card
U32: ZK-502T; Part ZK-502T Bluetooth amp

Connections:
5V_ACC: U30.1 (VCC)
12V_ACC: F9.1, F10.1
AMP_12V: F10.2, U32.VIN+
DF_RX: U30.2 (RX)
FAN_24V: FAN1.1 (+), FAN2.1 (+)
FAN_LOW: FAN1.2 (-), FAN2.2 (-), U29.OUT2
FAN_PWM: U29.IN2
GND: U29.GND, U29.PGND, U30.7 (GND), U32.VIN-
LIGHTS_12V: F9.2
LIGHTS_PWM: U29.IN1
LIGHTS_SW: U29.OUT1
SPK_ALERT_N: U30.8 (SPK_2)
SPK_ALERT_P: U30.6 (SPK_1)
SPK_L_N: U32.L-
SPK_L_P: U32.L+
SPK_R_N: U32.R-
SPK_R_P: U32.R+

Notes on the sheet:
Switched loads
12 V branches
Car sounds
Audio
DFPlayer on 5V_ACC so speaker current stays off the ESP32 supply. See docs/hardware/AUDIO.md.
Phase 7. Nothing here is in the 24 Oct order except the inline fuse holders.
Music has its own amp with Bluetooth on that board only; the ESP32 never runs Wi-Fi or Bluetooth.
