ShaiMiz/RideOnESP32/docs/hardware/kicad/controller.kicad_sch

## KiCad design docs/hardware/kicad/controller.kicad_sch (2026-11-04)

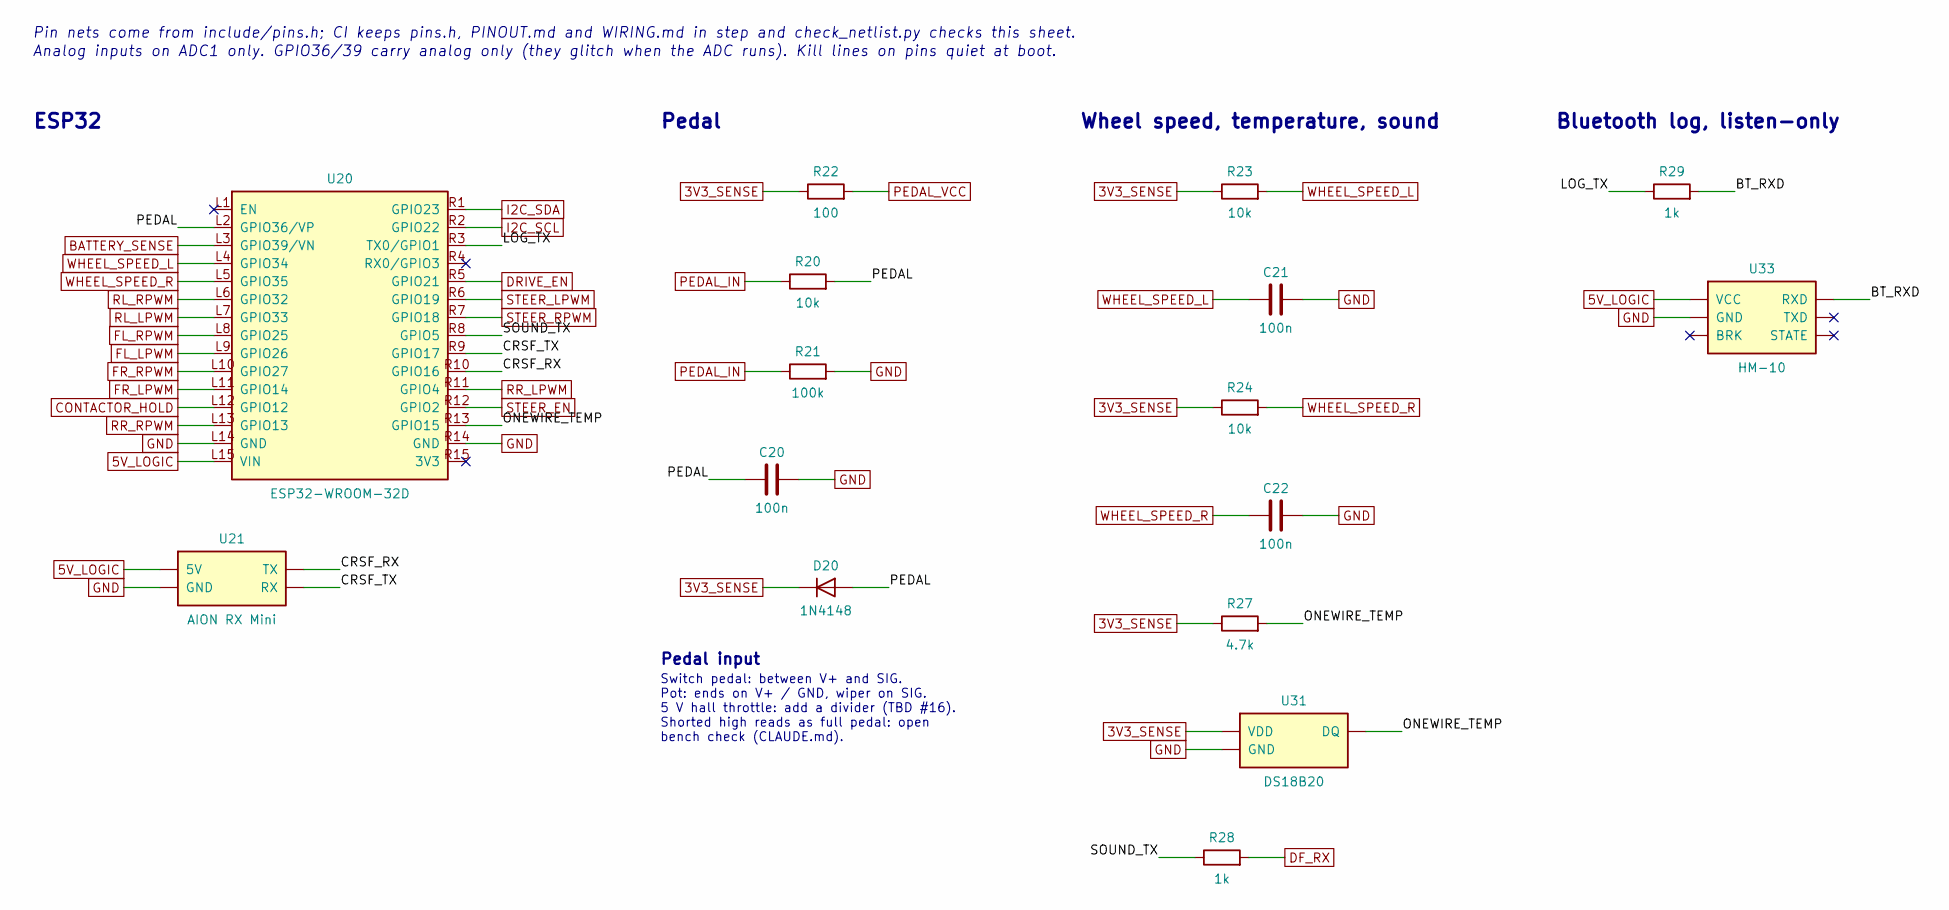
[picture p8: schematic controller.kicad_sch]

Parts:
C20, C21, C22: 100n; Part Ceramic capacitor 100n, 50 V
D20: 1N4148; Part 1N4148, clamp to 3.3 V
R20, R23, R24: 10k; Part Resistor 10k, metal film 1 %, 0.25 W
R21: 100k; Part Resistor 100k, metal film 1 %, 0.25 W
R22: 100; Part Resistor 100, metal film 1 %, 0.25 W
R27: 4.7k; Part Resistor 4.7k, metal film 1 %, 0.25 W
R28, R29: 1k; Part Resistor 1k, metal film 1 %, 0.25 W
U20: ESP32-WROOM-32D; Part ESP32-WROOM-32D 30-pin DevKit, USB-C, o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
U21: AION RX Mini; Part Jumper AION RX Mini ELRS receiver
U31: DS18B20; Part DS18B20 waterproof probe
U33: HM-10; Part HM-10 BLE serial module (iPhone and And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

Connections:
3V3_SENSE: D20.1 (K), R22.1, R23.1, R24.1, R27.1, U31.VDD
5V_LOGIC: U20.L15 (VIN), U21.5V, U33.VCC
BATTERY_SENSE: U20.L3 (GPIO39/VN)
BT_RXD: R29.2, U33.RXD
CONTACTOR_HOLD: U20.L12 (GPIO12)
CRSF_RX: U20.R10 (GPIO16), U21.TX
CRSF_TX: U20.R9 (GPIO17), U21.RX
DF_RX: R28.2
DRIVE_EN: U20.R5 (GPIO21)
FL_LPWM: U20.L9 (GPIO26)
FL_RPWM: U20.L8 (GPIO25)
FR_LPWM: U20.L11 (GPIO14)
FR_RPWM: U20.L10 (GPIO27)
GND: C20.2, C21.2, C22.2, R21.2, U20.L14 (GND), U20.R14 (GND), U21.GND, U31.GND, U33.GND
I2C_SCL: U20.R2 (GPIO22)
I2C_SDA: U20.R1 (GPIO23)
LOG_TX: R29.1, U20.R3 (TX0/GPIO1)
ONEWIRE_TEMP: R27.2, U20.R13 (GPIO15), U31.DQ
PEDAL: C20.1, D20.2 (A), R20.2, U20.L2 (GPIO36/VP)
PEDAL_IN: R20.1, R21.1
PEDAL_VCC: R22.2
RL_LPWM: U20.L7 (GPIO33)
RL_RPWM: U20.L6 (GPIO32)
RR_LPWM: U20.R11 (GPIO4)
RR_RPWM: U20.L13 (GPIO13)
SOUND_TX: R28.1, U20.R8 (GPIO5)
STEER_EN: U20.R12 (GPIO2)
STEER_LPWM: U20.R6 (GPIO19)
STEER_RPWM: U20.R7 (GPIO18)
WHEEL_SPEED_L: C21.1, R23.2, U20.L4 (GPIO34)
WHEEL_SPEED_R: C22.1, R24.2, U20.L5 (GPIO35)

Notes on the sheet:
ESP32
Pedal
Pedal input
Switch pedal: between V+ and SIG. Pot: ends on V+ / GND, wiper on SIG. 5 V hall throttle: add a divider (TBD #16). Shorted high reads as full pedal: open bench check (CLAUDE.md).
Wheel speed, temperature, sound
Bluetooth log, listen-only
Pin nets come from include/pins.h; CI keeps pins.h, PINOUT.md and WIRING.md in step and check_netlist.py checks this sheet.
Analog inputs on ADC1 only. GPIO36/39 carry analog only (they glitch when the ADC runs). Kill lines on pins quiet at boot.
