ShaiMiz/RideOnESP32/docs/hardware/kicad/drive.kicad_sch

## KiCad design docs/hardware/kicad/drive.kicad_sch (2026-11-10)

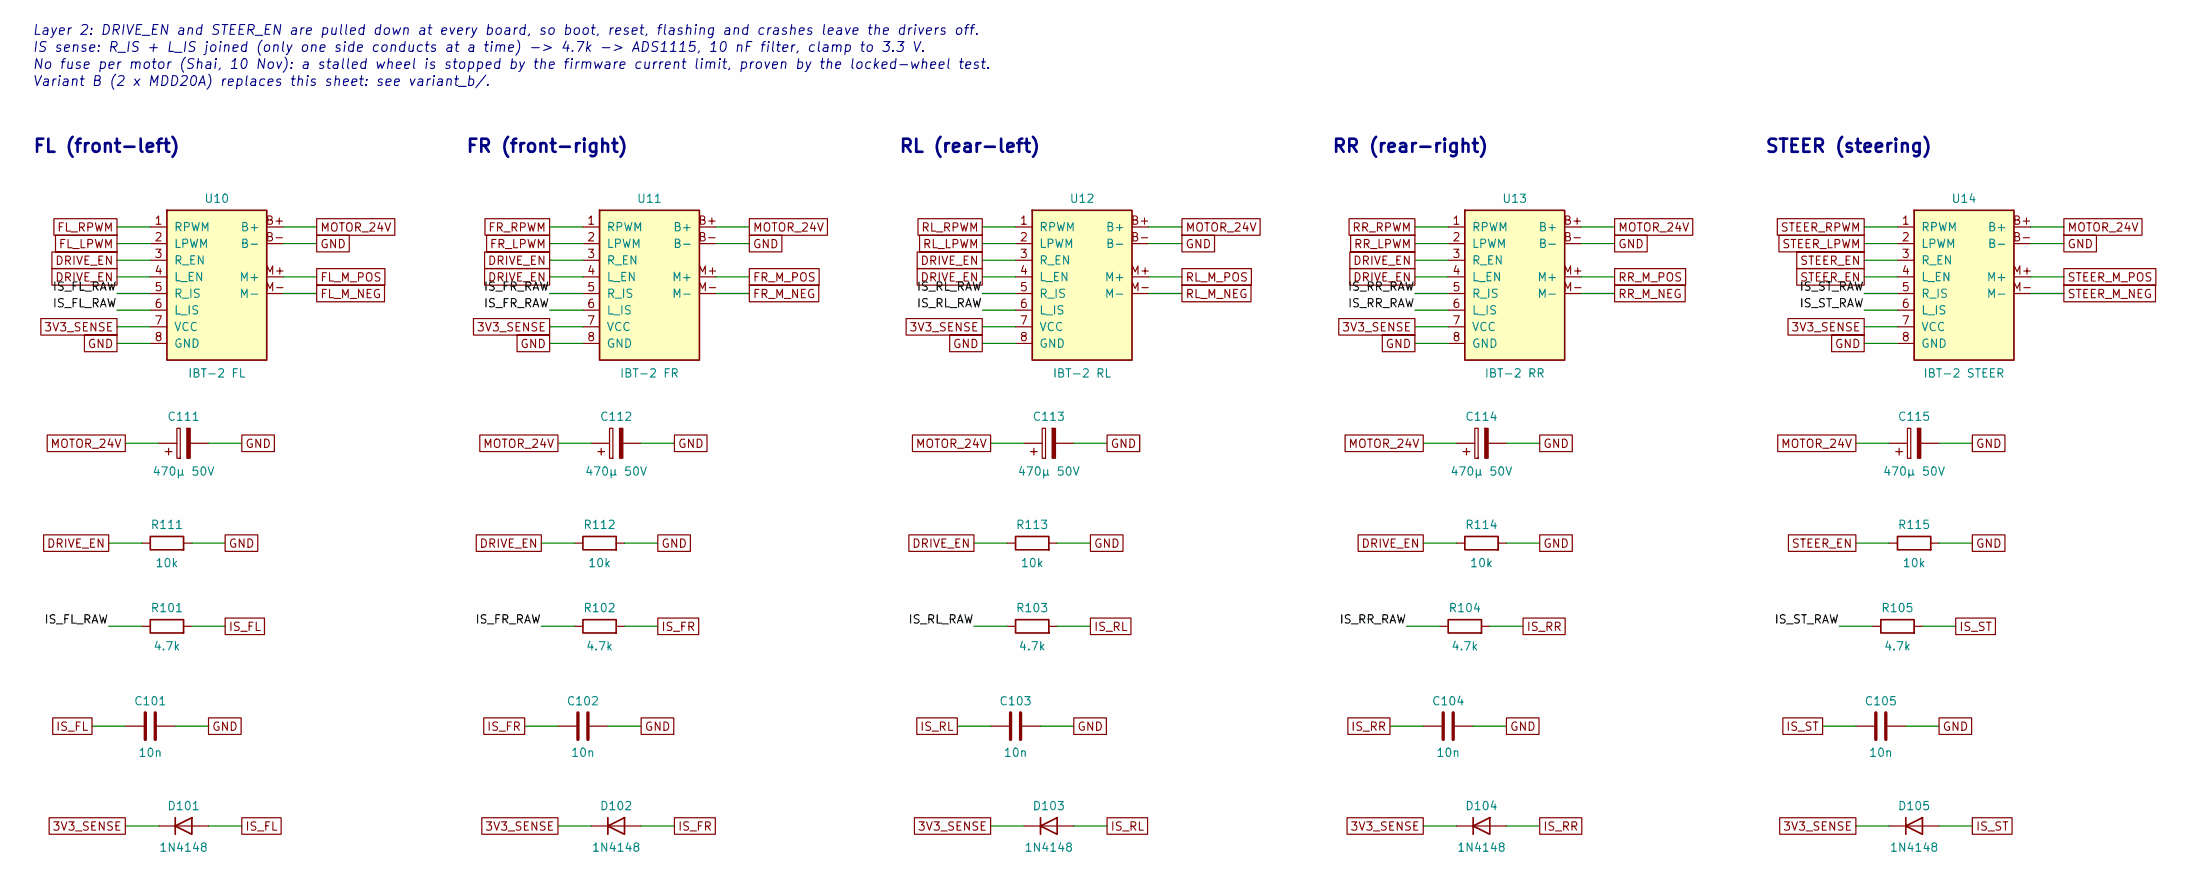
[picture p9: schematic drive.kicad_sch]

Parts:
C101, C102, C103, C104, C105: 10n; Part Ceramic capacitor 10n, 50 V
C111, C112, C113, C114, C115: 470µ 50V; Part Electrolytic 470 µF 50 V low-ESR
D101, D102, D103, D104, D105: 1N4148; Part 1N4148 (ordered high-speed switching di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
R101, R102, R103, R104, R105: 4.7k; Part Resistor 4.7k, metal film 1 %, 0.25 W
R111, R112, R113, R114, R115: 10k; Part Resistor 10k, metal film 1 %, 0.25 W
U10: IBT-2 FL; Part IBT-2 (BTS7960) board, front-left
U11: IBT-2 FR; Part IBT-2 (BTS7960) board, front-right
U12: IBT-2 RL; Part IBT-2 (BTS7960) board, rear-left
U13: IBT-2 RR; Part IBT-2 (BTS7960) board, rear-right
U14: IBT-2 STEER; Part IBT-2 (BTS7960) board, steering

Connections:
3V3_SENSE: D101.1 (K), D102.1 (K), D103.1 (K), D104.1 (K), D105.1 (K), U10.7 (VCC), U11.7 (VCC), U12.7 (VCC), U13.7 (VCC), U14.7 (VCC)
DRIVE_EN: R111.1, R112.1, R113.1, R114.1, U10.3 (R_EN), U10.4 (L_EN), U11.3 (R_EN), U11.4 (L_EN), U12.3 (R_EN), U12.4 (L_EN), U13.3 (R_EN), U13.4 (L_EN)
FL_LPWM: U10.2 (LPWM)
FL_M_NEG: U10.M-
FL_M_POS: U10.M+
FL_RPWM: U10.1 (RPWM)
FR_LPWM: U11.2 (LPWM)
FR_M_NEG: U11.M-
FR_M_POS: U11.M+
FR_RPWM: U11.1 (RPWM)
GND: C101.2, C102.2, C103.2, C104.2, C105.2, C111.2, C112.2, C113.2, C114.2, C115.2, R111.2, R112.2, R113.2, R114.2, R115.2, U10.8 (GND), U10.B-, U11.8 (GND), U11.B-, U12.8 (GND), U12.B-, U13.8 (GND), U13.B-, U14.8 (GND), U14.B-
IS_FL: C101.1, D101.2 (A), R101.2
IS_FL_RAW: R101.1, U10.5 (R_IS), U10.6 (L_IS)
IS_FR: C102.1, D102.2 (A), R102.2
IS_FR_RAW: R102.1, U11.5 (R_IS), U11.6 (L_IS)
IS_RL: C103.1, D103.2 (A), R103.2
IS_RL_RAW: R103.1, U12.5 (R_IS), U12.6 (L_IS)
IS_RR: C104.1, D104.2 (A), R104.2
IS_RR_RAW: R104.1, U13.5 (R_IS), U13.6 (L_IS)
IS_ST: C105.1, D105.2 (A), R105.2
IS_ST_RAW: R105.1, U14.5 (R_IS), U14.6 (L_IS)
MOTOR_24V: C111.1, C112.1, C113.1, C114.1, C115.1, U10.B+, U11.B+, U12.B+, U13.B+, U14.B+
RL_LPWM: U12.2 (LPWM)
RL_M_NEG: U12.M-
RL_M_POS: U12.M+
RL_RPWM: U12.1 (RPWM)
RR_LPWM: U13.2 (LPWM)
RR_M_NEG: U13.M-
RR_M_POS: U13.M+
RR_RPWM: U13.1 (RPWM)
STEER_EN: R115.1, U14.3 (R_EN), U14.4 (L_EN)
STEER_LPWM: U14.2 (LPWM)
STEER_M_NEG: U14.M-
STEER_M_POS: U14.M+
STEER_RPWM: U14.1 (RPWM)

Notes on the sheet:
FL (front-left)
FR (front-right)
RL (rear-left)
RR (rear-right)
STEER (steering)
Layer 2: DRIVE_EN and STEER_EN are pulled down at every board, so boot, reset, flashing and crashes leave the drivers off.
IS sense: R_IS + L_IS joined (only one side conducts at a time) -> 4.7k -> ADS1115, 10 nF filter, clamp to 3.3 V.
No fuse per motor (Shai, 10 Nov): a stalled wheel is stopped by the firmware current limit, proven by the locked-wheel test.
Variant B (2 x MDD20A) replaces this sheet: see variant_b/.
