ShaiMiz/RideOnESP32/docs/hardware/kicad/harness.kicad_sch

## KiCad design docs/hardware/kicad/harness.kicad_sch (2026-11-04)

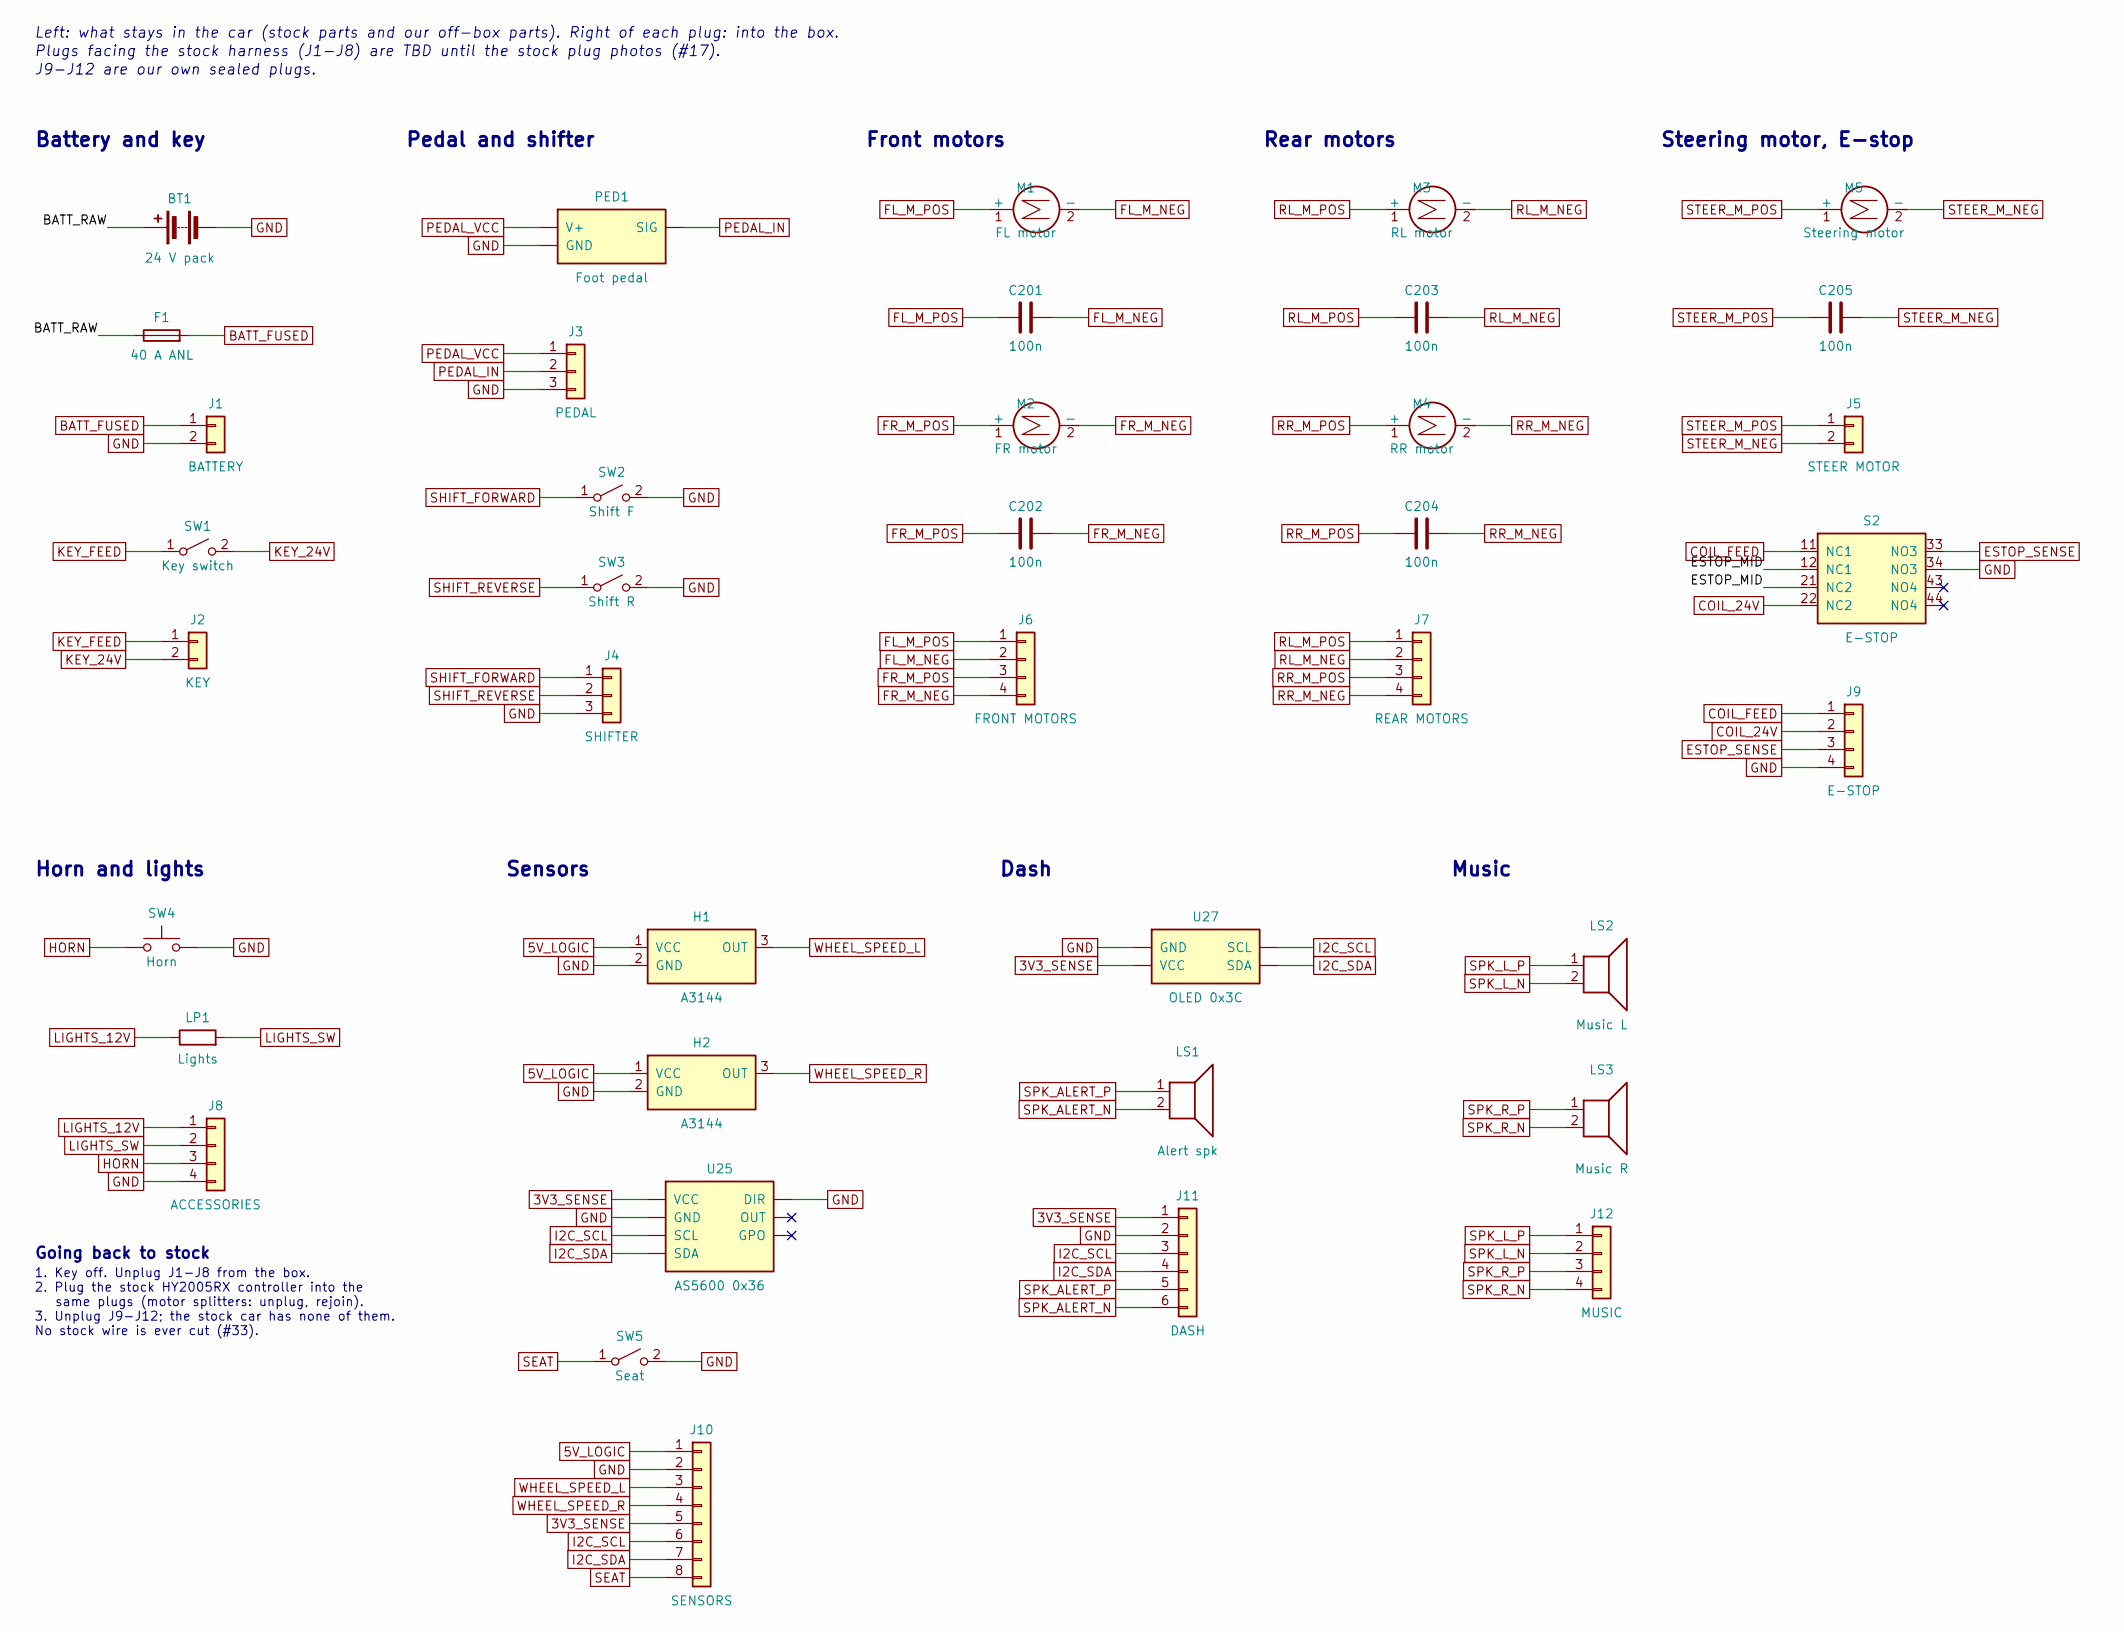
[picture p10: schematic harness.kicad_sch]

Parts:
BT1: 24 V pack; Part Stock 24 V battery; voltage, Ah, chemis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
C201, C202, C203, C204, C205: 100n; Part Ceramic capacitor 100 nF 50 V, across t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
F1: 40 A ANL; Part ANL fuse holder + 40 A ANL fuse
H1: A3144; Part A3144 hall switch + magnet on the left 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
H2: A3144; Part A3144 hall switch + magnet on the right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
J1: BATTERY; Part Mate of the stock battery plug (fallbac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
J2: KEY; Part Mate of the stock key-switch plug
J3: PEDAL; Part Mate of the stock pedal plug
J4: SHIFTER; Part Mate of the stock shifter plug
J5: STEER MOTOR; Part Mate of the stock steering-motor plug (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
J6: FRONT MOTORS; Part Mate of the stock front-motor plug(s); 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
J7: REAR MOTORS; Part Mate of the stock rear-motor plug(s); s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
J8: ACCESSORIES; Part Mate of the stock lights/horn plug (pin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
J9: E-STOP; Part Sealed 4-way, Deutsch DT04-4P / DT06-4S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
J10: SENSORS; Part Sealed 8-way, Deutsch DT04-08PA / DT06-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
J11: DASH; Part Sealed 6-way, Deutsch DT04-6P / DT06-6S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
J12: MUSIC; Part 4-way, Deutsch DT04-4P / DT06-4S (or cl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
LP1: Lights; Part Stock lights (load shown as a resistor;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
LS1: Alert spk; Part 3 in 4 Ω full-range speaker, car sounds
LS2: Music L; Part 3 in full-range speaker (+ DDT-S30 twee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
LS3: Music R; Part 3 in full-range speaker (+ DDT-S30 twee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
M1: FL motor; Part Stock front-left drive motor (label TBD)
M2: FR motor; Part Stock front-right drive motor (label TB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
M3: RL motor; Part Stock rear-left drive motor (label TBD)
M4: RR motor; Part Stock rear-right drive motor (label TBD)
M5: Steering motor; Part Stock steering motor (label TBD)
PED1: Foot pedal; Part Stock pedal: switch, pot or hall thrott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
S2: E-STOP; Part 22 mm latching E-stop 2NO + 2NC
SW1: Key switch; Part Stock dash key switch (rating TBD; if <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
SW2: Shift F; Part Stock shifter, forward contact (must be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
SW3: Shift R; Part Stock shifter, reverse contact (must be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
SW4: Horn; Part Stock horn button
SW5: Seat; Part Seat switch, closes with a child seated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
U25: AS5600 0x36; Part AS5600 module + diametric magnet
U27: OLED 0x3C; Part 0.91 in SSD1306 OLED

Connections:
3V3_SENSE: J10.5, J11.1, U25.VCC, U27.VCC
5V_LOGIC: H1.1 (VCC), H2.1 (VCC), J10.1
BATT_FUSED: F1.2, J1.1
BATT_RAW: BT1.1 (+), F1.1
COIL_24V: J9.2, S2.22 (NC2)
COIL_FEED: J9.1, S2.11 (NC1)
ESTOP_MID: S2.12 (NC1), S2.21 (NC2)
ESTOP_SENSE: J9.3, S2.33 (NO3)
FL_M_NEG: C201.2, J6.2, M1.2 (-)
FL_M_POS: C201.1, J6.1, M1.1 (+)
FR_M_NEG: C202.2, J6.4, M2.2 (-)
FR_M_POS: C202.1, J6.3, M2.1 (+)
GND: BT1.2 (-), H1.2 (GND), H2.2 (GND), J1.2, J3.3, J4.3, J8.4, J9.4, J10.2, J11.2, PED1.GND, S2.34 (NO3), SW2.2 (B), SW3.2 (B), SW4.2, SW5.2 (B), U25.DIR, U25.GND, U27.GND
HORN: J8.3, SW4.1
I2C_SCL: J10.6, J11.3, U25.SCL, U27.SCL
I2C_SDA: J10.7, J11.4, U25.SDA, U27.SDA
KEY_24V: J2.2, SW1.2 (B)
KEY_FEED: J2.1, SW1.1 (A)
LIGHTS_12V: J8.1, LP1.1
LIGHTS_SW: J8.2, LP1.2
PEDAL_IN: J3.2, PED1.SIG
PEDAL_VCC: J3.1, PED1.V+
RL_M_NEG: C203.2, J7.2, M3.2 (-)
RL_M_POS: C203.1, J7.1, M3.1 (+)
RR_M_NEG: C204.2, J7.4, M4.2 (-)
RR_M_POS: C204.1, J7.3, M4.1 (+)
SEAT: J10.8, SW5.1 (A)
SHIFT_FORWARD: J4.1, SW2.1 (A)
SHIFT_REVERSE: J4.2, SW3.1 (A)
SPK_ALERT_N: J11.6, LS1.2
SPK_ALERT_P: J11.5, LS1.1
SPK_L_N: J12.2, LS2.2
SPK_L_P: J12.1, LS2.1
SPK_R_N: J12.4, LS3.2
SPK_R_P: J12.3, LS3.1
STEER_M_NEG: C205.2, J5.2, M5.2 (-)
STEER_M_POS: C205.1, J5.1, M5.1 (+)
WHEEL_SPEED_L: H1.3 (OUT), J10.3
WHEEL_SPEED_R: H2.3 (OUT), J10.4

Notes on the sheet:
Battery and key
Pedal and shifter
Front motors
Rear motors
Steering motor, E-stop
Horn and lights
Going back to stock
1. Key off. Unplug J1-J8 from the box. 2. Plug the stock HY2005RX controller into the same plugs (motor splitters: unplug, rejoin). 3. Unplug J9-J12; the stock car has none of them. No stock wire is ever cut (#33).
Sensors
Dash
Music
Left: what stays in the car (stock parts and our off-box parts). Right of each plug: into the box.
Plugs facing the stock harness (J1-J8) are TBD until the stock plug photos (#17).
J9-J12 are our own sealed plugs.
