ShaiMiz/RideOnESP32/docs/hardware/kicad/i2c_io.kicad_sch

## KiCad design docs/hardware/kicad/i2c_io.kicad_sch (2026-10-25)

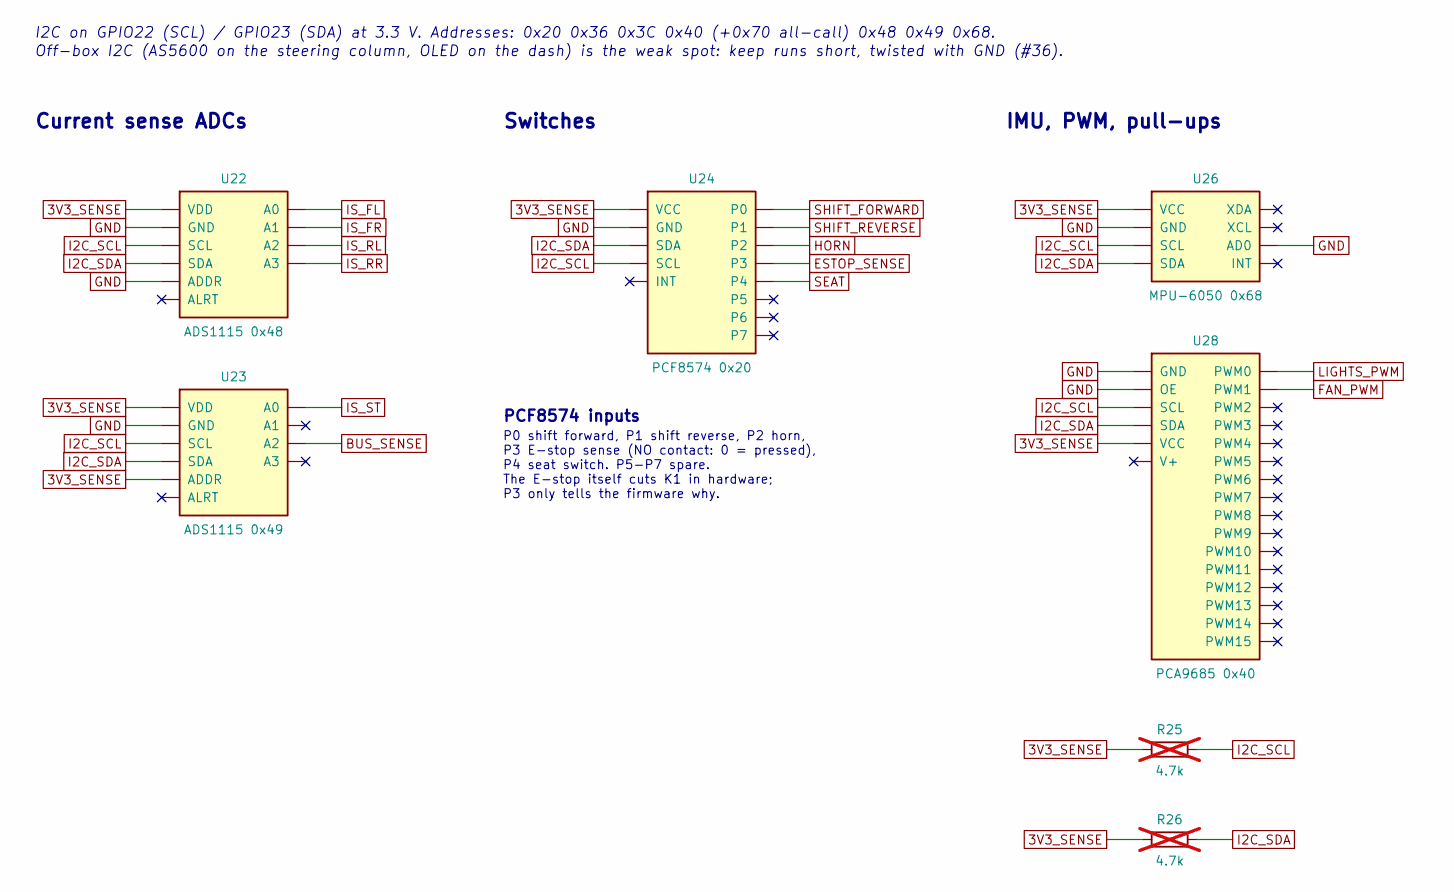
[picture p11: schematic i2c_io.kicad_sch]

Parts:
R25, R26: 4.7k; Part Resistor 4.7k, metal film 1 %, 0.25 W; not fitted
U22: ADS1115 0x48; Part ADS1115 module
U23: ADS1115 0x49; Part ADS1115 module
U24: PCF8574 0x20; Part PCF8574 module, A2-A0 jumpers all to GND
U26: MPU-6050 0x68; Part GY-521 MPU-6050
U28: PCA9685 0x40; Part PCA9685 16-channel PWM board

Connections:
3V3_SENSE: R25.1, R26.1, U22.VDD, U23.ADDR, U23.VDD, U24.VCC, U26.VCC, U28.VCC
BUS_SENSE: U23.A2
ESTOP_SENSE: U24.P3
FAN_PWM: U28.PWM1
GND: U22.ADDR, U22.GND, U23.GND, U24.GND, U26.AD0, U26.GND, U28.GND, U28.OE
HORN: U24.P2
I2C_SCL: R25.2, U22.SCL, U23.SCL, U24.SCL, U26.SCL, U28.SCL
I2C_SDA: R26.2, U22.SDA, U23.SDA, U24.SDA, U26.SDA, U28.SDA
IS_FL: U22.A0
IS_FR: U22.A1
IS_RL: U22.A2
IS_RR: U22.A3
IS_ST: U23.A0
LIGHTS_PWM: U28.PWM0
SEAT: U24.P4
SHIFT_FORWARD: U24.P0
SHIFT_REVERSE: U24.P1

Notes on the sheet:
Current sense ADCs
Switches
PCF8574 inputs
P0 shift forward, P1 shift reverse, P2 horn, P3 E-stop sense (NO contact: 0 = pressed), P4 seat switch. P5-P7 spare. The E-stop itself cuts K1 in hardware; P3 only tells the firmware why.
IMU, PWM, pull-ups
I2C on GPIO22 (SCL) / GPIO23 (SDA) at 3.3 V. Addresses: 0x20 0x36 0x3C 0x40 (+0x70 all-call) 0x48 0x49 0x68.
Off-box I2C (AS5600 on the steering column, OLED on the dash) is the weak spot: keep runs short, twisted with GND (#36).
