ShaiMiz/RideOnESP32/docs/hardware/kicad/power.kicad_sch

## KiCad design docs/hardware/kicad/power.kicad_sch (2026-11-06)

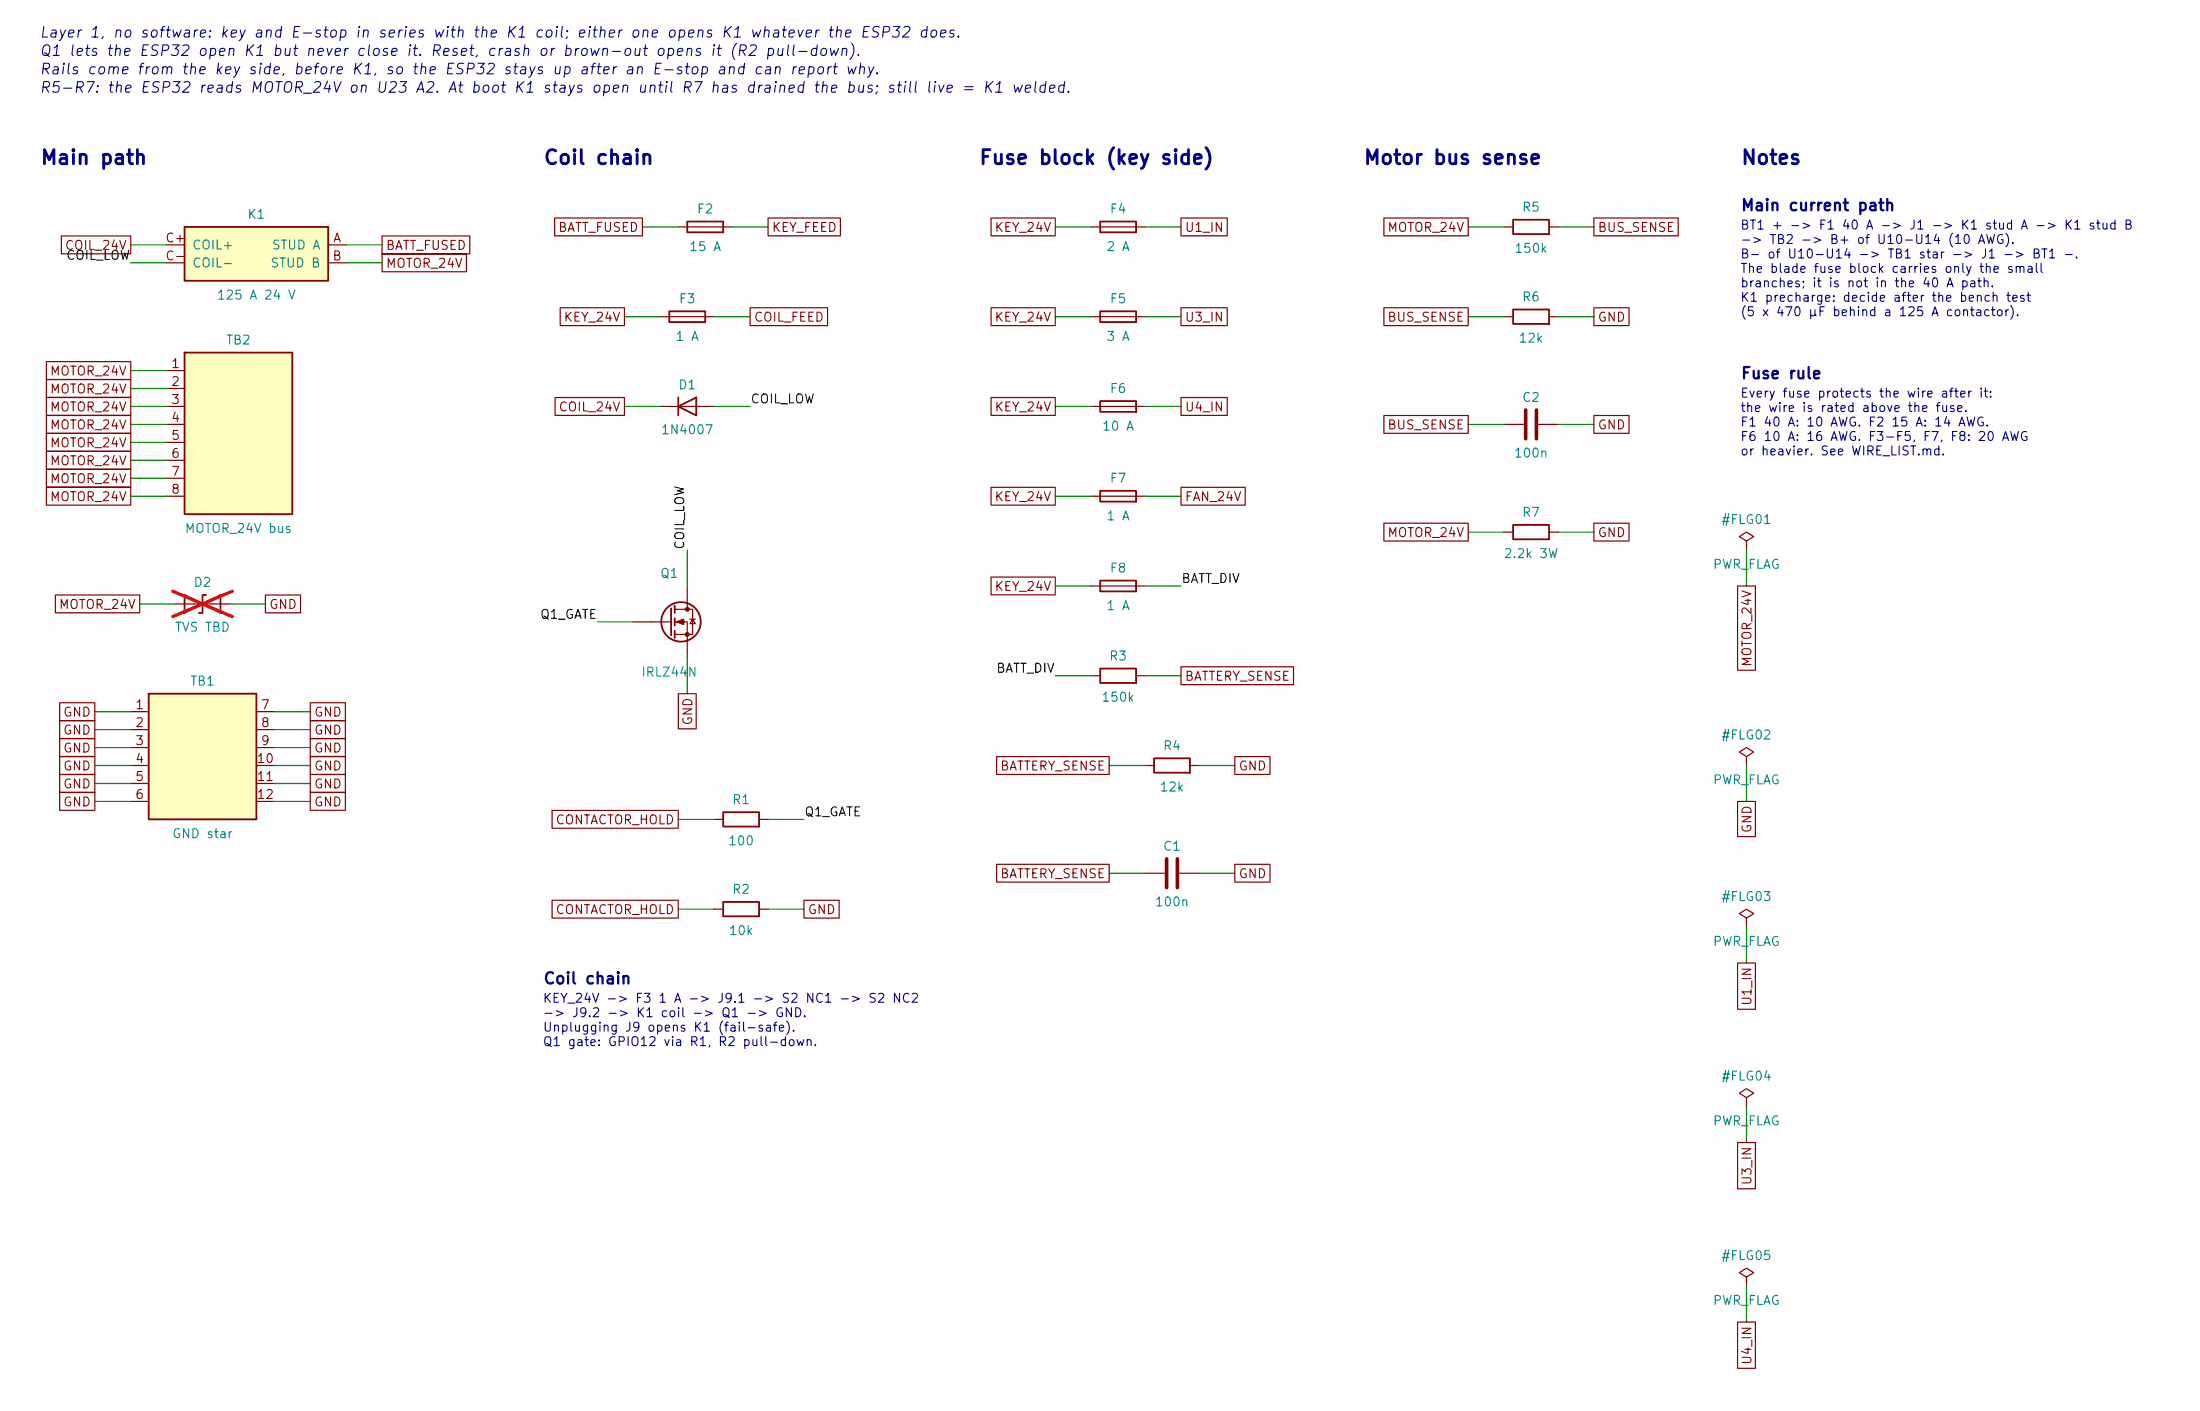
[picture p12: schematic power.kicad_sch]

Parts:
C1, C2: 100n; Part Ceramic capacitor 100n, 50 V
D1: 1N4007; Part 1N4007, flyback across the K1 coil
D2: TVS TBD; Part Unidirectional TVS across MOTOR_24V, vo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; not fitted
F2: 15 A; Part Inline blade fuse holder (12 AWG) + 15 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
F3, F7, F8: 1 A; Part Blade fuse 1 A in the fuse block
F4: 2 A; Part Blade fuse 2 A in the fuse block
F5: 3 A; Part Blade fuse 3 A in the fuse block
F6: 10 A; Part Blade fuse 10 A in the fuse block
K1: 125 A 24 V; Part Taiye TSW-80/24V DC contactor (SW80 typ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
Q1: IRLZ44N; Part IRLZ44N logic-level N-MOSFET, TO-220
R1: 100; Part Resistor 100, metal film 1 %, 0.25 W
R2: 10k; Part Resistor 10k, metal film 1 %, 0.25 W
R3, R5: 150k; Part Resistor 150k, metal film 1 %, 0.25 W
R4, R6: 12k; Part Resistor 12k, metal film 1 %, 0.25 W
R7: 2.2k 3W; Part Resistor 2.2k, 3 W wirewound or metal o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
TB1: GND star; Part M6 brass stud or bus bar: the one groun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
TB2: MOTOR_24V bus; Part M6 stud or bus bar after K1 stud B

Connections:
BATTERY_SENSE: C1.1, R3.2, R4.1
BATT_DIV: F8.2, R3.1
BATT_FUSED: F2.1, K1.A (STUD A)
BUS_SENSE: C2.1, R5.2, R6.1
COIL_24V: D1.1 (K), K1.C+ (COIL+)
COIL_FEED: F3.2
COIL_LOW: D1.2 (A), K1.C- (COIL-), Q1.D
CONTACTOR_HOLD: R1.1, R2.1
FAN_24V: F7.2
GND: C1.2, C2.2, D2.2 (A2), Q1.S, R2.2, R4.2, R6.2, R7.2, TB1.1, TB1.2, TB1.3, TB1.4, TB1.5, TB1.6, TB1.7, TB1.8, TB1.9, TB1.10, TB1.11, TB1.12
KEY_24V: F3.1, F4.1, F5.1, F6.1, F7.1, F8.1
KEY_FEED: F2.2
MOTOR_24V: D2.1 (A1), K1.B (STUD B), R5.1, R7.1, TB2.1, TB2.2, TB2.3, TB2.4, TB2.5, TB2.6, TB2.7, TB2.8
Q1_GATE: Q1.G, R1.2
U1_IN: F4.2
U3_IN: F5.2
U4_IN: F6.2

Notes on the sheet:
Main path
Coil chain
KEY_24V -> F3 1 A -> J9.1 -> S2 NC1 -> S2 NC2 -> J9.2 -> K1 coil -> Q1 -> GND. Unplugging J9 opens K1 (fail-safe). Q1 gate: GPIO12 via R1, R2 pull-down.
Fuse block (key side)
Motor bus sense
Notes
Main current path
BT1 + -> F1 40 A -> J1 -> K1 stud A -> K1 stud B -> TB2 -> B+ of U10-U14 (10 AWG). B- of U10-U14 -> TB1 star -> J1 -> BT1 -. The blade fuse block carries only the small branches; it is not in the 40 A path. K1 precharge: decide after the bench test (5 x 470 µF behind a 125 A contactor).
Fuse rule
Every fuse protects the wire after it: the wire is rated above the fuse. F1 40 A: 10 AWG. F2 15 A: 14 AWG. F6 10 A: 16 AWG. F3-F5, F7, F8: 20 AWG or heavier. See WIRE_LIST.md.
Layer 1, no software: key and E-stop in series with the K1 coil; either one opens K1 whatever the ESP32 does.
Q1 lets the ESP32 open K1 but never close it. Reset, crash or brown-out opens it (R2 pull-down).
Rails come from the key side, before K1, so the ESP32 stays up after an E-stop and can report why.
R5-R7: the ESP32 reads MOTOR_24V on U23 A2. At boot K1 stays open until R7 has drained the bus; still live = K1 welded.
