ShaiMiz/RideOnESP32/docs/hardware/kicad/rails.kicad_sch

## KiCad design docs/hardware/kicad/rails.kicad_sch (2026-10-24)

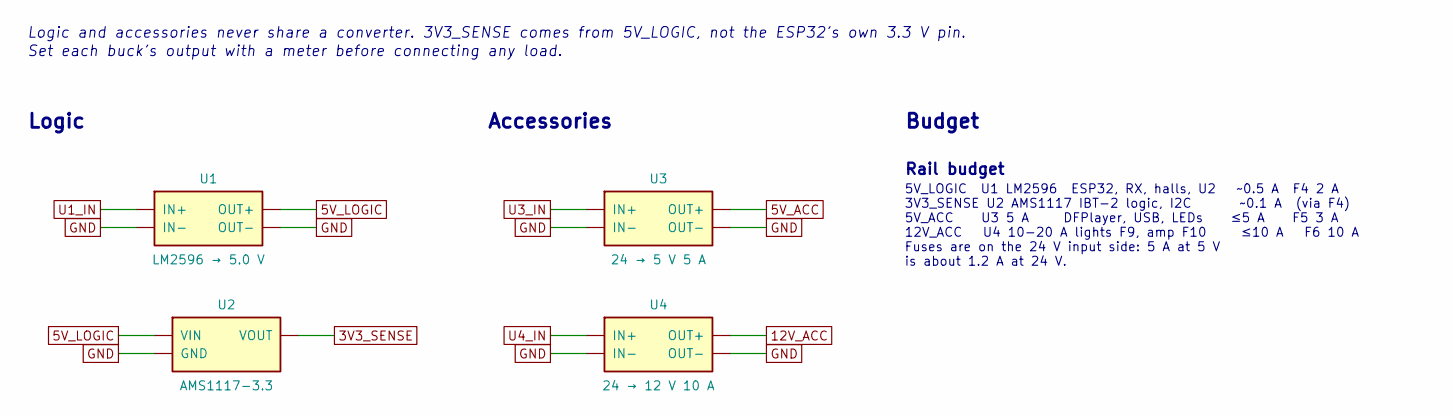
[picture p13: schematic rails.kicad_sch]

Parts:
U1: LM2596 → 5.0 V; Part LM2596 buck module set to 5.0 V (set it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
U2: AMS1117-3.3; Part AMS1117-3.3 module
U3: 24 → 5 V 5 A; Part 24 to 5 V 5 A buck module
U4: 24 → 12 V 10 A; Part 24 to 12 V 10-20 A sealed buck

Connections:
3V3_SENSE: U2.VOUT
5V_ACC: U3.OUT+
5V_LOGIC: U1.OUT+, U2.VIN
12V_ACC: U4.OUT+
GND: U1.IN-, U1.OUT-, U2.GND, U3.IN-, U3.OUT-, U4.IN-, U4.OUT-
U1_IN: U1.IN+
U3_IN: U3.IN+
U4_IN: U4.IN+

Notes on the sheet:
Logic
Accessories
Budget
Rail budget
5V_LOGIC U1 LM2596 ESP32, RX, halls, U2 ~0.5 A F4 2 A 3V3_SENSE U2 AMS1117 IBT-2 logic, I2C ~0.1 A (via F4) 5V_ACC U3 5 A DFPlayer, USB, LEDs ≤5 A F5 3 A 12V_ACC U4 10-20 A lights F9, amp F10 ≤10 A F6 10 A Fuses are on the 24 V input side: 5 A at 5 V is about 1.2 A at 24 V.
Logic and accessories never share a converter. 3V3_SENSE comes from 5V_LOGIC, not the ESP32's own 3.3 V pin.
Set each buck's output with a meter before connecting any load.
