ShaiMiz/RideOnESP32/docs/hardware/kicad/variant_b/drive_b.kicad_sch

## KiCad design docs/hardware/kicad/variant_b/drive_b.kicad_sch (2026-11-10)

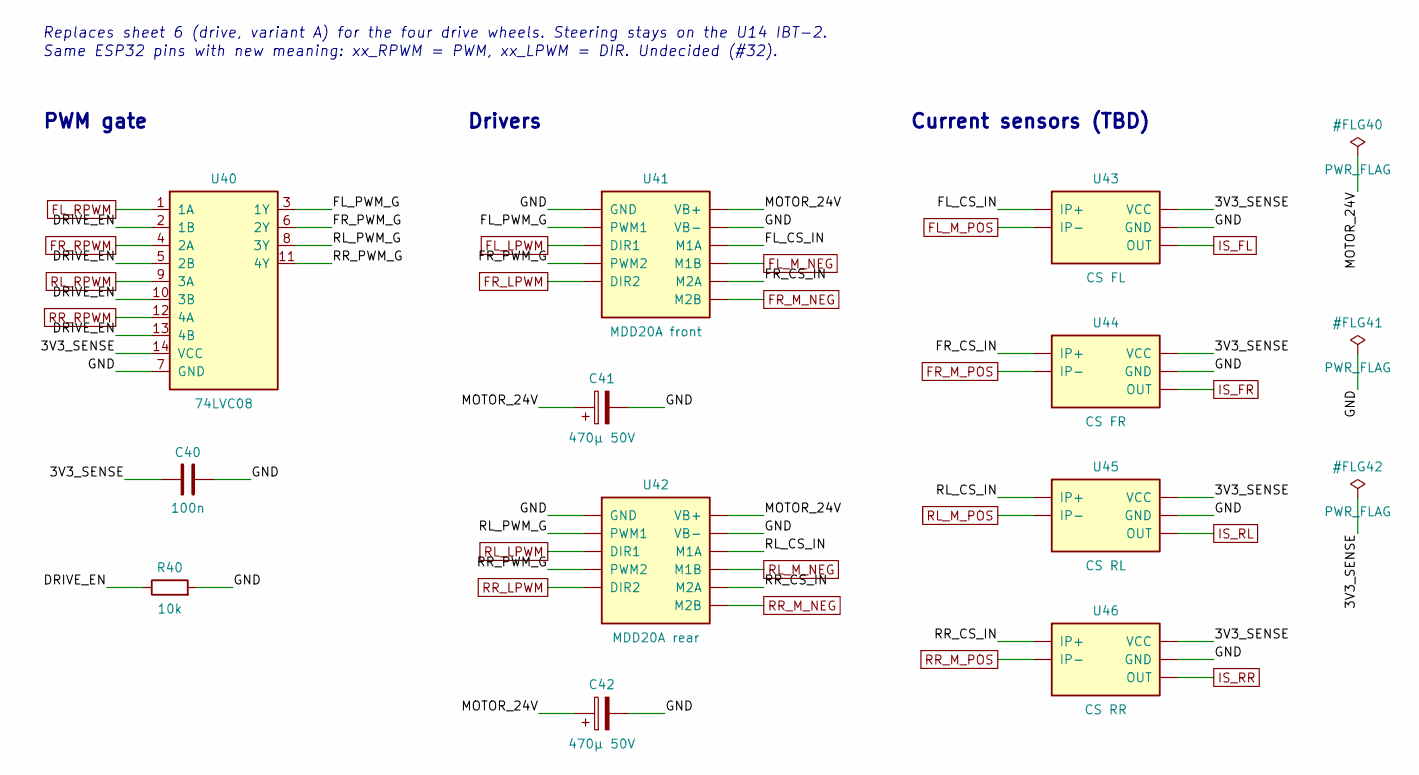
[picture p14: schematic drive_b.kicad_sch]

Parts:
C40: 100n; Part Ceramic capacitor 100n, 50 V
C41, C42: 470µ 50V; Part Electrolytic 470 µF 50 V low-ESR
R40: 10k; Part Resistor 10k, metal film 1 %, 0.25 W
U40: 74LVC08; Part 74LVC08 quad AND
U41: MDD20A front; Part Cytron MDD20A
U42: MDD20A rear; Part Cytron MDD20A
U43: CS FL; Part Hall current sensor, 3.3 V output (e.g.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
U44: CS FR; Part Hall current sensor, 3.3 V output (e.g.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
U45: CS RL; Part Hall current sensor, 3.3 V output (e.g.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
U46: CS RR; Part Hall current sensor, 3.3 V output (e.g.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

Connections:
3V3_SENSE: C40.1, U40.14 (VCC), U43.VCC, U44.VCC, U45.VCC, U46.VCC
DRIVE_EN: R40.1, U40.2 (1B), U40.5 (2B), U40.10 (3B), U40.13 (4B)
FL_CS_IN: U41.M1A, U43.IP+
FL_LPWM: U41.DIR1
FL_M_NEG: U41.M1B
FL_M_POS: U43.IP-
FL_PWM_G: U40.3 (1Y), U41.PWM1
FL_RPWM: U40.1 (1A)
FR_CS_IN: U41.M2A, U44.IP+
FR_LPWM: U41.DIR2
FR_M_NEG: U41.M2B
FR_M_POS: U44.IP-
FR_PWM_G: U40.6 (2Y), U41.PWM2
FR_RPWM: U40.4 (2A)
GND: C40.2, C41.2, C42.2, R40.2, U40.7 (GND), U41.GND, U41.VB-, U42.GND, U42.VB-, U43.GND, U44.GND, U45.GND, U46.GND
IS_FL: U43.OUT
IS_FR: U44.OUT
IS_RL: U45.OUT
IS_RR: U46.OUT
MOTOR_24V: C41.1, C42.1, U41.VB+, U42.VB+
RL_CS_IN: U42.M1A, U45.IP+
RL_LPWM: U42.DIR1
RL_M_NEG: U42.M1B
RL_M_POS: U45.IP-
RL_PWM_G: U40.8 (3Y), U42.PWM1
RL_RPWM: U40.9 (3A)
RR_CS_IN: U42.M2A, U46.IP+
RR_LPWM: U42.DIR2
RR_M_NEG: U42.M2B
RR_M_POS: U46.IP-
RR_PWM_G: U40.11 (4Y), U42.PWM2
RR_RPWM: U40.12 (4A)

Notes on the sheet:
PWM gate
Drivers
Current sensors (TBD)
Replaces sheet 6 (drive, variant A) for the four drive wheels. Steering stays on the U14 IBT-2.
Same ESP32 pins with new meaning: xx_RPWM = PWM, xx_LPWM = DIR. Undecided (#32).
