ShaiMiz/RideOnESP32/radio/edgetx/sdcard/MODELS/model42.yml

semver: 2.12.5
header:
  name: "RideOn"
  modelId:
    0:
      val: 42
disableThrottleWarning: 1
switchWarningState: AuBuCu
mixData:
  - destCh: 0
    srcRaw: Ail
    weight: 100
    carryTrim: 1
    mltpx: ADD
    name: "Steer"
  - destCh: 1
    srcRaw: Ele
    weight: 100
    carryTrim: 1
    mltpx: ADD
    name: "Thrtl"
  - destCh: 2
    srcRaw: Thr
    weight: 100
    carryTrim: 1
    mltpx: ADD
    name: "unused"
  - destCh: 3
    srcRaw: Rud
    weight: 100
    carryTrim: 1
    mltpx: ADD
    name: "unused"
  - destCh: 4
    srcRaw: SC
    weight: 100
    mltpx: ADD
    name: "Kill"
  - destCh: 5
    srcRaw: SA
    weight: 100
    mltpx: ADD
    name: "Mode"
  - destCh: 6
    srcRaw: SB
    weight: 100
    mltpx: ADD
    name: "KidCap"
  - destCh: 7
    srcRaw: MAX
    weight: -100
    mltpx: ADD
    name: "Horn"
  - destCh: 7
    srcRaw: MAX
    weight: 100
    swtch: TrimRudLeft
    mltpx: REPL
    name: "Horn"
  - destCh: 7
    srcRaw: MAX
    weight: 100
    swtch: TrimRudRight
    mltpx: REPL
    name: "Horn"
customFn:
  0:
    swtch: "ON"
    func: LOGS
    def: "5,1"
flightModeData:
  0:
    trim:
      0:
        value: 0
        mode: 31
      1:
        value: 0
        mode: 31
      2:
        value: 0
        mode: 31
      3:
        value: 0
        mode: 31
    name: ""
    swtch: "NONE"
    fadeIn: 0
    fadeOut: 0
moduleData:
  0:
    type: TYPE_CROSSFIRE
    subType: 0
    channelsStart: 0
    channelsCount: 16
    failsafeMode: NOT_SET
    mod:
      crsf:
        telemetryBaudrate: 0
        crsfArmingMode: 0
  1:
    type: TYPE_NONE
telemetrySensors:
  0:
    id1:
      id: 20
    id2:
      instance: 0
    label: "1RSS"
    subId: 0
    type: TYPE_CUSTOM
    unit: 29
    prec: 0
    logs: 1
  1:
    id1:
      id: 20
    id2:
      instance: 2
    label: "RQly"
    subId: 0
    type: TYPE_CUSTOM
    unit: 13
    prec: 0
    logs: 1
  2:
    id1:
      id: 20
    id2:
      instance: 3
    label: "RSNR"
    subId: 0
    type: TYPE_CUSTOM
    unit: 17
    prec: 0
    logs: 1
  3:
    id1:
      id: 20
    id2:
      instance: 6
    label: "TPWR"
    subId: 0
    type: TYPE_CUSTOM
    unit: 16
    prec: 0
    logs: 1
  4:
    id1:
      id: 20
    id2:
      instance: 8
    label: "TQly"
    subId: 0
    type: TYPE_CUSTOM
    unit: 13
    prec: 0
    logs: 1
  5:
    id1:
      id: 8
    id2:
      instance: 0
    label: "RxBt"
    subId: 0
    type: TYPE_CUSTOM
    unit: 1
    prec: 1
    logs: 1
  6:
    id1:
      id: 8
    id2:
      instance: 1
    label: "Curr"
    subId: 0
    type: TYPE_CUSTOM
    unit: 2
    prec: 1
    logs: 1
  7:
    id1:
      id: 8
    id2:
      instance: 2
    label: "Capa"
    subId: 0
    type: TYPE_CUSTOM
    unit: 14
    prec: 0
    logs: 1
  8:
    id1:
      id: 8
    id2:
      instance: 3
    label: "Bat%"
    subId: 0
    type: TYPE_CUSTOM
    unit: 13
    prec: 0
    logs: 1
  9:
    id1:
      id: 33
    id2:
      instance: 0
    label: "FM"
    subId: 0
    type: TYPE_CUSTOM
    unit: 42
    prec: 0
    logs: 1
screens:
  0:
    type: SCRIPT
    u:
      script:
        file: "rideon"
