ShaiMiz/RideOnESP32/(commit log)

2025-12-29 Update README with voltage requirements
    Added voltage requirements for ESP32 and future components.
2026-10-17 Rebuild as a PlatformIO v3 project with a tested safety core
    Restructure the repository around firmware v3.0. The car firmware is
    src/main.cpp, built on the v2.2 BTS7960Motor class. Safety and control
    logic (modes, arming, fault latch, link monitor, ramps, battery checks)
    lives in lib/rideon_core with no Arduino calls and has 32 PC unit tests.
    Bench firmwares cover build phases 2 and 4. New docs follow the hardware
    plan, and the v2 sketches, docs and PDFs move to archive/ unchanged.
    Claude-Session: https://claude.ai/code/session_01TjdJgf7aB7RPYP48TNMHi1
2026-10-17 Add a firmware and configuration guide for every device
    Covers flashing the ESP32, EdgeTX on the T-Lite, ExpressLRS on the
    radio module and the AION RX Mini, the AS5600 OTP limits, and setup for
    the modules that have no firmware. Linked from the README, ELRS setup
    and commissioning phase 2.
    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
2026-10-17 BOM: add enclosure, fans and wiring consumables
    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
2026-10-17 Audit the pin map and check it on every build
    Checked every pin against the ESP32-WROOM-32D datasheet, the ESP32 errata
    and photos of the actual 30-pin board.
    - Wheel-speed inputs move to GPIO34/35: GPIO36/39 read a false LOW for
    ~80 ns every time the ADC powers up, which would add phantom ticks.
    Pedal moves to GPIO36 and battery sense to GPIO39 (analog is unaffected).
    - GPIO15 becomes the DS18B20 1-Wire line, as in the draft schematic.
    - New include/board_esp32_devkit30.h (what each GPIO can do) and
    include/pin_rules.h; pins.h runs the rules as static_asserts, so a
    duplicate or misplaced pin stops every build.
    - test/test_pins names the offending pin and proves each rule fires.
    - d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
2026-10-17 Battery: clear the high-voltage warning on a sensor fault
    A broken divider kept the last high reading's warning set.
    Claude-Session: https://claude.ai/code/session_01FRwZBbD3EfMpXgR6wVuayK
2026-10-17 one_motor: add the task watchdog
    The bench firmware drives a real motor but had no watchdog, so a hung loop
    kept the last PWM with the drive enable high. The watchdog moves out of
    main.cpp into safety/Watchdog so both firmwares share it.
    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
2026-10-17 Latch an ESTOP fault so releasing the E-stop cannot restart the car
    The E-stop cuts the contactor coil in hardware, but the ESP32 stays powered
    and never read the E-stop sense input. With the pedal held, the ramp kept
    climbing and the car drove off at that speed the moment the button was
    released. The sense input now raises ESTOP: coast, drive enable LOW, and the
    contactor held open until the parent re-arms from Locked.
    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
2026-10-17 Driver fault: wait 300 ms before tripping, and watch the steering board
    With a 1k IS resistor, about 27 A of ordinary start-up inrush also pins the IS
    line at the 3.3 V clamp, so DRIVER tripped at once and defeated the 300 ms
    inrush allowance that OVERCUR has. A real driver fault keeps the line pinned
    and the driver has already turned itself off, so the same hold loses nothing.
    The steering board's IS line was sampled but never checked, so a steering
    driver fault went unnoticed. It now raises DRIVER too.
    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
2026-10-17 Current sensing: check every I2C transfer and fault when readings go stale
    PowerMonitor trusted the Adafruit driver, which reports no I2C errors. With
    the bus stuck or an ADS1115 unplugged, the last current values stayed in
    place, or the driver's buffer came back as a reading, and over-current and
    driver-fault protection were silently gone. A conversion that never finished
    also stalled the channel rotation for good.
    Now the ADS1115 is driven directly through Wire with every transfer checked,
    a conversion that takes over 20 ms is abandoned, a channel that fails is
    skipped, and a channel with no good reading for 250 ms raises CUR_SENS
    (brake, then re-arm). The I2C timeout drops to 5 ms so a s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
2026-10-17 Radio: find RC frames the same way AlfredoCRSF does
    The packet-age tap reset to the start after any bad frame, while AlfredoCRSF
    drops one byte and looks again. A stray sync byte with a long length made the
    tap swallow the next real frame that the library accepted, and partial frames
    were never dropped after a gap. Missed frames age the link and trip LINK
    while the radio is fine. The detector moves to rideon_core with unit tests,
    including the false-start case the old tap missed.
    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
2026-10-17 Docs: add the draft schematic, safety-standards review and audio plan
    Claude-Session: https://claude.ai/code/session_01EFp95nSrH46H5JzWCJhiWe
2026-10-24 Schematic v0.3 in KiCad: nets, connector pinouts, wire list, BOM matched to the 24 Oct order
    Generated from gen/design.py and gen/wiring.py, with the ESP32 nets read
    from include/pins.h. KiCad ERC is clean and KiCad's netlist is checked
    against the design (check.sh). CI regenerates and fails on stale files.
    Safety changes from draft v0.2: both E-stop NC blocks in the contactor
    coil, an enable pull-down at every driver, a protected pedal supply,
    fuses on the 12 V outputs, a TVS placeholder on the motor bus.
    Also adds a v2-vs-v3 hardware comparison (docs/reviews).
    Claude-Session: https://claude.ai/code/session_01BSRw381bu7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
2026-10-24 Schematic index: say what each sheet box holds and how to open it
    The sheet symbols on page 1 were empty boxes, which read as missing
    content. Each now carries a short summary of its sheet.
    Claude-Session: https://claude.ai/code/session_01BSRw381bu7GTvawcDjL4S1
2026-10-24 Schematic: add a system wiring overview page (every assembly joined on one A2 sheet)
    Page 2 is a drawing-only overview generated by gen/overview.py; the net
    sheets move to pages 3-9. ERC and the netlist check are unchanged.
    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
2026-10-25 Match the firmware to schematic v0.3: current scaling, contactor checks, fans
    - Current sense divides by half the per-pin IS resistor (IS_PIN_RESISTOR_OHMS),
    since R_IS and L_IS are joined; it read about half the real current before.
    The DRIVER level now comes from the resistor (1.8 V with 1k boards).
    - DRIVER and OVERCUR open the contactor: a shorted MOSFET ignores DRIVE_EN.
    The drive enable drops before the contactor opens.
    - Motor-bus sense: R5-R7 in the schematic (150k/12k to ADS1115 #2 A2, 2.2k
    bleed). New ContactorCheck: K1 stays open at boot until the bus drains
    (K1_WELD if it doesn't, permanent), and NO_BUS when K1 is held closed with
    no bus.
    - I2C at 100 kHz, the PCF8574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
2026-10-25 BOM: one list for every part, tool and material, with value and premium picks and search links
    Adds the tools and materials (ordered, owned, still to buy) to the generated
    BOM, with a value pick, a premium pick and an AliExpress search per item to
    buy, and search links and specs for the phase 5 parts still to buy.
2026-10-25 BOM: one numbered line per distinct part, with manufacturer / part number, status, order line and cost
    Same parts share a line (the four drive IBT-2s and the steering one are one line, 4 owned and 1 to buy).
    Adds a revision header, a status legend and the 24 Oct order cost by line (1,081.76 ILS, checked against the
    receipt). The owned spares from the old docs/hardware/BOM.md move in, and that file now points here.
2026-10-25 Add a 3D exploded view of the car, generated from the BOM and wire list
    tools/exploded-view is a React Three Fiber app. scripts/build_data.py reads
    BOM.csv, WIRE_LIST.csv, CONNECTORS.md, PINOUT.md, CAR.md and design.py
    into src/data/project.json; layout.js places each ref. Every mesh is
    procedural.
    Realistic (PBR) and blueprint (edge line-art on a grid) styles, a show/hide
    tree, tiered explode that closes gaps for hidden tiers, dashed disassembly
    paths, live wire routing, info cards with upstream/downstream wiring from
    the wire list, variant A/B drive swap, part moves, revision history, and
    GLB/glTF/PNG/PDF/JSON export. Car-facing plugs J1-J8 and the box size are
    marked TBD (#17, #18). CI r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
2026-10-25 Safety review v2: mandatory vs optional items, fixes and priorities
    Sorts every safety item into what the standards require of a sold ride-on
    (EN 71-1 / SI 562-1, EN 62115, ASTM F963 4.25) and what goes beyond them,
    using two published lab reports to show what factories actually test.
    Lists a fix (code, parts or test) for each open mandatory item and ranks
    them by concern and complexity. Corrects v1: radio power is already capped
    at 100 mW in ELRS_SETUP.md.
2026-10-25 exploded view: restyle the body like the real car, rename the model
    Gloss black shell, red mesh grilles, sand RS door panels and rear quarters,
    open black tube cage, red coil-over shocks, black seats with red bolsters,
    knobby tyres on red beadlock rims, slim LED headlights, front bumper with a
    red tow hook. CAR.md model is now "Can-Am Maverick X3 24V Ride-On Buggy";
    the title bar reads it from the data.
2026-10-25 exploded view: add a compact packaging option
    Variant B drive (2 x MDD20A) in a ~18 x 12 x 6 cm main box, the contactor
    pack next to the battery, and the 12 V buck, music amp, MOSFET board and
    their fuses in a small accessory box behind the seats. Sizes are estimates
    until the under-seat measurements (#18). A test checks every box part fits.
2026-10-26 Event log records, per-part fault reports and a fault table
    Every boot, fault trip, fault end, re-arm, mode, link and battery change is
    now a 32-byte record with a CRC: boot number, uptime, severity (RFC 5424
    numbers), category, part, symptom and values. The car prints each as one
    line on serial; flash storage comes next.
    - rideon_core: EventLog (record, CRC, text format, a queue that drops the
    least severe record first and counts drops), FaultReport (which part a
    fault came from), FaultTable (one row per fault and part with count,
    first/last seen, worst value, two freeze frames, ISO 14229 status bits)
    and Recorder (turns loop-to-loop changes into records and rows).
    - SafetyManager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
2026-10-26 Store the event log and fault table on flash
    The log now survives power-off. Records go to a ring in a new 256 KB
    `evlog` flash partition, the fault table to NVS, and a panic or watchdog
    reset leaves an ESP-IDF crash dump that the next boot logs.
    - rideon_core LogRing: 32-byte records over 4 KB sectors behind a
    FlashDevice interface. Finds the newest record by sequence number after
    a power cut, skips torn records, never erases the sector being written,
    and erases only when asked.
    - EventSink: mounts the ring at boot (wiping old bytes once after the
    layout change), keeps 8 sectors erased ahead, writes 2 records per tick,
    and erases or saves the fault table only when the car is Lock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
2026-10-27 Fix the verify job on the newer CI runner's cppcheck
    GitHub's ubuntu-latest moved to cppcheck 2.19, which adds two checks the
    2.13 run on the PR did not have: dangerousTypeCast on three byte views of
    a LogRecord (now reinterpret_cast) and functionStatic on hardware classes
    and stubs (a style preference, now suppressed like cstyleCast). The script
    prints the cppcheck version it ran.
2026-10-27 Add a crash recorder and a read-only serial console
    The last 5 s of freeze frames (100 ms apart) live in RTC memory. A hard
    fault or a panic, watchdog or brownout reset while driving keeps a copy,
    saved to NVS with the car stopped and logged as CRASH_SAVED. The serial
    console lists the log, fault table and saved crash; clearing the table
    and the watchdog test need the car stopped. It cannot arm, drive or
    change a limit.
    SR-30 and SR-31 with tests, three new mutants, commissioning gates in
    phases 3 and 5, LOG_EVENTS rows for CRASH_SAVED and DTC_CLEARED.
2026-10-27 Send battery, current and status telemetry to the radio (#38)
    The car now sends a CRSF battery frame (voltage, drive current, charge
    used) and a flight-mode text with the mode and the first latched fault,
    e.g. LOCKED ESTOP. EdgeTX shows them as RxBt, Curr, Capa and FM.
    Frames and timing live in rideon::TelemetryScheduler with tests: at most
    5 frames a second, the status first and at once on a change, nothing
    without a link. The glue writes a frame only when the UART has room, so
    telemetry never delays the loop. EdgeTX sensor setup and alarms in
    radio/MODEL_SETUP.md.
2026-10-28 Add the listen-only Bluetooth log module
    An HC-06 module (U33) hears TX0, the USB serial log, through a 1k
    resistor (R29); its TXD is not connected, so nothing on a phone can reach
    the ESP32, whose own Wi-Fi and Bluetooth stay off. An Android phone reads
    the live log with a serial terminal app.
    The phone can't type, so holding the horn for 3 s with the car Locked or
    Killed and stopped prints a full report: status, fault table, crash copy
    and the last 50 records. `report` on the console does the same. The
    trigger is in rideon_core with tests, under SR-31, plus a mutant.
    New bt_setup bench firmware sets the module to 115200 baud and a PIN
    before it goes in the box. Schematic, wire list, BOM,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
2026-10-28 Switch the Bluetooth log module to BLE (HM-10) for iPhone and Android
    The HC-06 is Bluetooth Classic, which iPhones can't use. The HM-10 (CC2541)
    is BLE, which both iPhone and Android support. Same wiring: RXD on TX0
    through R29, TXD not connected.
    bt_setup now speaks the HM-10 dialect (genuine and the common clones):
    finds the baud rate, names it RideOn, sets 115200, restarts it and checks.
    No PIN: HM-10 pairing PINs are unreliable on iPhones and clones, and the
    log holds no personal data.
    A BLE link passes on about 2 KB/s, so the horn-triggered report prints one
    line per 100 ms. A typed report on USB stays at full speed.
2026-10-28 Make the link-loss stop requirement 0.75 s to zero output
    SAFETY.md asked for a stop within 0.5 s of the radio going off, which the
    firmware never met: 200 ms to call the link lost plus 0.5 s of braking
    from full, about 0.72 s. Shai chose to change the requirement rather than
    brake harder (rougher on the child) or time out sooner (trips on normal
    dropouts).
    SR-26 now reads 0.75 s to zero output, and the full-speed link-loss test
    checks it, so a config.h change that breaks it fails CI. SAFETY.md,
    COMMISSIONING.md, CONTROL_MODES.md and VERIFICATION.md updated.
2026-10-28 Re-export the schematic PDFs with the Bluetooth log module
    KiCad ERC clean on both projects and the netlist matches design.py.
2026-10-30 Safety gates follow the toy standards; add per-motor fuses F11-F14
    SAFETY.md and COMMISSIONING.md now split their checks into required
    (what a lab tests on every shop-bought ride-on: EN 71-1 / SI 562-1,
    EN 62115, ASTM F963) and recommended (beyond any factory; a failure turns
    the feature off instead of holding the project). New required checks:
    key switch rating, a fuse per drive motor, a locked-wheel heat test, a
    10 degree slope hold, top speed for the rider's age, and edges. The 0.75 s
    link-loss stop stays required.
    The schematic gets F11-F14, a 15 A placeholder blade fuse in each drive
    motor's + lead inside the box, so a single stalled motor has a hardware
    backstop below the 20 A softwar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
2026-10-30 Exploded view: place motor fuses F11-F14 and regenerate its project data
    The exploded-view check failed because project.json was stale and the new
    fuses had no layout. They sit between the drivers and the motor plugs in
    the standard box, and by the motor plugs in the compact box.
2026-11-02 Document the stock car from the first garage photos
    Battery pack with an 18 A thermal breaker and charge jack, the
    controller bay next to it, and the dashboard controls. The breaker
    stays in circuit, so the car shares 18 A sustained; the stock power
    switch is a START/STOP button, not a key. Lists the photos and
    measurements still needed with the controller cover off (#17, #18).
2026-11-04 BOM: mark the 24 Oct AliExpress order received, add AS5600 pigtail
    The order arrived on 4 Nov, so its lines move from "Ordered 24 Oct" to
    "Received 4 Nov". The AS5600 board came with a 4-pin plug but no
    cable; add an optional matching pigtail to buy (or solder to the pads).
    Claude-Session: https://claude.ai/code/session_0173QYyEsV57nC5pD2GZ96hZ
2026-11-04 BOM: the "300-2000 pcs" order line was the ferrule kit, not heat shrink
    Shai's photo shows the 2000-pc ferrule kit. Heat shrink was never in the
    order, so it moves to To buy; add a ferrule crimper to the tools.
    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
2026-11-04 BOM: order line O6 is the HS-30J crimping pliers kit
    Shai's photos show O6 ("Pre insulated terminal...") is the Lion Rage
    HS-30J 4-jaw crimper, not terminals; the terminals are O10. The
    separate ferrule crimper becomes optional.
    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
2026-11-04 BOM: yellow insulated rings cover 10 AWG, hex lug crimper optional
    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
2026-11-04 Exploded view: regenerate project.json from the updated BOM
    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
2026-11-06 BOM: K1 is a Taiye TSW-80/24V, 125 A, 24 V DC coil (from its label)
    The contactor arrived; its label confirms the 24 V DC coil and 125 A rating
    the design assumed. Coil current is still to be measured on the bench (F3).
2026-11-07 Radio setup from files: RideOn EdgeTX model, ELRS setup tool, installer
    The T-Lite no longer needs configuring by hand.
    - radio/edgetx/sdcard/MODELS/model42.yml: the RideOn model in EdgeTX 2.12
    format. Right stick steers and drives, SC kill (up = KILL), SA mode, SB
    Kid speed cap, left stick sideways horn; trims off; start-up switch
    check (SA, SB, SC up); internal CRSF module, receiver number 42 for
    Model Match; telemetry sensors made in advance; telemetry screen;
    telemetry logging every 0.5 s.
    - SCRIPTS/TELEMETRY/rideon.lua: mode and fault screen, with vibration and
    tones on a new fault, mode change, low battery, weak and lost link.
    - SCRIPTS/TOOLS/RideOnRF.lua ("RideOn ELRS set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
2026-11-07 Add the 3D T-Lite radio view: live channels, screen, mapping editor, model export
    tools/radio-view: the Jumper T-Lite V2 in React Three Fiber, reading
    model42.yml, ChannelMap.h and config.h straight from the repo. Moving a
    stick or switch shows the radio screen (a port of rideon.lua), the CRSF
    channels in microseconds and what the firmware's channel and mode rules
    make of them. A mapping editor changes which control drives each channel,
    the logical switches and the start-up check, runs the safety checks over
    every switch combination, and saves a model42.yml for install_radio.py.
    New CI job radio-view runs its tests and build.
2026-11-07 Radio view: rebuild the T-Lite to the real radio's shape and layout
    Measured off Jumper's components drawing and scaled to the published
    166 x 106 x 56 mm: gamepad outline, gimbal wells with square frames and
    knurled 25 mm sticks, ENT/RTN and UP/DOWN beside the screen, SYS/MDL under
    it, LED above the oval power key, eight trim triangles, speaker grille,
    and the switches, trainer jack, micro-SD, SMA antenna, reserved monitor
    screw holes and USB-C on the back edge. Measurements and sources live in
    src/lib/tlite.js; a new Radio tab lists the specification.
    MODEL_SETUP.md: the switches stick out of the back edge, SA above SC and
    SB above SD; up is the lever tip up.
2026-11-07 Radio controls don't cross: SR-32 tests, one-control-one-job check, horn at 80 %
    Firmware: test_each_control_changes_only_its_own_output moves each radio
    control on its own in Locked, Kid, Parent and Killed and checks that exactly
    the intended outputs change. Three SR-32 mutants in mutation_check.py.
    Radio view: controlReach() sweeps every control over all switch and stick
    positions; the checks block an edit where one control drives two functions
    or one function follows two controls. The repo model passes.
    The horn's logical switch goes from |Rud| > 50 % to 80 %, so moving the
    left stick around no longer sounds it. Docs and the phase 2 gate updated.
2026-11-07 Horn on the T1 trim buttons instead of the left stick
    The T-Lite has no spare momentary switch, so the horn was the left stick
    pushed sideways, which set it off by accident. With the trims off, EdgeTX
    lets the trim buttons act as push-button switches: CH8 is now replaced by
    +100 % while TrimRudLeft or TrimRudRight (T1- / T1+, the pair under the
    left stick) is held. No logical switches remain; the left stick drives
    nothing the car reads.
    check_radio_files.py checks the new horn lines. The radio view models the
    trim buttons as held push-buttons (3D, Live tab, H key), includes them in
    the one-control-one-job check (a trim pair counts as one control), and
    labels them.
2026-11-07 Radio view: don't keep an old repo model from an earlier visit
    The page saved the model in the browser and reloaded it on the next visit,
    so after the horn moved to the T1 trim buttons a returning visitor still
    saw the old left-stick horn. The saved copy now records the repo model it
    came from: an unedited copy of an older repo model is dropped, an edited
    one is kept with a note to reset. Old v1 saves are dropped.
2026-11-09 BOM: log the 9 Nov parts check (470 µF caps are 50 V, two ADS1115, USB-TTL set)
    The 470 µF bus caps are 50 V low-ESR per the bag, which closes the
    voltage check. Two ADS1115 bags arrived. The three 12 AWG inline fuse
    holders cover F2, F9 and F10; F11-F14 still need four more. The USB-TTL
    line is a PL2303HX + CP2102 + CH340G set. Regenerated BOM, schematic
    and the 3D view data.
2026-11-09 BOM: blade fuses, ANL, 10 AWG silicone and resistor kit checked 9 Nov
    All five blade values (1, 2, 3, 10, 15 A, 10 each) are in hand; 15 A
    covers F2 and F11-F14. The ANL holder with its 40 A fuse plus two spares
    is F1. The 10 AWG wire is 200 C silicone, 5 m red + 5 m black.
2026-11-10 BOM: direct AliExpress links for the next order (10 Nov picks)
    Value and premium listings Shai picked with Claude in Chrome on 10 Nov
    replace the searches on the phase 3-5 lines. Links render with their
    label (value, premium, fan, guard...). Notes flag what to check before
    buying: fan bearing variant, TB1's ring count, Deutsch pin type and
    crimper, the iron's power supply, 20 AWG cable length.
2026-11-10 BOM: variant to select on the 10 Nov picks (bus bar M6, glands, standoffs, Dupont kit)
    From the variant sheet Shai's Chrome pass produced: the item links match;
    add the variants whose default is the wrong size.
2026-11-10 Drop the per-motor fuses F11-F14
    Shai, 10 Nov: no room or wiring complexity for four inline motor fuses,
    and no shop ride-on has them. A stalled wheel is stopped by the firmware
    over-current limit (MOTOR_CURRENT_LIMIT_A), backed by F1 and the stock
    breaker. The clamp-meter current calibration and the locked-wheel test
    become required gates again. BOM: Shai owns 4 IBT-2, buy 1 more.
2026-11-10 BOM: AliExpress links open on the right variant (skuId)
    Shai had Claude in Chrome read each pick's skuId on 10 Nov. Every direct
    link now carries ?sku_id=..., and picks that need several variants of one
    listing get one link each (Deutsch 4P/6P/8P, glands PG9/PG13.5, solder
    0.8/1.0 mm, 22 AWG colours). The 22 AWG value listing lacks grey and
    violet, which the wire list uses, so those come from the second listing.
