ShaiMiz/RideOnESP32/(notices)

Notices in the files:
README.md:
License: MIT
